NithujanSel/CameraSliderFarmLabAI/README.md

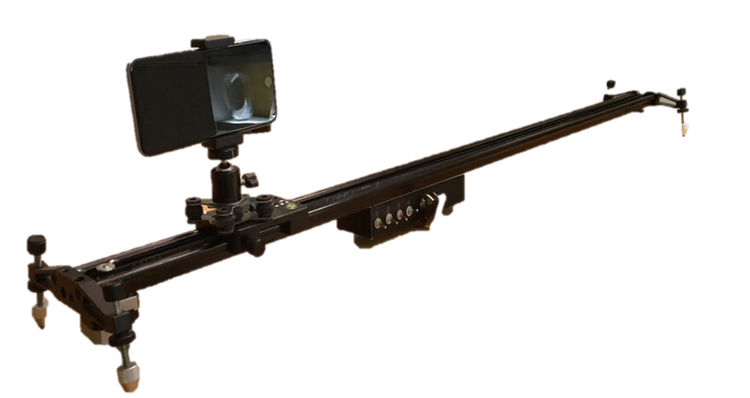
[picture p1: docs/assets/media/image1.png]


# Camera slider IoT Project

### Student 1: Nithujan Selvaratnam

### Student 2: Jesse Denaux

### Student 3: Tarun Singh

<a href="https://nithujansel.github.io/CameraSliderFarmLabAI/#/">Docsify Page</a><br>
