NithujanSel/CameraSliderFarmLabAI/docs/documentatie/index.md

# Documentatie

#  Stand

De stand moet zo ontworpen zijn zodat het profiel op een bepaalde
afstand van de grond zal gehouden worden en stevig genoeg is om het
geheel stabiel te houden. Er is gekozen om dit te 3D printen zodat de
onderzoeker vrij is in het ontwerp en snel aanpassingen kan doen indien
nodig. Het eerste ontwerp was een rechthoek waar het profiel door past
met twee beentjes die naar de grond gaan voor stabiliteit. Na een eerste
revisie werd al snel besloten om de bovenste hoeken van de rechthoek af
te kappen omdat deze geen extra nut hebben en dit enkel maar langer
duurt om te printen.

## Stand 1 v1

In het eerste ontwerp is er gekeken naar de grootte van het profiel. Om
te zien dat de stand hier vlot kan inschuiven is er een marge van 0.2 mm
genomen. Het ging hier vooral over of de stand past en of dit stevig is.
Dit is ook maar met een breedte van 1 cm geprint om ervoor te zorgen dat
dit niet zolang moest printen.

<iframe
src="https://myap83.autodesk360.com/shares/public/SH35dfcQT936092f0e43ae2769a1c0cda5d8?mode=embed"
width="640" height="480" allowfullscreen="true"
webkitallowfullscreen="true" mozallowfullscreen="true"
frameborder="0"\>\</iframe>

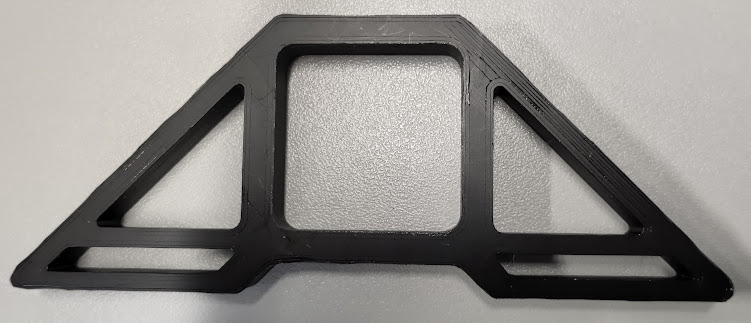
[picture p2: docs/assets/media/image6.png]
Stand 1 v1


Figuur 1: Eerste prototype profielstand 1

## Stand 1 v2

De grootte van het gat waar het profiel in past was net iets te groot.
Om dit op te lossen is het gat in de breedte en de hoogte met 0.1mm
verkleind. Voor de rest is de stevigheid van de stand perfect. Hier moet
er niets meer aan worden aangepast.

Om ervoor te zorgen dat onze slider heen en weer kan bewegen wordt er
gebruik gemaakt van een rubberen ketting. Deze ketting wordt dan met een
pulley wheel met tanden strak gehouden. Deze pulley wordt aan de stand
vastgemaakt. Hiervoor wordt er een kleine rechthoek op de stand gemaakt
waar de pulley in past.

<iframe
src="https://myap83.autodesk360.com/shares/public/SH35dfcQT936092f0e43b2dbe0e7d11261af?mode=embed"
width="640" height="480" allowfullscreen="true"
webkitallowfullscreen="true" mozallowfullscreen="true"
frameborder="0"\>\</iframe>

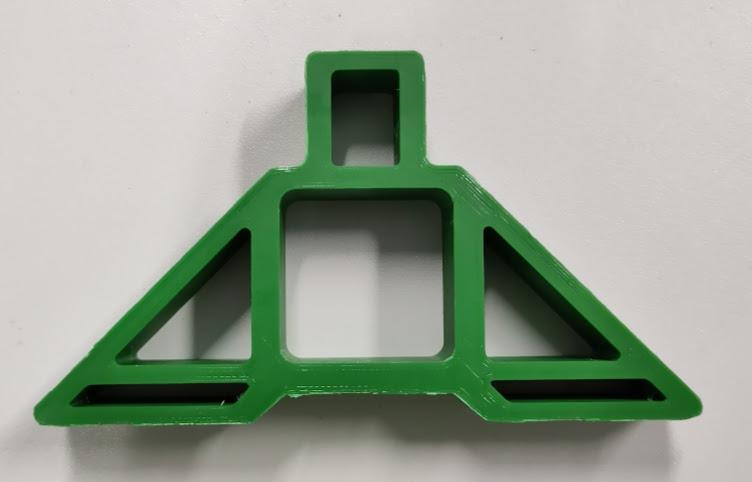
[picture p3: docs/assets/media/image7.png]
Stand 1 v2


Figuur 2: Tweede prototype profielstand 1

## Stand 1 v3

Het rechthoek van de pulley is nog net iets te groot. Hierdoor kan de
pulley een beetje in de breedte bewegen. Er is een speling van 1.87mm.
De rechthoek wordt verkleind met 1mm in de breedte zodat de pulley
minder speling heeft. De hoogte van de stand wordt 2mm groter gemaakt
zodat het profiel iets hoger van de grond is. Als laatste waren de gaten
waar de bout doorgaat om de pulley vast te hangen niet op gelijke
hoogte. Dit was een verschil van 0.2mm wat niet zo groot is maar dit was
wel zichtbaar met het oog.

Om ervoor te zorgen dat de stand aan het profiel kan worden vastgemaakt
is er in het midden aan de onderkant een opening gemaakt waar een bout
door kan. Met een moer kan dit dan aan het profiel worden vatgemaakt.

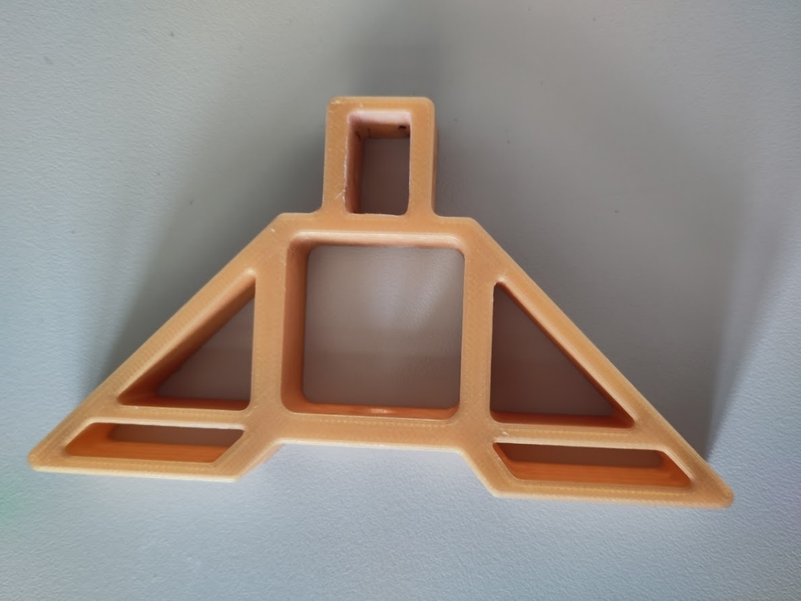
[picture p4: docs/assets/media/image8.jpeg]
Stand 1 v3


Figuur 3: Derde prototype profielstand 1

## Stand 1 v4

De slider krijgt ook een plaat aan de onderkant van het profiel.
Hierdoor moet de stand zijn benen iets langer worden gemaakt zodat de
plaat onder het profiel past zonder dat de onderplaat of de bouten de
grond raken.

<iframe
src="https://myap83.autodesk360.com/shares/public/SH35dfcQT936092f0e43e49b220a03c161df?mode=embed"
width="640" height="480" allowfullscreen="true"
webkitallowfullscreen="true" mozallowfullscreen="true"
frameborder="0"\>\</iframe>

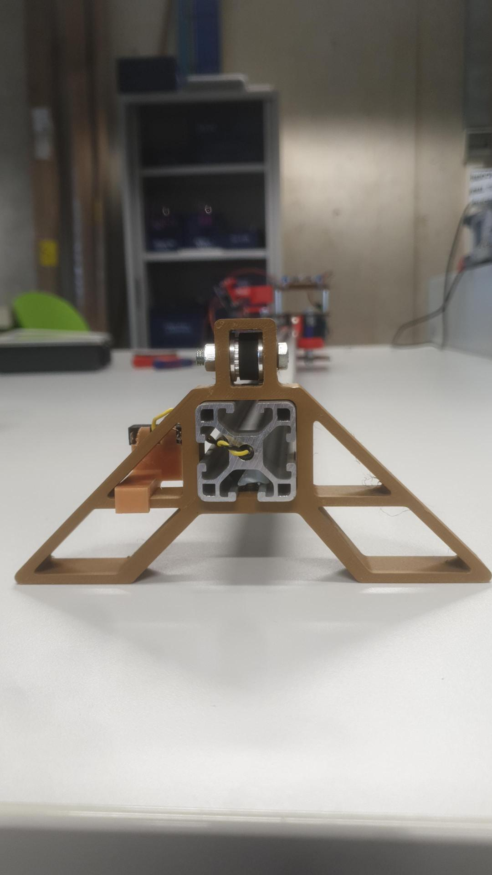
[picture p5: docs/assets/media/image9.jpeg]
A picture containing indoor, wall, floor, room Description automatically generated


Figuur : Vierde prototype profielstand 1

##  Stand 2 v1

Stand 2 is de stand waar de stepper motor bevestigd wordt. Hierdoor
wordt het gewicht op de slider verlaagd. Om dit te ontwerpen wordt er
verder gebouwd op stand 1 v2. Het gat van de pulley wordt wat vergroot
omdat de pulley van aan de motor is groter. Daarnaast wordt er een
plateau gemaakt waar de stepper motor op kan staan. De stepper motor
wordt bevestigd aan twee pilaren die mee op het plateau staan.

<iframe
src="https://myap83.autodesk360.com/shares/public/SH35dfcQT936092f0e43f48ecade61b5d065?mode=embed"
width="640" height="480" allowfullscreen="true"
webkitallowfullscreen="true" mozallowfullscreen="true"
frameborder="0"\>\</iframe>

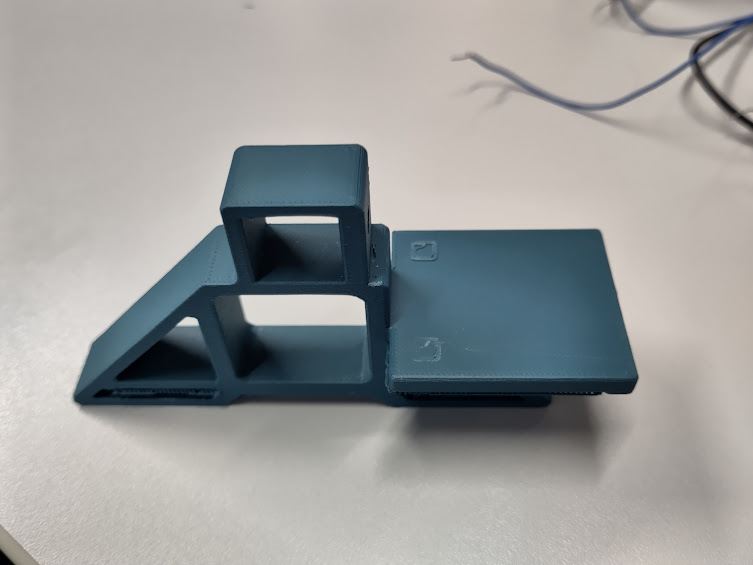
[picture p6: docs/assets/media/image10.png]


Figuur 5: Eerste prototype profielstand 2

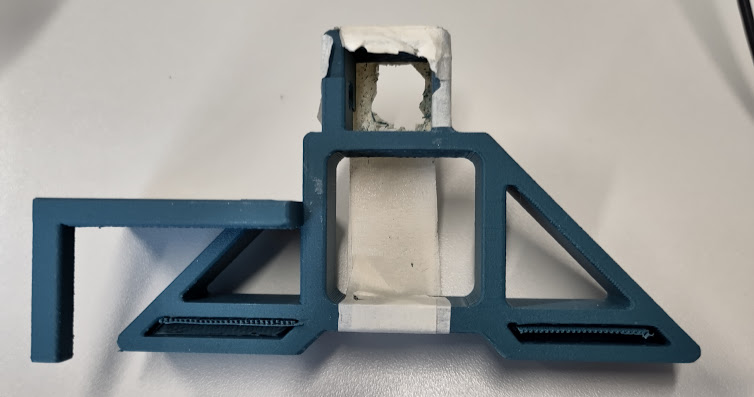
[picture p7: docs/assets/media/image11.png]


Figuur 6: Eerste prototype profielstand 2

##  Stand 2 v2

Doordat het plateau breder is dan de stand, moet de printrichting 90
graden draaien. Hierdoor was er veel support nodig. De infill was ook
maar 15% waardoor de pilaren op het plateau niet stevig genoeg waren. Om
dit te verbeteren is er gekozen om een plaat te maken waarbij er nog kan
gekozen worden op welke plaats de stepper motor kan vast gemaakt worden.
Het plateau was nog iets te laag waardoor de stepper motor wat zweefde.

Daarnaast is het gat waar de cilinder van de stepper motor doorgaat iets
te smal waardoor deze te veel wrijft tegen de kant wanneer de stepper
motor draait. Deze zal iets groter gemaakt moeten worden. De hoogte van
de stand wordt 2mm groter gemaakt zodat het profiel iets hoger van de
grond is.

Omdat versie 1 5u30 duurde om te printen en zeer veel support had is dit
rechtopstaand geprint en is het printen 90 graden gedraaid waardoor dit
nog 4u30 was.

<iframe
src="https://myap83.autodesk360.com/shares/public/SH35dfcQT936092f0e439ae8add0f062906b?mode=embed"
width="640" height="480" allowfullscreen="true"
webkitallowfullscreen="true" mozallowfullscreen="true"
frameborder="0"\>\</iframe>

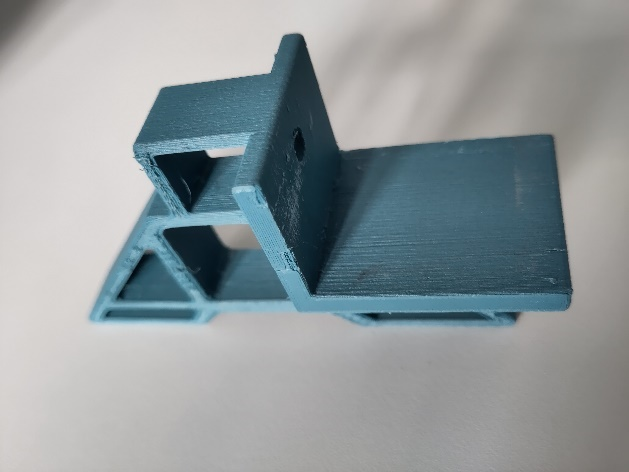
[picture p8: docs/assets/media/image12.jpeg]


Figuur 7: Tweede prototype profielstand 2

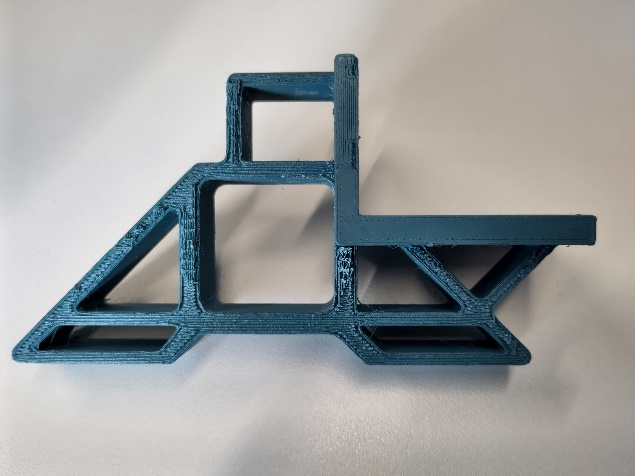
[picture p9: docs/assets/media/image13.jpeg]


Figuur 8: Tweede prototype profielstand 2

## Stand 2 v3

De plaat waar de steppermotor aan zal worden vastgemaakt was iets te
klein waardoor de bovenste schroef gaten niet in de plaat konden worden
vastgemaakt. Deze is 1cm hoger gemaakt zodat de bovenste gaten van de
stepperdriver ook konden worden vastgemaakt aan de plaat. Door een model
in te laden van de steppermotor zijn de gaten waarmee de steppermotor
wordt vastgemaakt aan de plaat exact kunnen worden gemaakt. Hierdoor
moeten deze niet achteraf worden gemaakt met onnauwkeurigheden tot
gevolg.

Ondanks dat er al 1u van de print tijd is afgegaan was dit nog zeer lang
om te printen. Na even na te denken hoe dit nog korter kan is er beslist
om de gehele structuur, exclusief het plateau waar de stepper motor
opstaat en de plaat waar deze wordt aanvast gemaakt, te verschuiven naar
de buitenkant zodat deze support al weg valt. Dit heeft ons nog eens
1u10 gespaard.

<iframe
src="https://myap83.autodesk360.com/shares/public/SH35dfcQT936092f0e4392542b71d75bd2cf?mode=embed"
width="640" height="480" allowfullscreen="true"
webkitallowfullscreen="true" mozallowfullscreen="true"
frameborder="0"\>\</iframe>

<iframe
src="https://myap83.autodesk360.com/shares/public/SH35dfcQT936092f0e43b83f0e30fe6a2534?mode=embed"
width="640" height="480" allowfullscreen="true"
webkitallowfullscreen="true" mozallowfullscreen="true"
frameborder="0"\>\</iframe>

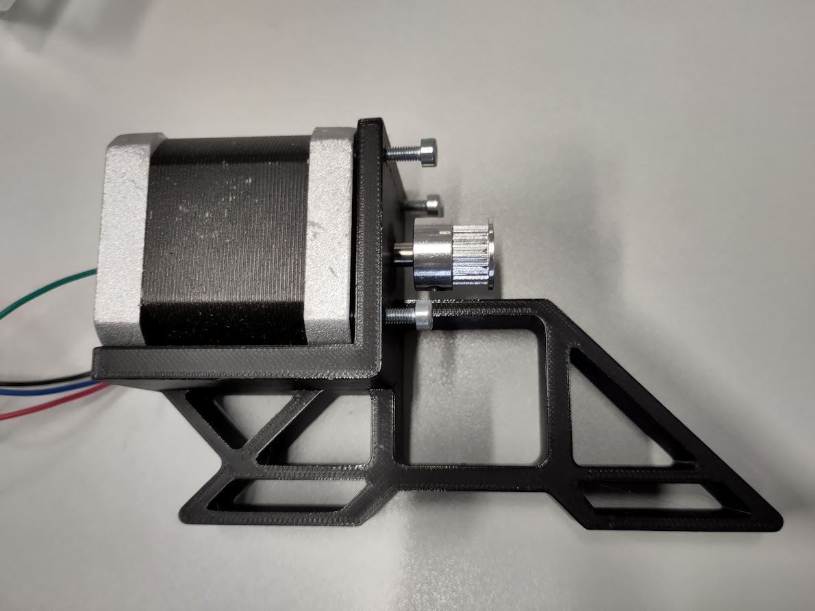
[picture p10: docs/assets/media/image14.jpeg]


Figuur 9: Derde prototype profielstand 2

## Stand 2 v4

Omdat er momenteel geen plaats is voorzien voor de pcb van de stepper
motor wordt er aan de kant waar het profiel staat een vlak voorzien waar
de pcb gemonteerd kan worden. Dit vlak is evenhoog als de stepper motor
en komt tot ongeveer de helft van de stand.

Daarnaast past de stepper motor niet volledig in de houder. Door het gat
in het midden iets dieper te maken past de stepper motor exact in de
stand zonder deze er geforceerd in te moeten duwen.

<iframe
src="https://myap83.autodesk360.com/shares/public/SH35dfcQT936092f0e43f99cfb0328ce6f20?mode=embed"
width="640" height="480" allowfullscreen="true"
webkitallowfullscreen="true" mozallowfullscreen="true"
frameborder="0"\>\</iframe>

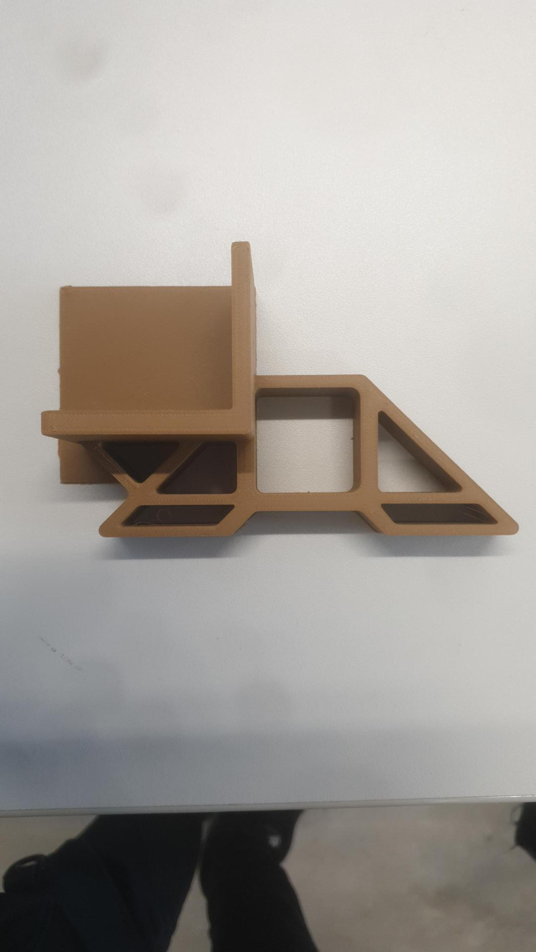
[picture p11: docs/assets/media/image15.jpeg]
A wooden chair on a shelf Description automatically generated with low confidence


Figuur : Vierde prototype profielstand 2

## Stand 2 v5

Om ervoor te zorgen dat het draadloos opladen mee in de buurt zit van de
pcb en de stepper motor wordt er op de plaat waar de PCB komt de
afmetingen van de koperdraden uit de plaat weggehaald. Zo kunnen de
koperdraden mee op de stand zitten en steken deze niet uit.

Omdat de PCB nu niet meer op zijn oorspronkelijke plaats kan zitten moet
er hiervoor een oplossing gezorgd worden. Deze zal in v6 worden
toegevoegd.

<iframe
src="https://myap83.autodesk360.com/shares/public/SH35dfcQT936092f0e43657f28746800ab4d?mode=embed"
width="640" height="480" allowfullscreen="true"
webkitallowfullscreen="true" mozallowfullscreen="true"
frameborder="0"\>\</iframe>

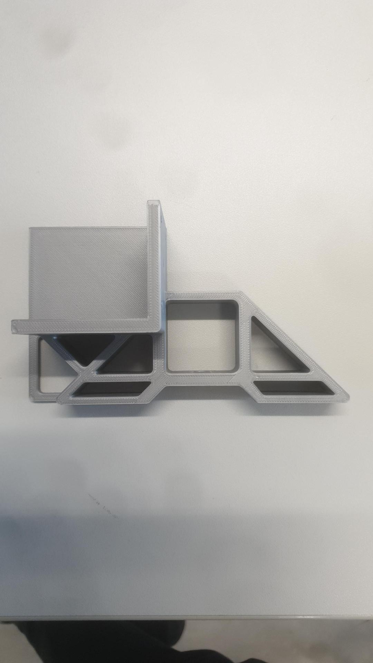
[picture p12: docs/assets/media/image16.jpeg]


Figuur : Vijfde prototype profielstand 2

## Stand 2 v6

Er zijn verschillende plekken waar de PCB zou kunnen worden gemonteerd.
Deze kan aan de tegenovergestelde zijde bevinden maar daar bevindt zich
ook al de houder van de eindeloopschakelaar. Een andere optie is om deze
onder de stepper motor te hangen. Hierdoor zit deze dicht bij de
steppermotor en hangen er geen lange kabels over de stand heen .
Daarnaast bevindt dit vlak er zich al dus moet er hierdoor niet super
veel worden aangepast.

Om plaats te maken voor de PCB, de condensatoren steken wat uit, wordt
er een deel van de stand hertekend. Hierdoor zijn er minder verbindingen
wat de printtijd iets inkort. Doordat het vlak waar de stepper motor
zich bevindt moet worden vergroot wordt de tijd terug wat langer. De
totaal tijd van het printen is 4u45.

<iframe
src="https://myap83.autodesk360.com/shares/public/SH35dfcQT936092f0e430fb497fd7533e4b1?mode=embed"
width="640" height="480" allowfullscreen="true"
webkitallowfullscreen="true" mozallowfullscreen="true"
frameborder="0"\>\</iframe>

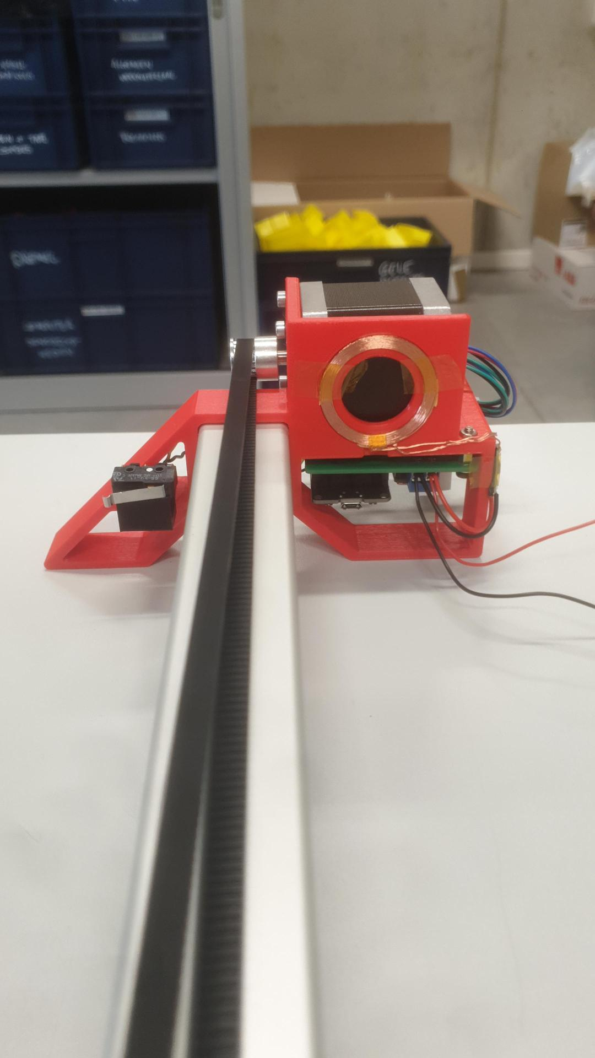
[picture p13: docs/assets/media/image17.jpeg]


Figuur : Zesde prototype profielstand 2

# Bovenplaat

De bovenplaat dient ervoor om de ESP32-CAM te dragen en via de stepper
motor op de juiste plaats te komen. De ideale slider heeft niet te veel
weerstand, waardoor de motor niet harder moet draaien, en is gemakkelijk
verstelbaar om de ideale hoogte en breedte te bekomen.

## Bovenplaat v1

Het eerste idee is om slider aan de bovenkant van het profiel te laten
schuiven. Om dit te bekomen zal de vorm van de slider gemaakt worden met
daarboven een plaat waar de ESP32-CAM op kan gemonteerd worden.

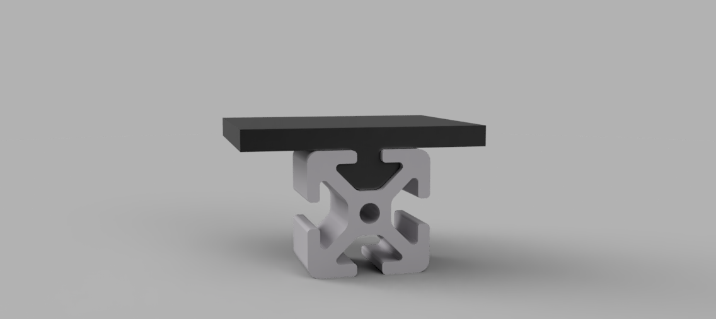
[picture p14: docs/assets/media/image18.png]
Slider v1


Figuur 13: Eerste prototype bovenplaat v1

## Bovenplaat v2

Al snel werd het duidelijk dat de bovenplaat v1 heel moeilijk gaat
worden om dit met een stepper motor heen en weer te laten gaan. Er zijn
namelijk veel plaatsen waar de bovenplaat het profiel kan raken en
hierdoor de snelheid kan verliezen. Om dit te voorkomen is het idee er
gekomen om met wieltjes te werken die aan de zijkant van het profiel
zitten en dan verbonden zijn met een plaat aan de bovenkant van het
profiel.Op de bovenplaat wordt er ook een lang horizontaal opening
voorzien om de wielen met de bouten en moeren vast te maken.

<https://a360.co/3Dki0Oa>

<iframe
src="https://student111942.autodesk360.com/shares/public/SH35dfcQT936092f0e4380715a3f6275f5af?mode=embed"
width="640" height="480" allowfullscreen="true"
webkitallowfullscreen="true" mozallowfullscreen="true"
frameborder="0"\>\</iframe>

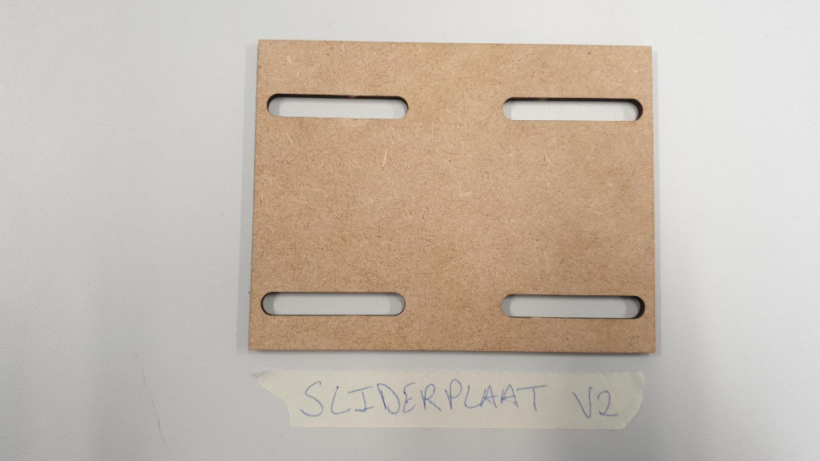
[picture p15: docs/assets/media/image19.jpeg]
Afbeelding met tekst, whiteboard Automatisch gegenereerde beschrijving


Figuur 14: Tweede prototype bovenplaat v2

## Bovenplaat v3

De openingen bij de bovenplaat versie 2 zijn langer dan het nodig is.
Daarnaast zijn de openingen ook niet symmetrisch. Bij deze versie van de
bovenplaat wordt er nog een opening voorzien om de belt vast te houden.

<https://a360.co/3TOGJ4r>

<iframe
src="https://student111942.autodesk360.com/shares/public/SH35dfcQT936092f0e4342e0d105ea0a0625?mode=embed"
width="640" height="480" allowfullscreen="true"
webkitallowfullscreen="true" mozallowfullscreen="true"
frameborder="0"\>\</iframe>

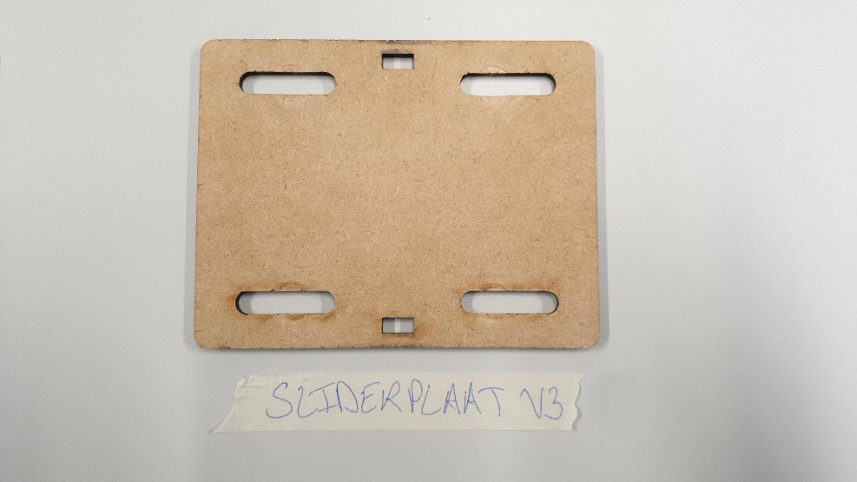
[picture p16: docs/assets/media/image20.jpeg]


Figuur 15: Derde prototype bovenplaat v3

## Bovenplaat v4

De openingen voor de belt bij versie 3 zijn niet correct. Bovendien
blijft de belt ook niet strak genoeg waardoor de plaat niet efficiënt
genoeg beweegt met de stepper motor. Hiervoor wordt er een beltholder
ontworpen. Deze beltholder wordt ook nog verder in de documentatie
beschreven.

<https://a360.co/3SLT8Vo>

<iframe
src="https://student111942.autodesk360.com/shares/public/SH35dfcQT936092f0e435d68fc45ffeb3f43?mode=embed"
width="640" height="480" allowfullscreen="true"
webkitallowfullscreen="true" mozallowfullscreen="true"
frameborder="0"\>\</iframe>

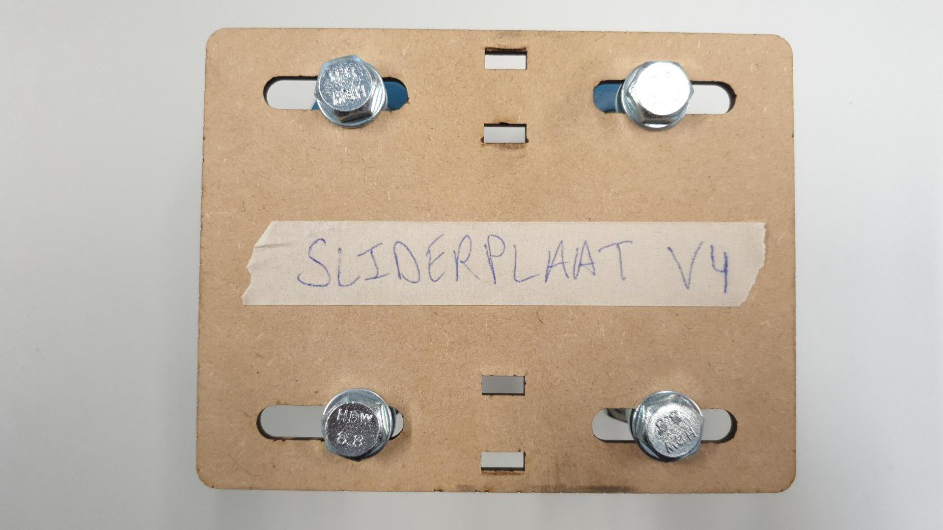
[picture p17: docs/assets/media/image21.jpeg]


Figuur 16: Vierde prototype bovenplaat v4

## Bovenplaat v5

De afmetingen van de vorige versie waren goed maar wegens de bouten en
de beltholder is er weinig plaats over op de bovenplaat. Daarom wordt er
beslist om op deze bovenplaat meerdere verdiepingen te bouwen. Hierdoor
moest deze plaat nog eens aangepast worden. De plaat kan ook verdiep 0
genoemd worden. Er worden ook gaatjes voorzien om servo motor te kunnen
monteren.

<https://a360.co/3WgE5F4>

<iframe
src="https://student111942.autodesk360.com/shares/public/SH35dfcQT936092f0e43496cd8781e36ff08?mode=embed"
width="640" height="480" allowfullscreen="true"
webkitallowfullscreen="true" mozallowfullscreen="true"
frameborder="0"\>\</iframe>

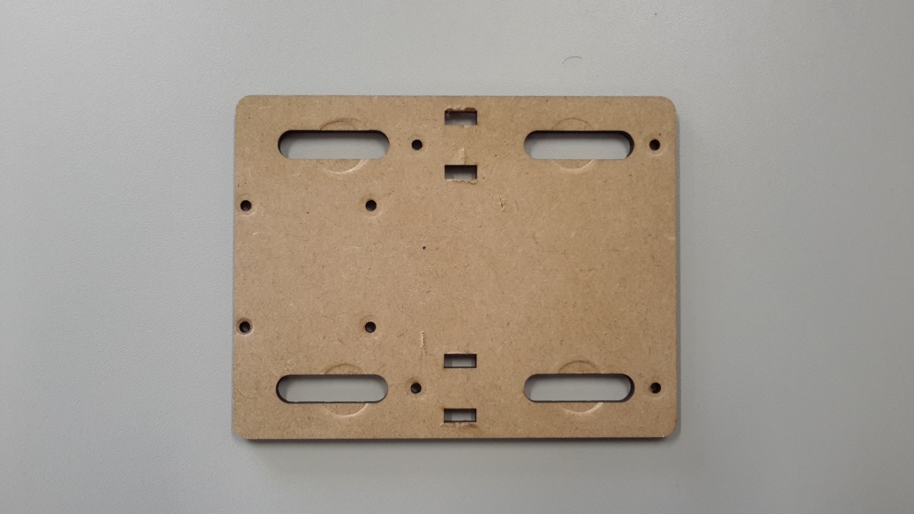
[picture p18: docs/assets/media/image22.jpeg]


Figuur : Vijfde prototype bovenplaat v5

# Verdiep 1

Verdiep 1 wordt gebuikt om de batterij, batterij oplader en step up
regulator te plaatsen. Omdat deze zaken niet zoveel plaats in beslag
nemen wordt deze plaat iets kleiner gemaakt dan de andere platen.

<https://a360.co/3QLKIxO>

<iframe
src="https://student111942.autodesk360.com/shares/public/SH35dfcQT936092f0e43437dfbfecf383527?mode=embed"
width="640" height="480" allowfullscreen="true"
webkitallowfullscreen="true" mozallowfullscreen="true"
frameborder="0"\>\</iframe>

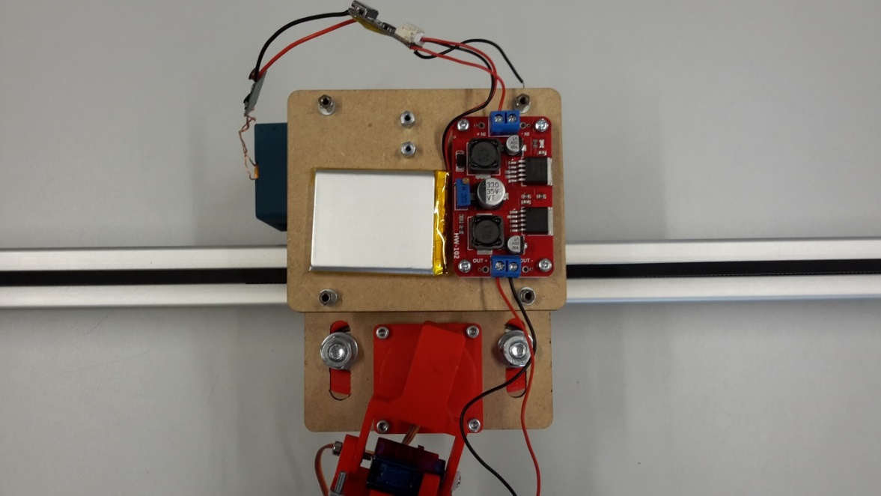
[picture p19: docs/assets/media/image23.jpeg]


Figuur : Verdiep 1 samen met andere platen

# Onderplaat

Na het aantal keren testen werd er opgemerkt dat de plaat een beetje
vibreerde. Om deze vibratie weg te werken werd er ook een onderplaat
ontworpen. Deze plaat had hetzelfde afmetingen als de bovenplaat en had
enkel de openingen nodig voor de bouten. Na het plaatsen van deze plaat
was er een grote verbetering te zien.

<https://a360.co/3iGhZ10>

<iframe
src="https://student111942.autodesk360.com/shares/public/SH35dfcQT936092f0e43c590b20d2bdb4537?mode=embed"
width="640" height="480" allowfullscreen="true"
webkitallowfullscreen="true" mozallowfullscreen="true"
frameborder="0"\>\</iframe>

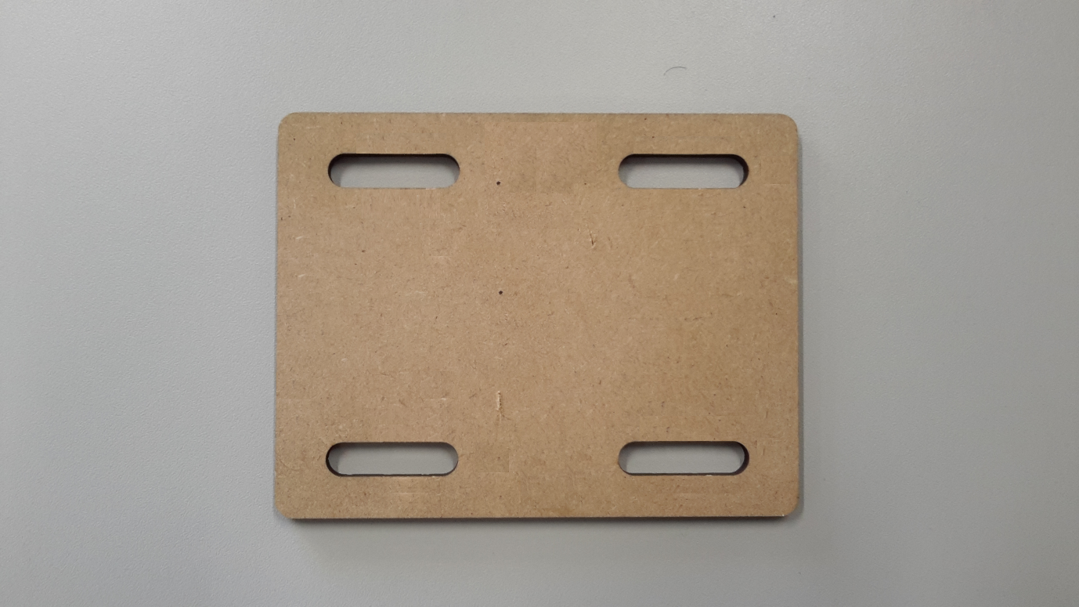
[picture p20: docs/assets/media/image24.png]
Afbeelding met accessoire, map Automatisch gegenereerde beschrijving


Figuur : Onderplaat

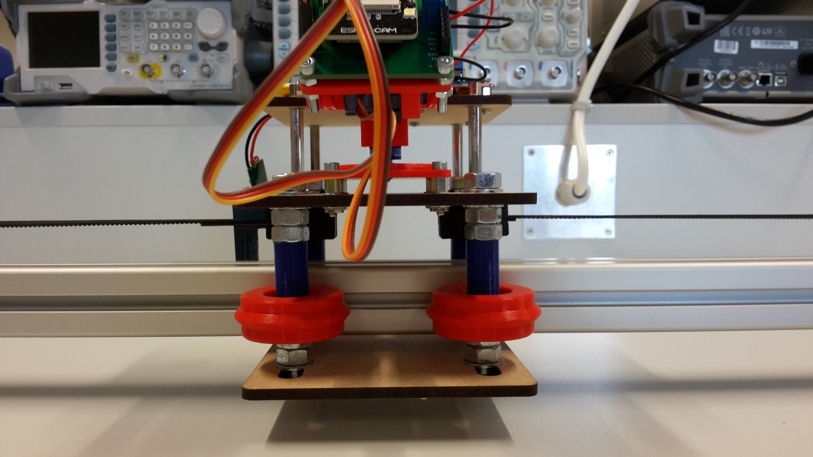
[picture p21: docs/assets/media/image25.jpeg]
Afbeelding met apparaat, freesbank Automatisch gegenereerde beschrijving


Figuur : Alle platen samen

# Wielen

De wielen zorgen ervoor dat de bovenplaat zo goed mogelijk kan
verschuiven op het profiel met behulp van de stepper motor. Deze wielen
zijn dan ook verbonden met de bovenplaat en met de onderplaat.

## Wielen v1

De eerste iteratie van de wielen was niet zo goed gelukt. Deze wielen
werden met een 3D-printer ontworpen. De hoeken bij deze wielen zijn ook
groter dan 45 graden waardoor er support nodig was bij het printen van
de wielen. Hierdoor was de ene zijde van de wiel niet glad genoeg
waardoor het wiel niet goed geleidde in het profiel. Er was ook een
groot gat voorzien om een ball bearing erin te stoppen.

<https://a360.co/3TMWd93>

<iframe
src="https://student111942.autodesk360.com/shares/public/SH35dfcQT936092f0e439ec17b2efa92f148?mode=embed"
width="640" height="480" allowfullscreen="true"
webkitallowfullscreen="true" mozallowfullscreen="true"
frameborder="0"\>\</iframe>

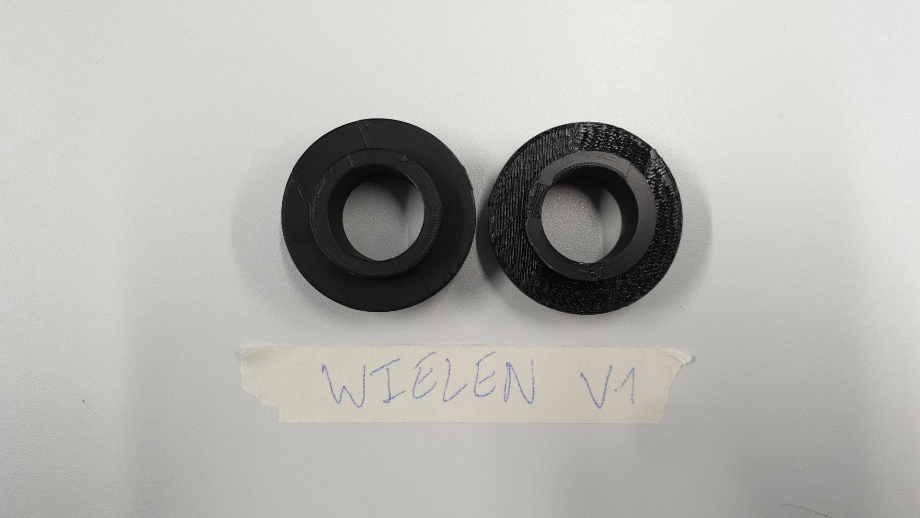
[picture p22: docs/assets/media/image26.jpeg]


Figuur 21: Eerste prototype van wielen

## Wielen v2

Bij deze versie wordt de hoek van de wielen 40 graden gehouden waardoor
er geen supports nodig waren bij de print. De wielen geleidden bij deze
versie veel beter.

<https://a360.co/3Wai0Jj>

<iframe
src="https://student111942.autodesk360.com/shares/public/SH35dfcQT936092f0e431b1d6eca1aa3e9a6?mode=embed"
width="640" height="480" allowfullscreen="true"
webkitallowfullscreen="true" mozallowfullscreen="true"
frameborder="0"\>\</iframe>

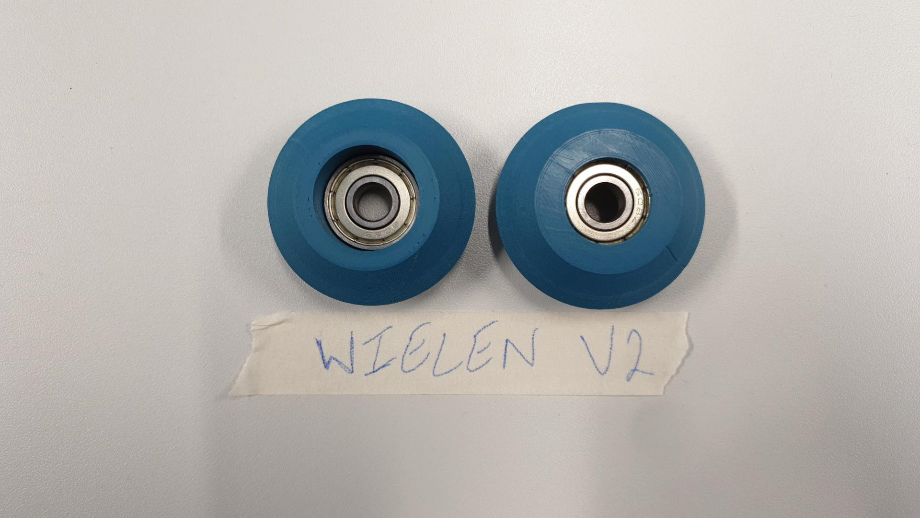
[picture p23: docs/assets/media/image27.jpeg]


Figuur 22: Tweede prototype van wielen

## Wielen v3

Bij de versie 3 van de wielen wordt er geprobeerd om de beide voorgaande
versie te combineren. Hierbij wordt het gebruik gemaakt van 90 en 40
graden hoek. Bij deze versie blijft de wiel beter vast tussen de profiel
en draait ook veel gladder.

<https://a360.co/3wbuFzQ>

<iframe
src="https://student111942.autodesk360.com/shares/public/SH35dfcQT936092f0e4378b8c6c8e64ecedf?mode=embed"
width="640" height="480" allowfullscreen="true"
webkitallowfullscreen="true" mozallowfullscreen="true"
frameborder="0"\>\</iframe>

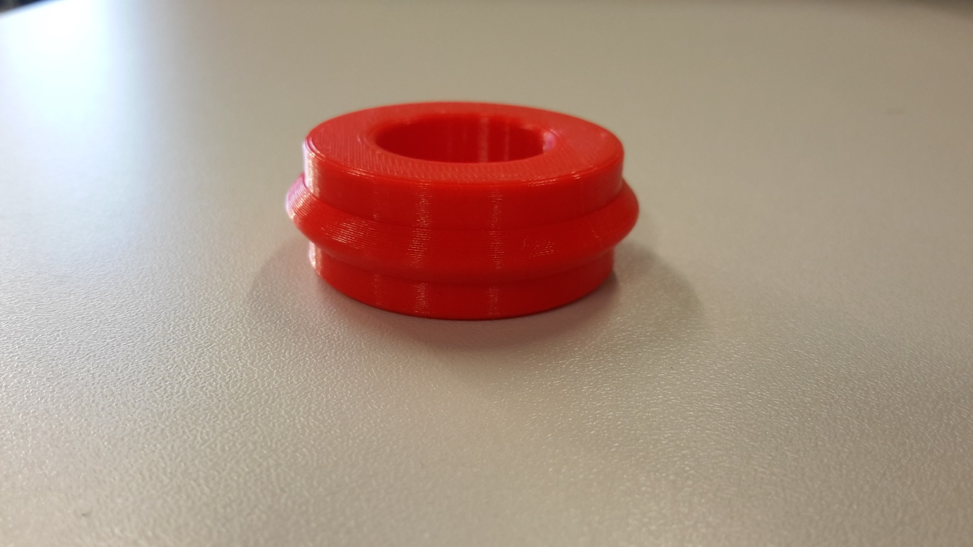
[picture p24: docs/assets/media/image28.jpeg]
Afbeelding met kamer, rood, gokhuis, toonbank Automatisch gegenereerde beschrijving


Figuur : Derde prototype van wielen

# Beltholder

Om de bovenplaat te laten bewegen met de stepper motor, heeft de
bovenplaat een beltholder nodig. Deze beltholder zorgt ervoor dat de
belt goed vast en strak zit.

## Beltholder v1

Het eerste idee was om de beltholder onder de sliderplaat te monteren.
Maar dit was niet goed gelukt aangezien de belt recht moet blijven en
niet zijdelings geplaatst moet worden. Hierdoor moest er een nieuw
design aangemaakt worden.

<https://a360.co/3WcsO9W>

<iframe
src="https://student111942.autodesk360.com/shares/public/SH35dfcQT936092f0e43c360ca5dfbcf77be?mode=embed"
width="640" height="480" allowfullscreen="true"
webkitallowfullscreen="true" mozallowfullscreen="true"
frameborder="0"\>\</iframe>

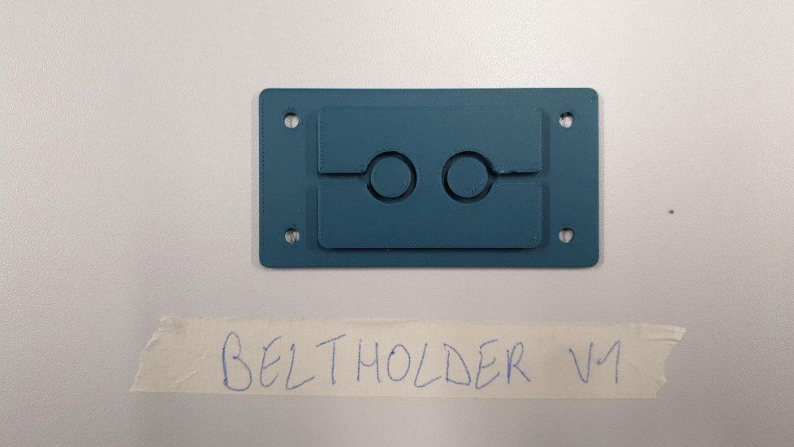
[picture p25: docs/assets/media/image29.jpeg]


Figuur 24: Eerste prototype beltholder v1

## Beltholder v2

Bij de versie 2 wordt de beltholder in een vorm van een rechthoek
gemaakt voor linkse kant en voor de rechtse kant. De linkse beltholder
wordt eerst ontwerpt. Er worden ook twee klemmen gemaakt zodat deze
makkelijk op de bovenplaat geklemd kan worden. Deze beltholder was
gewoon te breed en de klemmen waren ook te klein. Omdat de klemmen niet
breed genoeg waren gingen ze kapot tijdens het inklemmen.

<https://a360.co/3Wdkbf3>

<iframe
src="https://student111942.autodesk360.com/shares/public/SH35dfcQT936092f0e4329a9872ad8d497eb?mode=embed"
width="640" height="480" allowfullscreen="true"
webkitallowfullscreen="true" mozallowfullscreen="true"
frameborder="0"\>\</iframe>

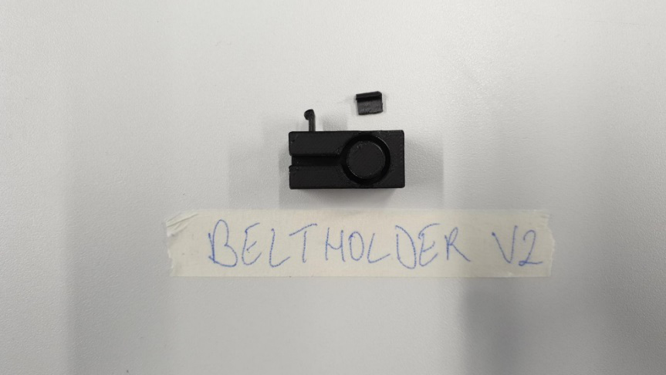
[picture p26: docs/assets/media/image30.jpeg]


Figuur 25: Tweede prototype beltholder v2

## Beltholder v3

Hier wordt de vorige versie nog verbeterd door de afmetingen te
veranderen. Aangezien deze een juiste versie is, werd er ook de meteen
de rechtse versie van de beltholder gemaakt en geprint.

<https://a360.co/3Wp6vMS>

<iframe
src="https://student111942.autodesk360.com/shares/public/SH35dfcQT936092f0e43d4ae3c73b7d5fd8d?mode=embed"
width="640" height="480" allowfullscreen="true"
webkitallowfullscreen="true" mozallowfullscreen="true"
frameborder="0"\>\</iframe>

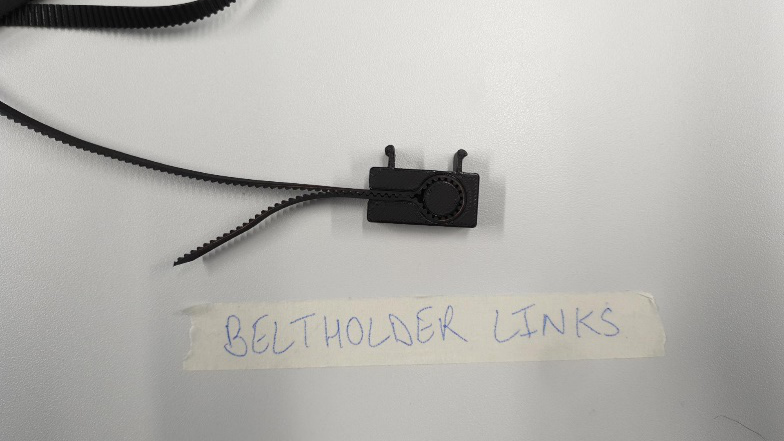
[picture p27: docs/assets/media/image31.jpeg]


Figuur 26: Derde prototype beltholder links v3

<https://a360.co/3TFi4z7>

<iframe
src="https://student111942.autodesk360.com/shares/public/SH35dfcQT936092f0e43878fc8073f3354cd?mode=embed"
width="640" height="480" allowfullscreen="true"
webkitallowfullscreen="true" mozallowfullscreen="true"
frameborder="0"\>\</iframe>

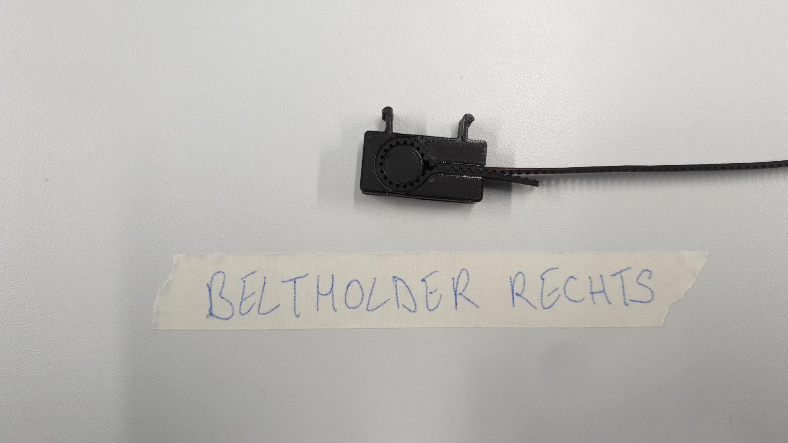
[picture p28: docs/assets/media/image32.jpeg]


Figuur 27: Derde prototype beltholder rechts

# Beltholder tester

Om de juiste opening voor de klemmen te zoeken werd er een beltholder
tester ontworpen. Deze heeft meerdere openingen zodat de juiste opening
gekozen kan worden en bij de bovenplaat toegevoegd kan worden.

## Beltholder tester v1

De tester had openingen die veel te groot waren en soms veel te smal
waren waardoor de klemmen van de belthoder niet goed vast zaten in de
tester.

<https://a360.co/3CUi8on>

<iframe
src="https://student111942.autodesk360.com/shares/public/SH35dfcQT936092f0e433ca724763cdf6763?mode=embed"
width="640" height="480" allowfullscreen="true"
webkitallowfullscreen="true" mozallowfullscreen="true"
frameborder="0"\>\</iframe>

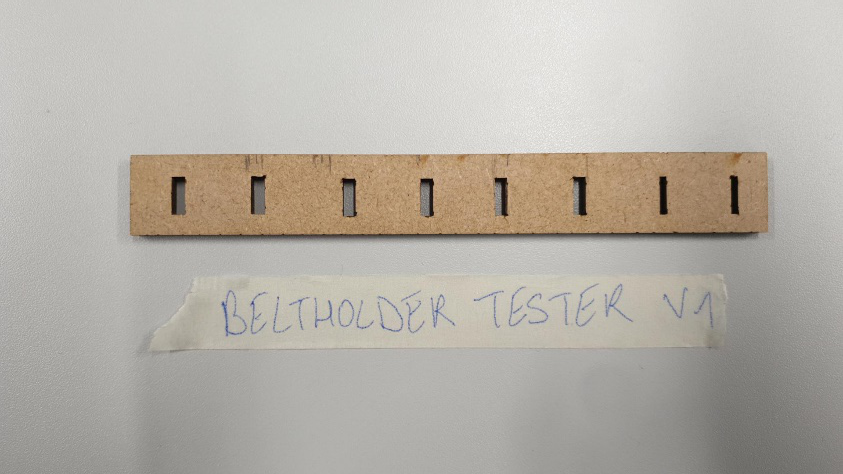
[picture p29: docs/assets/media/image33.jpeg]


Figuur 28: Eerste prototype beltholder tester v1

## Beltholder tester v2

Bij deze versie werden de exacte afmetingen genomen van beltholder en
bij elke nieuwe opening werd de opening 0.2 mm vergroot. De tweede
opening was perfect voor de beltholder.

<https://a360.co/3IUawWK>

<iframe
src="https://student111942.autodesk360.com/shares/public/SH35dfcQT936092f0e43c4b96c1b749c06bb?mode=embed"
width="640" height="480" allowfullscreen="true"
webkitallowfullscreen="true" mozallowfullscreen="true"
frameborder="0"\>\</iframe>

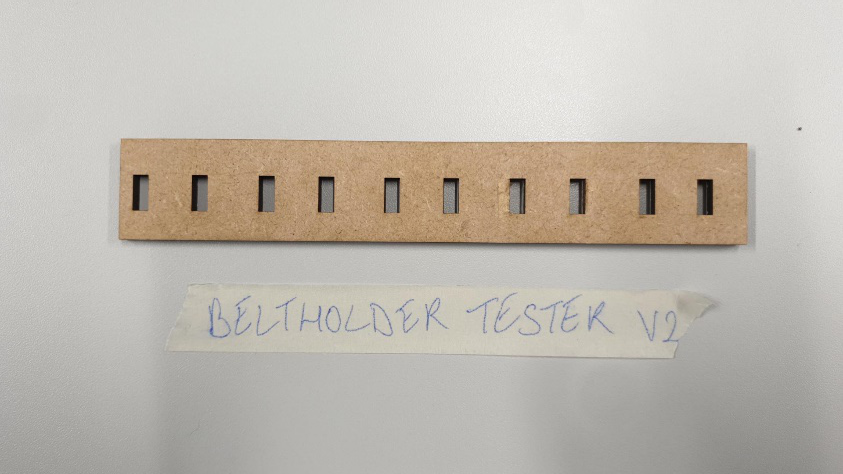
[picture p30: docs/assets/media/image34.jpeg]


Figuur 29: Tweede prototype beltholder testser v2

# Buisje

Bij het testen van de wielen, veranderen van de platen, uithalen van
beltholder moet er elke keer bouten en moeren los gemaakt worden en
terug vast gemaakt worden met juiste afstanden. Om dit proces te
versnellen en te vergemakkelijken wordt er een buisje ontworpen die
tussen de bouten en de platen komt. Deze buisje zorgt ervoor dat de
afstand altijd hetzelfde blijft.

## Buisje v1

Bij de eerste iteratie is de lengte van het buisje te klein en de
diameter is smal.

<https://a360.co/3Hd4n6w>

<iframe
src="https://student111942.autodesk360.com/shares/public/SH35dfcQT936092f0e43a4cd6125c2b1d4a7?mode=embed"
width="640" height="480" allowfullscreen="true"
webkitallowfullscreen="true" mozallowfullscreen="true"
frameborder="0"\>\</iframe>

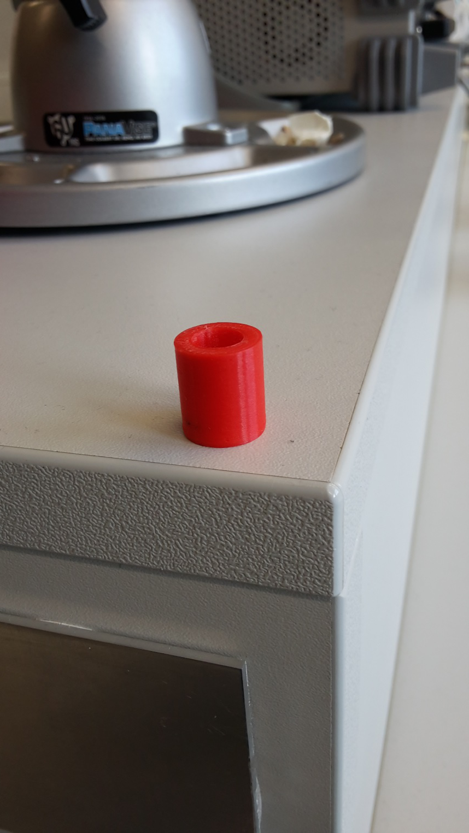
[picture p31: docs/assets/media/image35.jpeg]
Afbeelding met binnen, toonbank, keukenapparaat Automatisch gegenereerde beschrijving


Figuur : Eerste prototype buisje

## Buisje v2

In deze versie van het buisje worden de fouten van de eerste iteratie
verbeterd door de diameter met 0.9mm te verhogen en de lengte met 13mm
te verhogen.

<https://a360.co/3H8XgMu>

<iframe
src="https://student111942.autodesk360.com/shares/public/SH35dfcQT936092f0e4345e1db4642d690cd?mode=embed"
width="640" height="480" allowfullscreen="true"
webkitallowfullscreen="true" mozallowfullscreen="true"
frameborder="0"\>\</iframe>

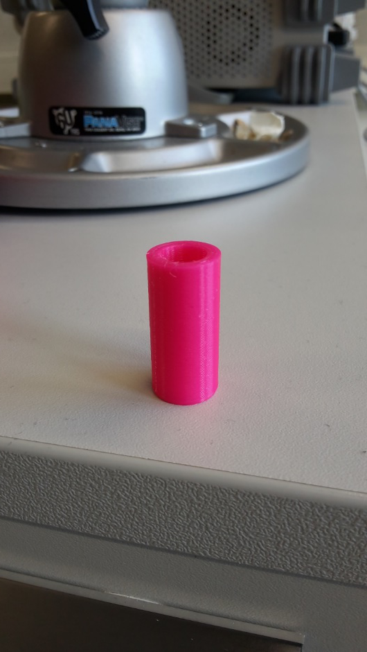
[picture p32: docs/assets/media/image36.jpeg]
Afbeelding met binnen, keukenapparaat Automatisch gegenereerde beschrijving


Figuur : Tweede prototype buisje

# Slider

Als we alle voorgaande componenten combineren krijgen we het volgende:

<https://a360.co/3ksLZh3>

<iframe
src="https://student111942.autodesk360.com/shares/public/SH35dfcQT936092f0e43b027f23da9eaa9cc?mode=embed"
width="640" height="480" allowfullscreen="true"
webkitallowfullscreen="true" mozallowfullscreen="true"
frameborder="0"\>\</iframe>

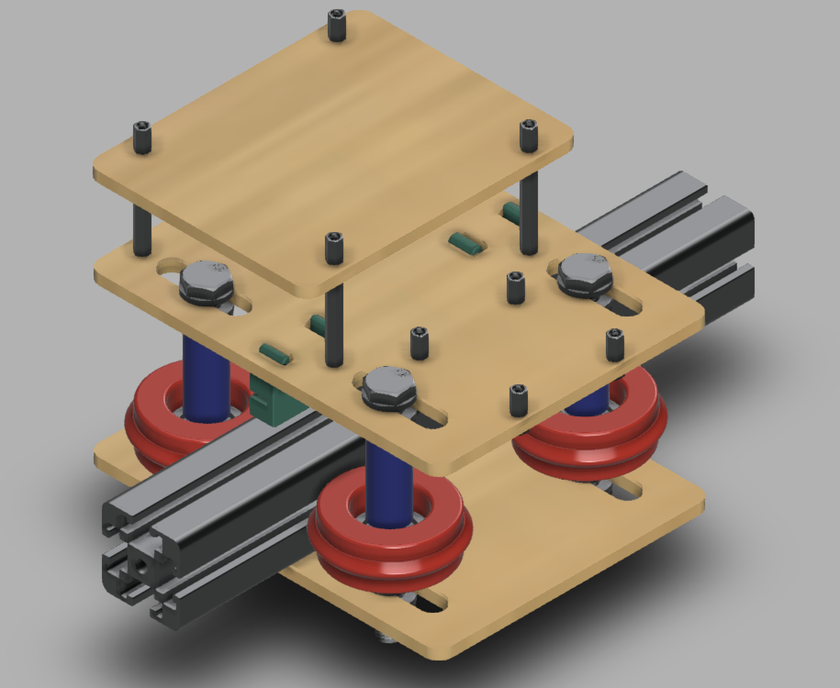
[picture p33: docs/assets/media/image37.png]
Afbeelding met muur, binnen, speelgoed Automatisch gegenereerde beschrijving


Figuur : Camera slider in 3D

# Eindeloopschakelaar houder

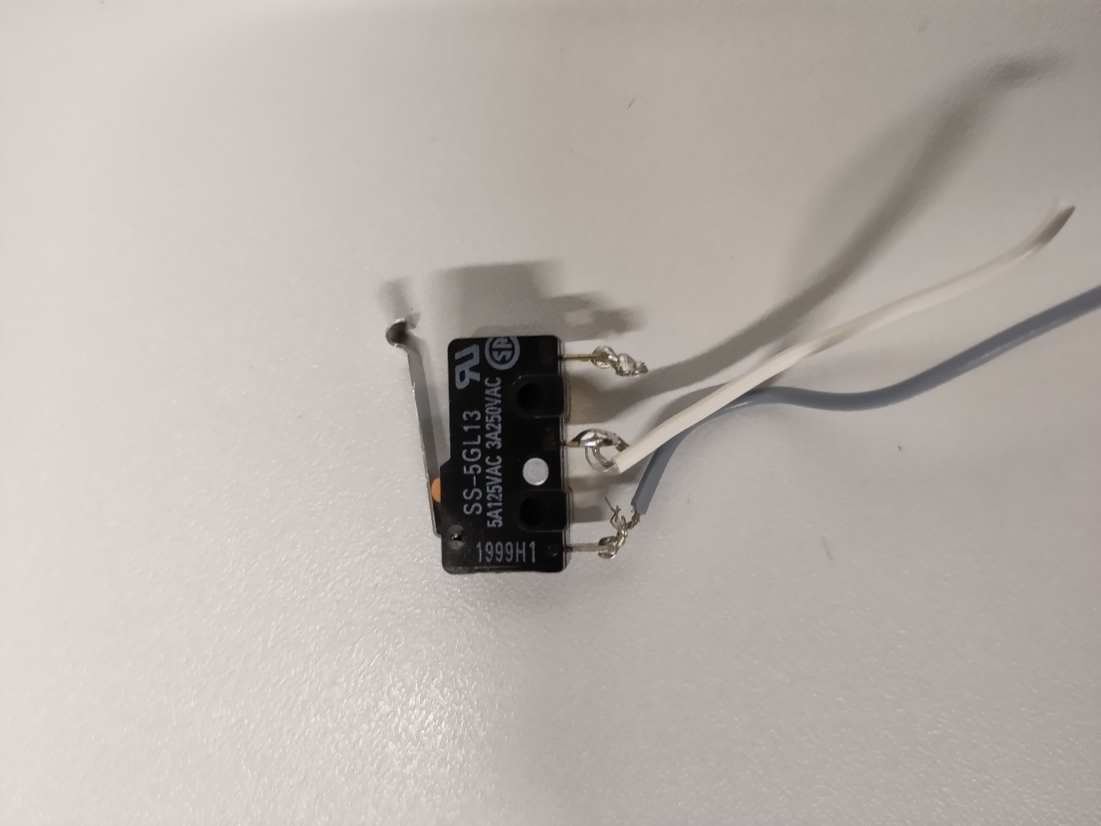
[picture p34: docs/assets/media/image38.jpeg]
A picture containing adapter Description automatically generated


Figuur 33: Eindeloopschakelaar

De eindeloopschakelaar dient ervoor om indien dat de camera slider aan
de zijkant toekomt dat deze direct stopt wanneer dat de
eindeloopschakelaar wordt ingedrukt. Om ervoor te zorgen dat de
eindeloopschakelaar op de juiste plaats hangt wordt er een houder ge-3D
print.

## Eindeloopschakelaar houder v1

Er zijn enkele zaken waaraan gedacht moeten worden bij het maken van de
eindeloopschakelaar. Eerst en vooral moet er worden gezien dat de houder
op de juiste plaats zit zodat het profiel van de stand zich op een
perfecte hoogte ten opzichte van de eindeloopschakelaar bevindt. Daarom
wordt er besloten om een houder te maken die op de stand kan worden
bevestigd. De houder moet vast genoeg zijn om de eindeloopschakelaar
vast te houden terwijl de houder op de stand is bevestigd. Om dit te
bekomen heeft de houder een soort van klip om over het profiel van de
stand te kunnen klikken.

Om de eindeloopschakelaar vast te houden op de houder worden er twee
kleine balkjes voorzien aan de voorkant en achterkant zodat de
eindeloopschakelaar daartussen kan worden geklikt.

Omdat de twee standen een verschillende breedte hebben worden er twee
versies gemaakt met een verschillende breedte. Ze zijn ook gespiegeld
van elkaar. Voor de rest is alles hetzelfde.

Om de print tijd in te korten zit er een gat in de houder.

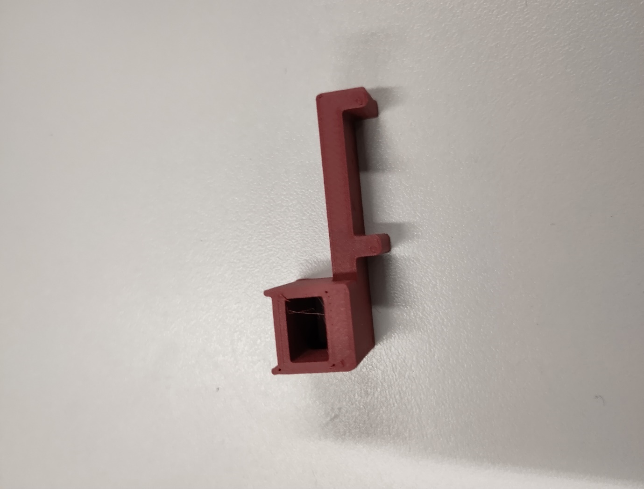
[picture p35: docs/assets/media/image39.jpeg]
A red letter on a white surface Description automatically generated with low confidence


Figuur 34: Eindeloopschakelaar houder v1

<iframe
src="https://myap83.autodesk360.com/shares/public/SH35dfcQT936092f0e43582b4e80aab45c0f?mode=embed"
width="640" height="480" allowfullscreen="true"
webkitallowfullscreen="true" mozallowfullscreen="true"
frameborder="0"\>\</iframe>

## Eindeloopschakelaar houder v2

Het principe van v1 was zeer goed. Enkel bleef de eindeloopschakelaar
niet perfect op de houder zitten. Dit komt doordat de houder niet overal
even breed is. Om dit op te lossen wordt de balk vanvoor aangepast zodat
deze twee verschillende diktes heeft. Daarnaast krijgt de achterkant een
hogere balk zodat de houder beter blijft zitten.

Iets anders dat is aangepast is het klip systeem. Dit was in v1 niet
strak genoeg om de houder goed vast te zetten. In v2 is dit nog iets
beter gemaakt zodat de houder strak genoeg op de stand kan worden
bevestigd en er niet af valt wanneer het wagentje er tegen komt.

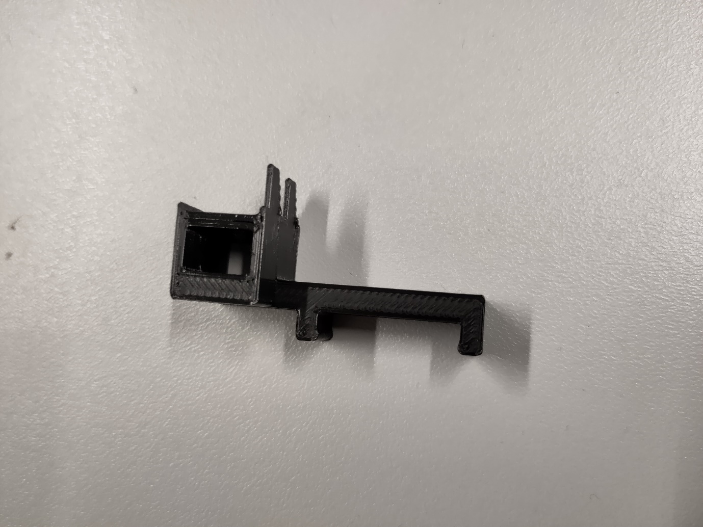
[picture p36: docs/assets/media/image40.jpeg]


Figuur 35: Eindeloopschakelaar houder v2

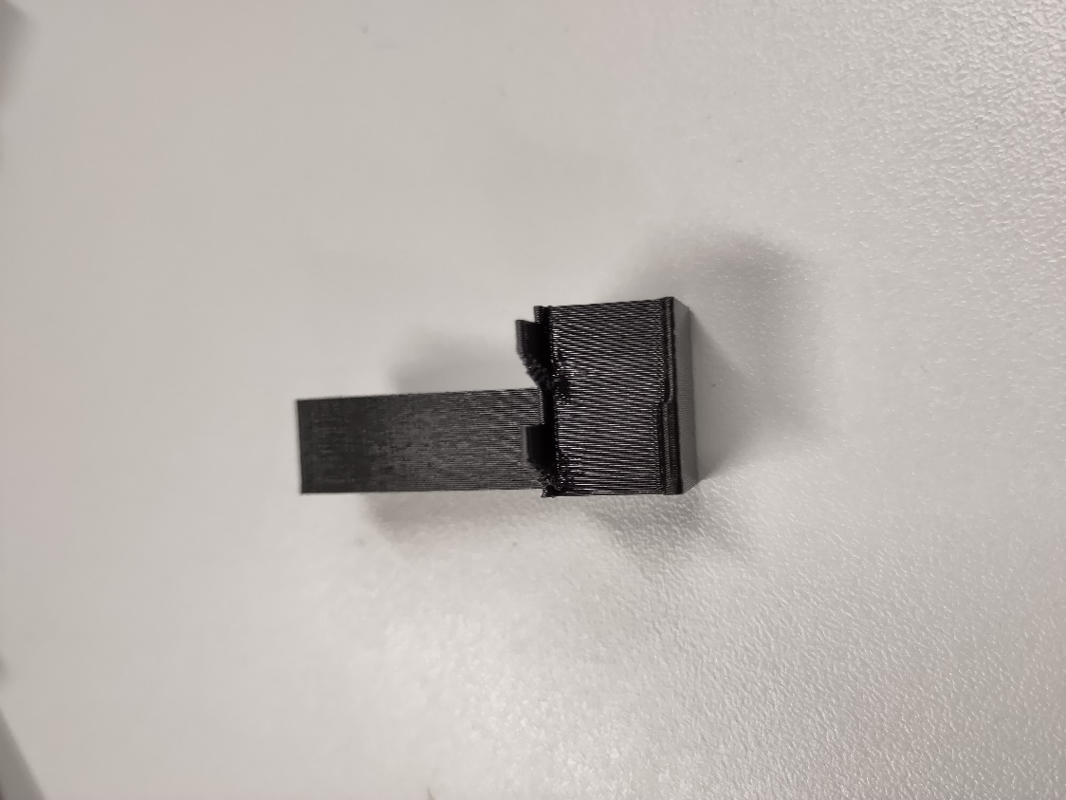
[picture p37: docs/assets/media/image41.jpeg]
A picture containing wall Description automatically generated


Figuur 36: Eindeloopschakelaar houder v2

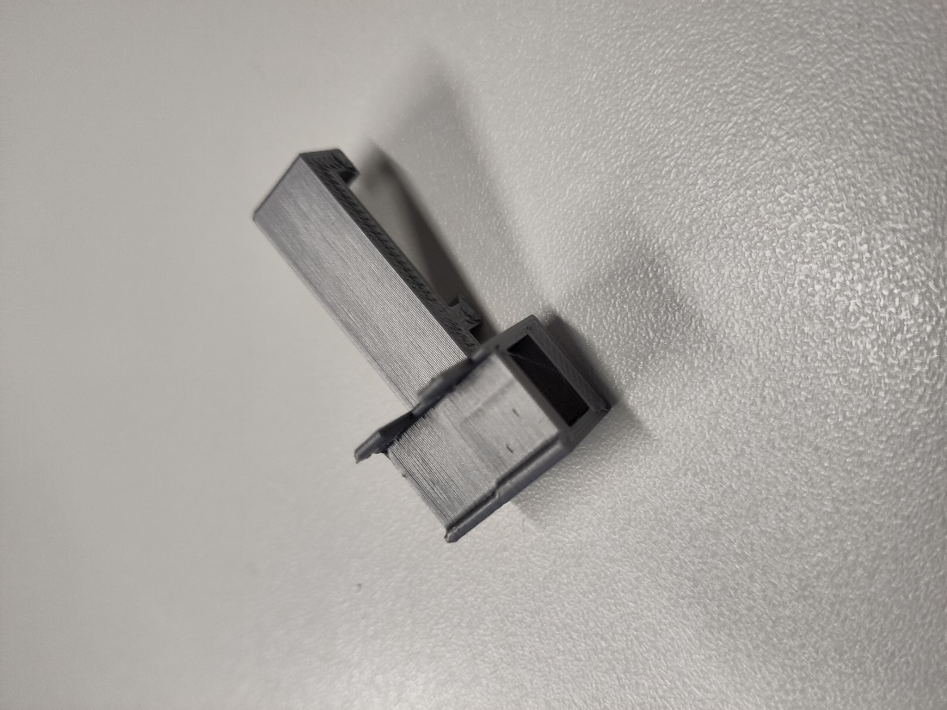
[picture p38: docs/assets/media/image42.jpeg]


Figuur 37: Eindeloopschakelaar houder v2

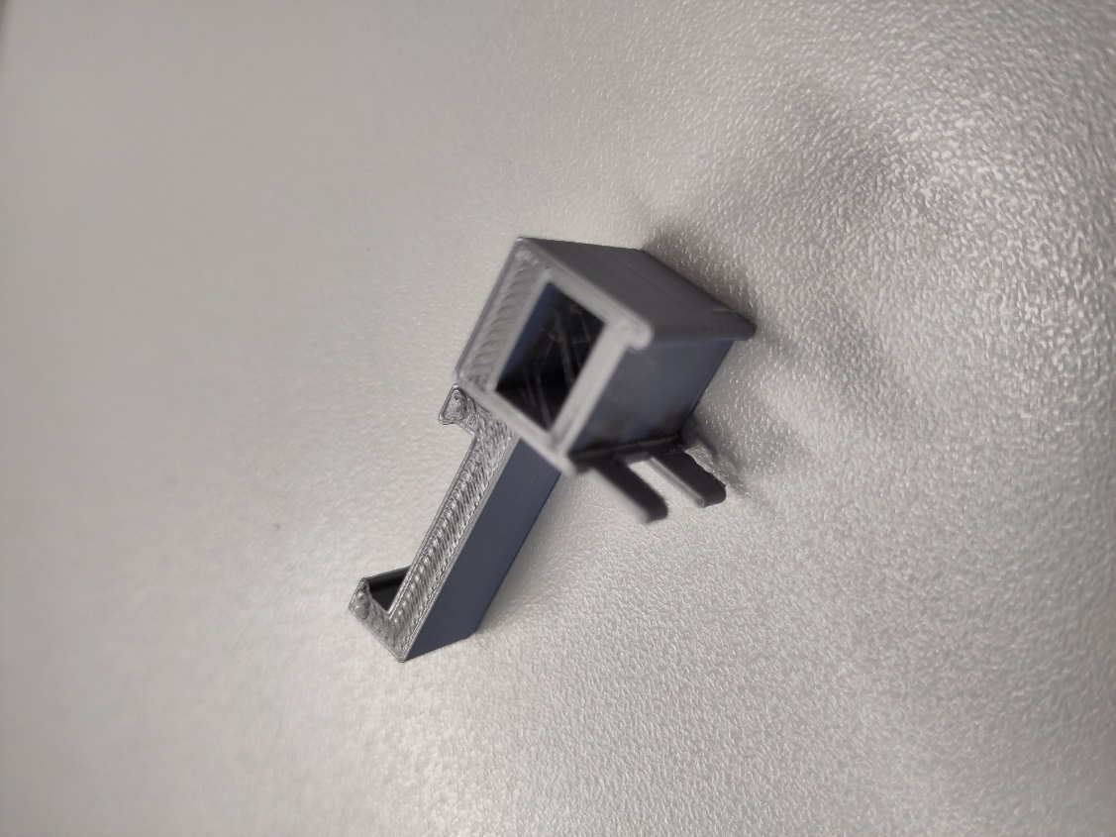
[picture p39: docs/assets/media/image43.jpeg]


Figuur 38: Eindeloopschakelaar houder v2

<iframe
src="https://myap83.autodesk360.com/shares/public/SH35dfcQT936092f0e43f69fbfcf3b698b16?mode=embed"
width="640" height="480" allowfullscreen="true"
webkitallowfullscreen="true" mozallowfullscreen="true"
frameborder="0"\>\</iframe>

# Alle iteraties

Onderstaande foto toont al de verschillende iteraties van de
verschillende ontwerpen.

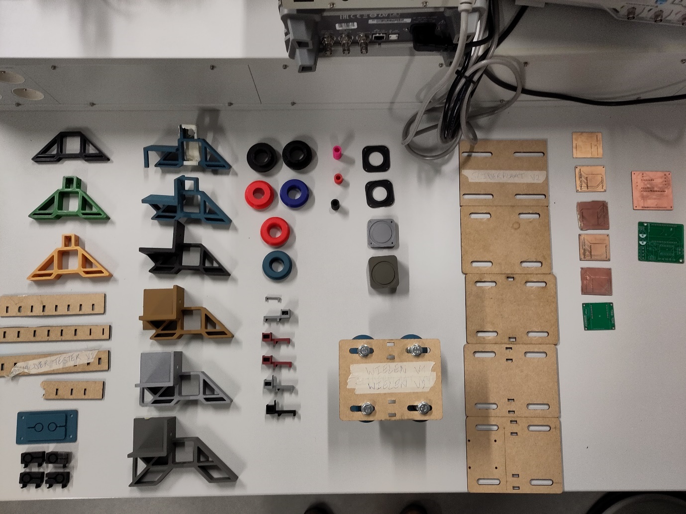
[picture p40: docs/assets/media/image44.jpeg]


Figuur 39: Alle iteraties van 3D prints en lasercuts

# Pan en Tilt Systeem

## Camera

In de ontwikkeling van een camera slider is de keuze van de camera een
cruciale stap. Na overweging van verschillende opties, is de ESP32-CAM
uiteindelijk geselecteerd als de camera van de slider. Dit is
voornamelijk te danken aan zijn compacte formaat en efficiënte
energieverbruik. De ESP32-CAM is een kleine module die voldoet aan de
eisen van de huidige toepassing zonder overmatig energieverbruik.
Bovendien zal de camera worden aangedreven door batterijen die opgeladen
kunnen worden via een draadloos oplaadstation waardoor de ESP32-CAM een
ideale keuze is voor deze specifieke toepassing.

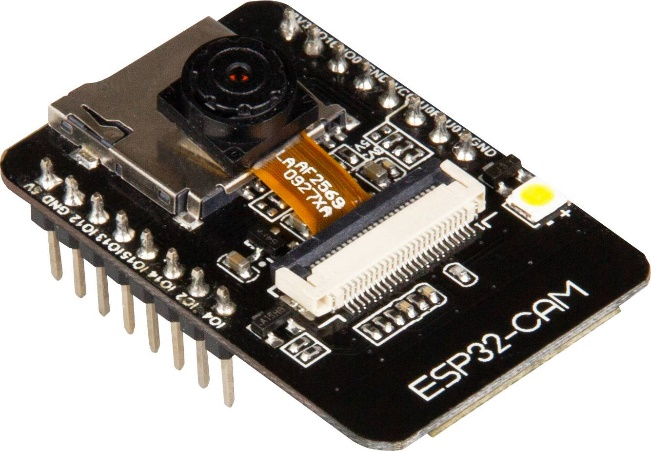
[picture p41: docs/assets/media/image45.jpeg]
Joy-it SBC-ESP32-Cam Cameramodule 1 stuk(s) kopen


Figuur : ESP32-CAM

De ontwikkeling van een pan en tilt systeem vereist precisie en
efficiëntie in de aandrijving van de camera. Om deze eisen te vervullen
is er gekozen om twee servo motoren te gebruiken, één voor de pan en één
voor de tilt. Deze motoren bieden een aantal voordelen voor de
specifieke toepassing.

Ten eerste, servo motoren zijn relatief klein en compact wat bijdraagt
aan een efficiënte ruimtebenutting in het systeem. Daarnaast bieden deze
motoren voldoende kracht om de ESP32-CAM te bewegen zonder overmatig
energieverbruik.

Verder zijn servo motoren eenvoudig te programmeren wat bijdraagt aan de
efficiëntie van het systeem. Bovendien hebben deze motoren niet veel
vermogen nodig, wat de efficiëntie van de aandrijving verhoogt. Ten
slotte, servo motoren hebben geen driver nodig waardoor de complexiteit
van het systeem vermindert en de betrouwbaarheid verhoogt.

Op basis van deze factoren is er gekozen voor servo motoren als
aandrijving voor de pan en tilt systeem. Deze motoren bieden een
optimale balans tussen prestatie, efficiëntie en eenvoud van
implementatie.

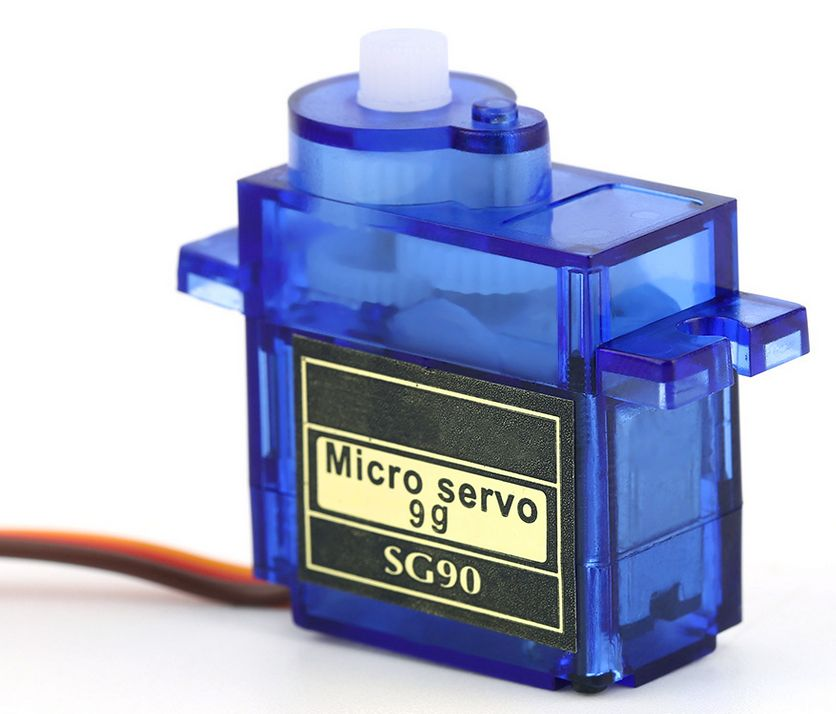
[picture p42: docs/assets/media/image46.jpeg]
SG90 9g Micro Servo – 4tronix


Figuur : Servo motor

## 3D-ontwerp voor pan en tilt systeem

De realisatie van pan en tilt systeem vereist een fysieke constructie om
de servo motoren te bevestigen en de ESP32-CAM te ondersteunen. Om deze
constructie te realiseren is er gebruik gemaakt van een 3D model. Dit
model is gevonden op het internet, specifiek op Thingiverse.com (zonder
verdere datum).

Het 3D model is ontworpen om de servo motoren te ondersteunen en de
ESP32-CAM op een stabiele manier te bevestigen. Hierdoor kan de camera
vrij bewegen binnen het pan en tilt systeem.

Door gebruik te maken van een 3D model wordt er een efficiënte en
betrouwbare constructie gerealiseerd voor het pan en tilt systeem. Deze
aanpak maakt het mogelijk om snel en gemakkelijk de fysieke constructie
te realiseren zonder dat er een groot ontwerp- en bouwproces nodig is.

Hieronder staan foto's van het gebruikte 3D model waarmee de constructie
van het systeem inzichtelijk gemaakt wordt.

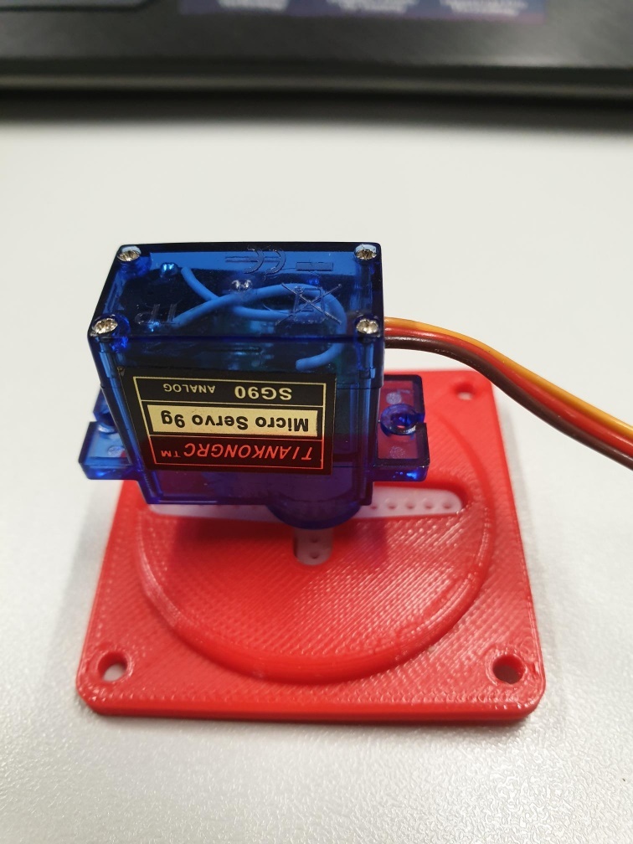
[picture p43: docs/assets/media/image47.jpeg]
Afbeelding met kist, accessoire Automatisch gegenereerde beschrijving


Figuur 42: Pan geprint 3D model met servo

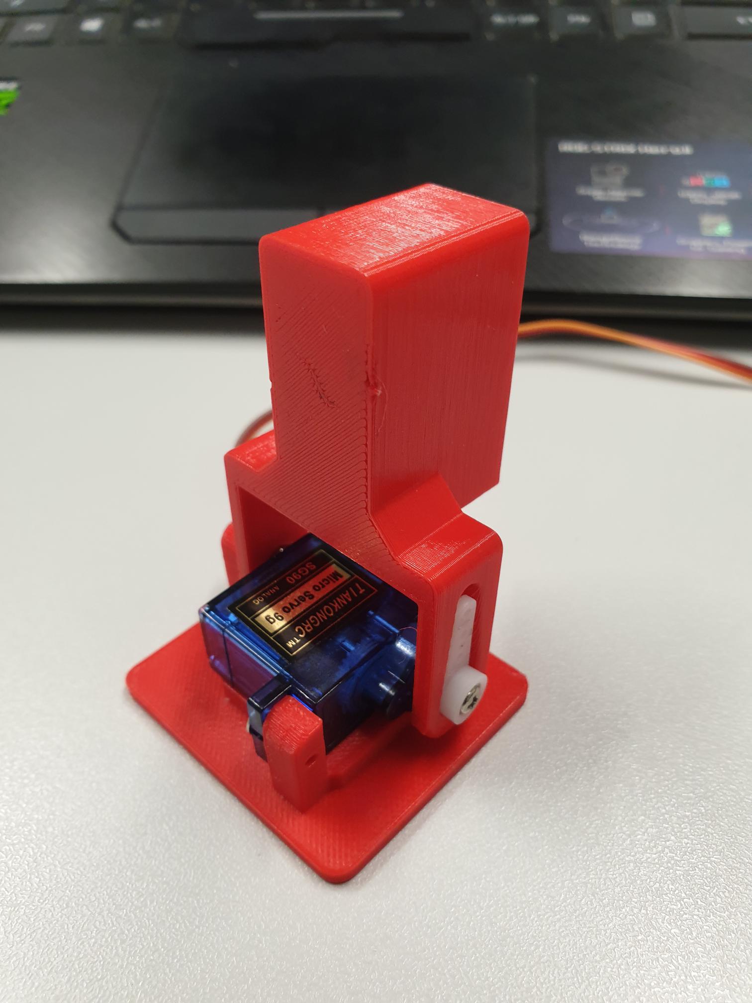
[picture p44: docs/assets/media/image48.png]
Afbeelding met rood Automatisch gegenereerde beschrijving


Figuur 43: Tilt geprint 3D model met servo

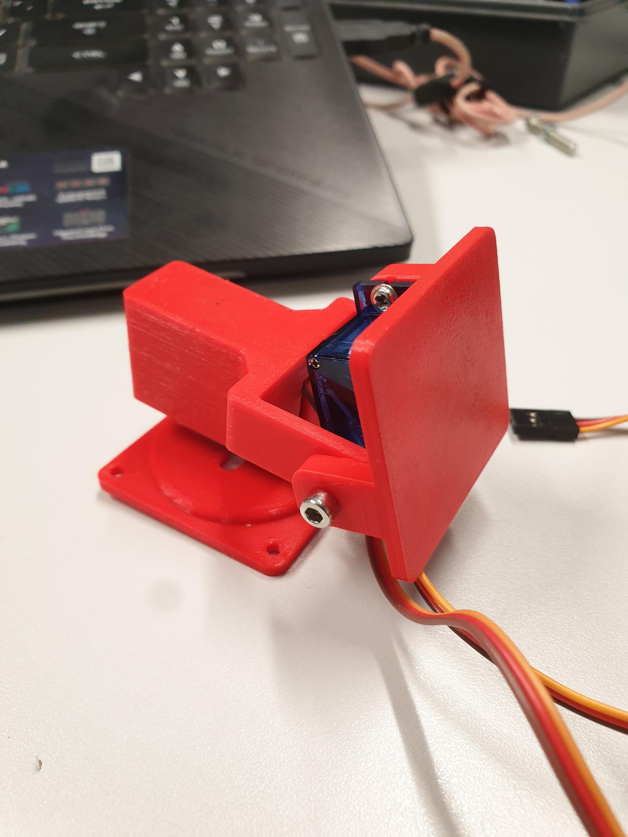
[picture p45: docs/assets/media/image49.png]
Afbeelding met kantoorartikelen Automatisch gegenereerde beschrijving


Figuur 44: Gemonteerd geprint 3D model

De foto’s geven aan dat de print een mooie fit is voor de servo motoren.
Dit is van groot belang aangezien een precieze pasvorm noodzakelijk is
voor een efficiënte werking van het pan en tilt systeem.

Dankzij de goede pasvorm van het 3D model met de servo motoren was het
niet nodig om verder aanpassingen of verbeteringen aan te brengen. Dit
bespaart tijd in het ontwikkelingsproces van het systeem.

<span id="_Toc125023813" class="anchor"></span>Draadloos oplaadstation

Aangezien de ESP32-CAM werkt met een batterij is er besloten om een
draadloze oplader te gebruiken voor het opladen van de batterij. Dit is
een efficiëntere oplossing in vergelijking met het gebruik van een kabel
aangezien een bewegend mechanisme zoals een camera slider onhandig is
met een kabel.

Een draadloze oplader maakt gebruik elektromagnetisme die energie
overbrengt via inductie. Hierdoor is er geen fysieke verbinding nodig
tussen de oplader en het apparaat, wat het gebruik van een kabel
overbodig maakt. Dit maakt het opladen van de ESP32-CAM veel
gemakkelijker.

Dit zijn de specificatie van de draadloos oplader:

- Ingangsspanning: 5-12 V

- Uitgangsspanning: 5 V

- Maximale uitgangsstroom: 1 A

- Diameter zenderspoel 40 mm, dikte 1,8 mm

- Diameter ontvangerspoel 40 mm, dikte 1,8 mm

- Ideale afstand tussen spoelen: 1-20 mm

Dit zijn de specificatie van de batterij:

- Chemie Li-Po

- Oplaadbaar: Ja

- Capaciteit: 1250mAh

- Minimale celspanning : 3,0 V

- Nominale celspanning : 3.7 V

- Maximale celspanning : 4.2 V

- Maximale continue ontlaadstroom : 1,25 A

- Maximale laadstroom: 1250mAh

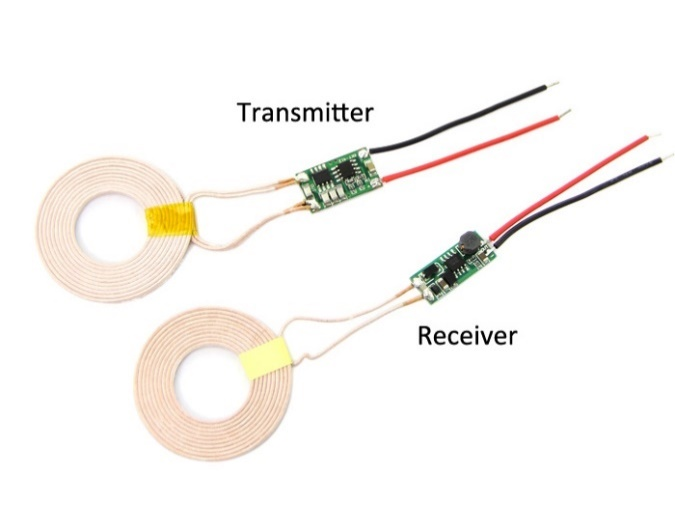
[picture p46: docs/assets/media/image50.jpeg]


Het rendement van de draadloze oplader is 20.4%, wat niet echt hoog is.
Dit betekent dat slechts 20.4% van de ingevoerde energie daadwerkelijk
wordt gebruikt voor het opladen van de ESP32-CAM. De overige 79.6% wordt
verloren als warmte of andere vormen van energie.

Het is moeilijk om het theoretische rendement van de specifieke
draadloze oplader te vinden omdat er geen datasheet beschikbaar is van
de fabrikant en de technologie die er gebruikt wordt. Er zijn echter
bepaalde standaard efficiëntie waardes die gebruikt worden voor
draadloze opladers. Helaas de 20.4% rendement is lager dan de standaard
waardes.

| Eenheid | A | V | vermogen(W) | Rendement (%) |
|---|---|-----|---|---|
| Draadloos zender | 0,06 | 12  | 0,72 | X |
| Draadloos Ontvanger | 0,03 | 4,9 | 0,147 | X |
| Rendement | | | | 20,47 |
| Theoretische rendement | | | | Kon niet gevonden worden wegens gebrek aan de datasheet. |
| Stand | 0.32 | 12  | 3.84 | X |
| Slider | 0.47 | 5 | 2.35 | X |
| Totaal | | | 6.19 | X |

De batterijduur van de ESP32-CAM is 2u06 wat voldoende is voor onze
toepassing. De oplaadtijd is echter 48 uur, wat relatief lang is. Er is
een mogelijkheid om de oplaadtijd te verkorten door meer stroom (ampère)
te geven aan de oplader. Echter, in onze toepassing is dit niet
noodzakelijk aangezien de camera slider de meeste tijd zal worden
opgeladen.

Het is belangrijk om op te merken dat het verhogen van de stroomtoevoer
tijdens het opladen kan leiden tot een snellere oplaadtijd maar ook kan
de batterij sneller slijten en de levensduur verkorten. Bovendien, als
de ESP32-CAM is aangesloten op een draadloze oplader terwijl deze in
gebruik is, is het niet een probleem dat de oplaadtijd lang is.

Het stand vermogen is 3.84 Watt, terwijl het vermogen van de slider 2.35
Watt is. Samen vormen deze twee componenten een totaal systeemvermogen
van 6.19 Watt. Dit betekent dat het systeem 6.19 Watt aan energie
verbruikt wanneer het in gebruik is.

Het is belangrijk om op te merken dat dit vermogen afhankelijk is van de
specifieke componenten die worden gebruikt en de specifieke configuratie
van het systeem. Bijvoorbeeld, als een andere camera of servomotor wordt
gebruikt, kan het systeemvermogen variëren.

Een lager systeemvermogen kan worden bereikt door het gebruik van
efficiëntere componenten, zoals een lagere vermogensservomotor of een
camera met een lager vermogen. Ook, het gebruik van een efficiëntere
oplader kan ook helpen bij het verlagen van het systeemvermogen.

## Draadloos oplader houder

Om de draadloos oplader te monteren op de bovenplaat wordt er een houder
3d-geprint. Hierdoor is het eenvoudig om de receiver te installeren en
te verwijderen zonder dat er gereedschap nodig is. Bovendien zorgt het
3D-model ervoor dat de oplader stevig aan de plaat vastzit zodat deze
niet los kan komen tijdens het gebruik. Wanneer de slider in zijn rest
positie aankomt zal de batterij veilig opgeladen worden.

## Oplader houder v1

In de eerste versie wordt er enkel de houder voor coil ontwerpt en dan
geprint om te zien dat de gekozen afmetingen goed zijn.

<https://a360.co/3IZmKxc>

<iframe
src="https://student111942.autodesk360.com/shares/public/SH35dfcQT936092f0e43de79ef6e22f704e1?mode=embed"
width="640" height="480" allowfullscreen="true"
webkitallowfullscreen="true" mozallowfullscreen="true"
frameborder="0"\>\</iframe>

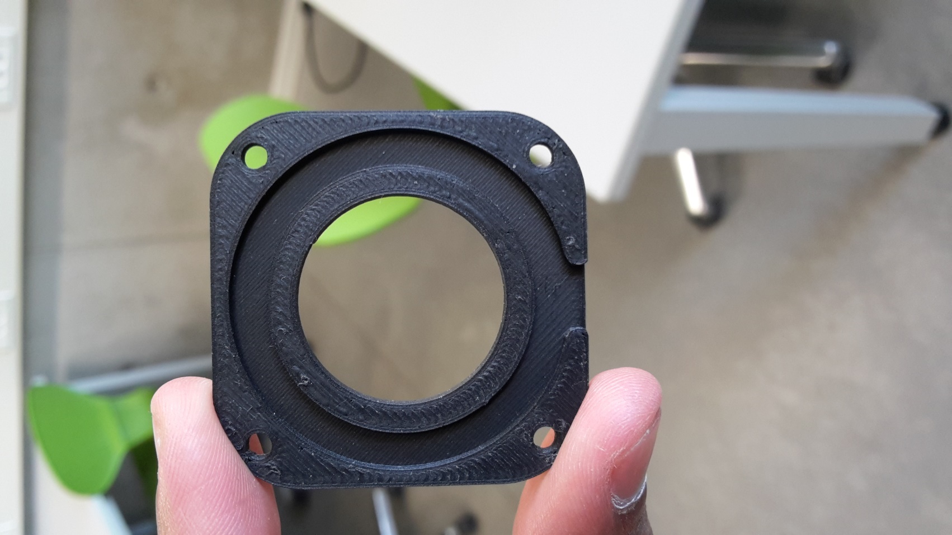
[picture p47: docs/assets/media/image52.jpeg]
Afbeelding met persoon, hand Automatisch gegenereerde beschrijving


Figuur : oplader houder v1

## Oplader houder v2

Omdat de afmetingen van de vorige versie goed was, wordt er nu verder
gewerkt aan de print zodat deze verschoven kan worden op de plaat.

<https://a360.co/3IVJGxu>

<iframe
src="https://student111942.autodesk360.com/shares/public/SH35dfcQT936092f0e43bb33c77e36effa6e?mode=embed"
width="640" height="480" allowfullscreen="true"
webkitallowfullscreen="true" mozallowfullscreen="true"
frameborder="0"\>\</iframe>

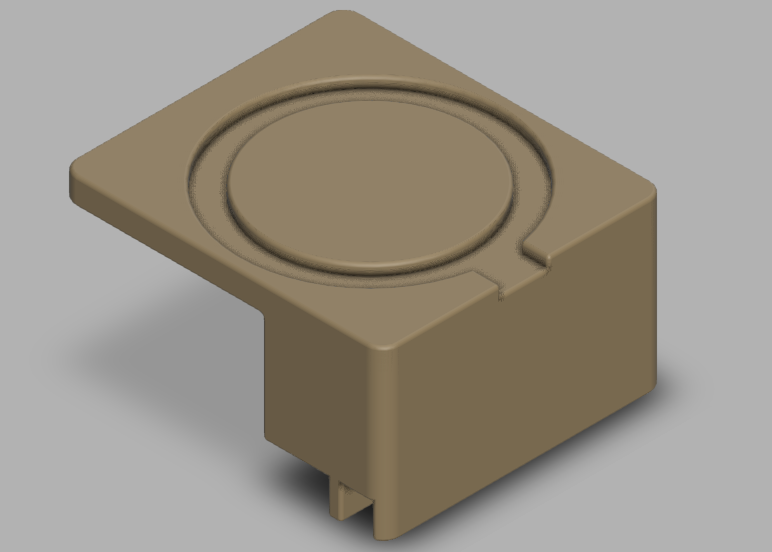
[picture p48: docs/assets/media/image53.png]
>  style="width:75%;height:75%" />

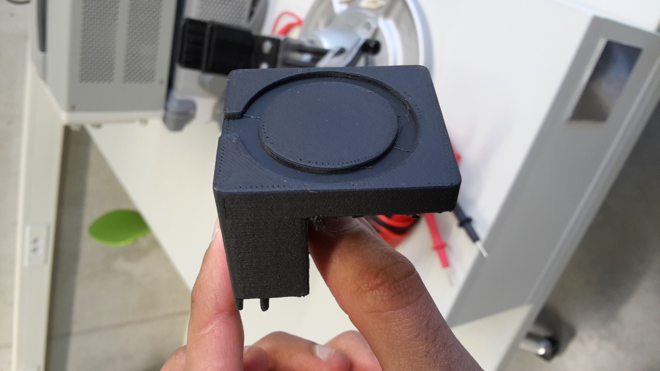
[picture p49: docs/assets/media/image54.jpeg]


Figuur : Oplader houder v2

# Web interface

Het controleren van de ESP32-CAM, stepper motor en de servo's is een
belangrijk aspect van het pan en tilt systeem. Om deze componenten te
kunnen bedienen is er een interface ontwikkeld, namelijk een Node-Red
interface. Dit is een visuele tool die het mogelijk maakt om componenten
te programmeren en te controleren via MQTT requests.

De Node-Red interface maakt het mogelijk om MQTT requests te sturen naar
de ESP32-CAM voor het nemen van foto's en het aansturen van de servo's
om te bewegen. Hierdoor kan de gebruiker de camera en servo's bedienen
vanaf een afstand. Ook de stepper motor kan worden aangestuurd met
behulp van een ESP32 Dev Board. Hiermee kan de gebruiker de precieze
positie van de stepper motor aansturen en zo de camera in een gewenste
positie instellen.

## Controlemechanisme voor Pan en Tilt systeem

De interface die is ontwikkeld voor het pan en tilt systeem maakt
gebruik van twee sliders. Eén slider is voor de pan-functie en de andere
is voor de tilt-functie. Deze sliders maken het mogelijk om de positie
van de ESP32-CAM te bepalen en de juiste instellingen te kiezen voor het
nemen van foto's.

Wanneer de gebruiker een van de sliders verschuift, zal de Node-Red
interface via MQTT-communicatie met de ESP32-CAM communiceren en de
servo's laten bewegen. Hierdoor wordt de juiste pan en tilt positie
gekozen voor het nemen van foto's. Dit maakt het gemakkelijk voor de
gebruiker om de juiste instellingen te kiezen en zo de beste foto's te
maken. Hier onder is een foto van de pan en tilt systeem interface.

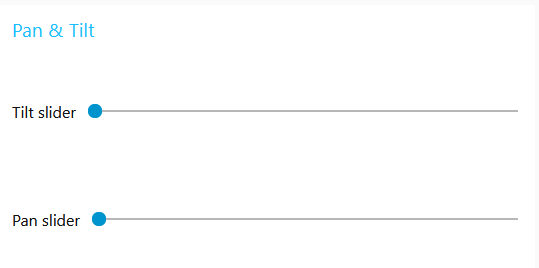
[picture p50: docs/assets/media/image55.png]


Figuur 50: Interface Pan en Tilt

## Controlemechanisme voor ESP32-CAM systeem

De interface die is ontwikkeld voor het pan en tilt systeem biedt ook de
mogelijkheid om de foto's te nemen en te bekijken. Dit maakt het
gemakkelijk voor de gebruiker om te controleren of het pan en tilt
systeem zich in de juiste positie bevindt. Indien dit niet het geval is,
kan de gebruiker de instellingen aanpassen via de sliders.

Daarnaast biedt de interface ook de mogelijkheid om de getrokken foto te
bekijken voordat deze worden opgeslagen op een server. Hierdoor kan de
gebruiker de foto controleren op de kwaliteit en eventuele aanpassingen
doen.

Hieronder wordt een afbeelding getoond van de interface waarmee foto's
genomen en bekeken kunnen worden. De interface bevat een groot wit vlak
waar de genomen foto getoond wordt. Hieronder bevindt zich een knop
genaamd "Maak Foto" waarmee de gebruiker een foto handmatig kan nemen.
Daaronder is een knop met de naam "Camera Flash Test" die gebruikt kan
gebruiken om te controleren of de ESP32-CAM aan staat en of deze
verbonden is met de Node-Red.

Deze knop zal de flits van de camera activeren, wat een visueel signaal
geeft dat de camera functioneert en verbonden is met Node-Red.

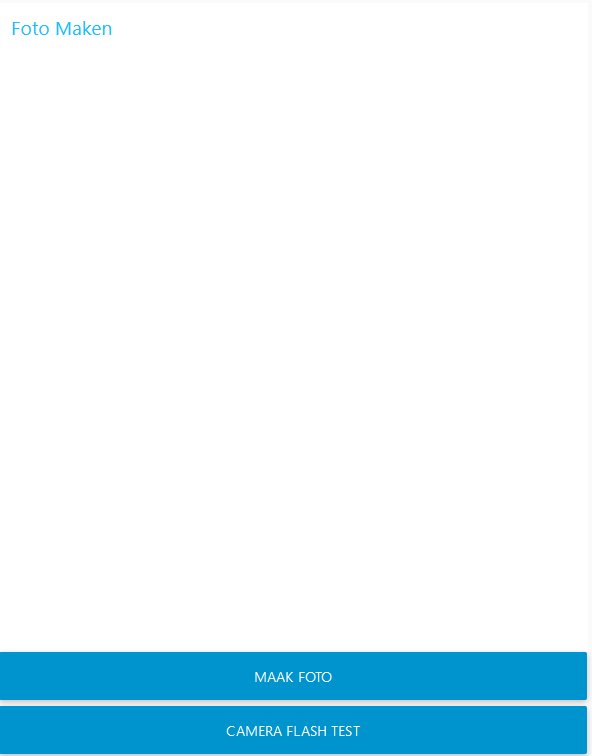
[picture p51: docs/assets/media/image56.png]
A picture containing text Description automatically generated


Figuur 51: Interface van ESP32-CAM.

De foto’s die worden getrokken worden voorlopig opgeslagen op een lokale
server. Wanneer er een foto wordt getrokken gaat de Node-Red deze foto
in een folder opslagen. De naam van de folder is de datum en de naam van
de foto is de datum plus de tijd in seconden wanneer de foto gemaakt
werd.

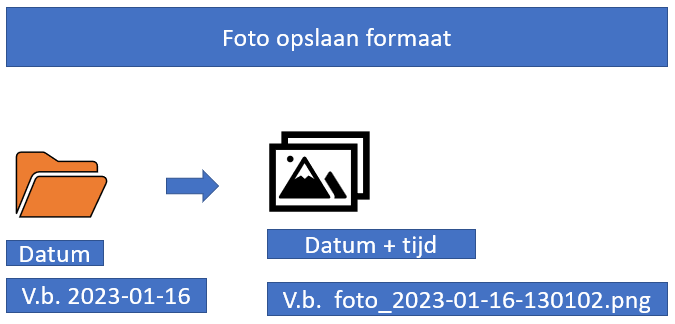
[picture p52: docs/assets/media/image57.png]


Figuur 52: Foto opslag folder van de interface

Dit maakt het eenvoudig om foto's te organiseren en terug te vinden.
Bovendien, door de foto's te organiseren op basis van datum, kunnen de
foto's eenvoudig worden gekoppeld aan een specifieke sessie of
gebeurtenis waarvoor ze gemaakt zijn.

## Controlemechanisme voor Stepper motor systeem

Er is ook een interface ontwikkeld om de stepper motor te controleren.
De interface bevat een start- en stopknop waarmee de gebruiker de motor
kan starten of stoppen. Daarnaast bevat de interface een slider om de
snelheid van de stepper motor te kiezen. Er is ook een knop aanwezig
genaamd "Set 0 Punt" om het nulpunt in te stellen en een knop genaamd
"Ga naar 0 punt" om naar het nulpunt te gaan. Hiermee kan de gebruiker
de motor testen en de juiste instellingen kiezen.

Daarnaast is er een slider met de naam “welke locatie” aanwezig om de
locatie van de plant te vinden. De gebruiker kan de verschillende
locaties invoeren in de vorm van coördinaten, bijvoorbeeld "15, 25,
45,...". De gebruiker kan de locatie vervolgens versturen naar het ESP32
Dev Board via de knop "STUUR DE LOCATIE".

Ten slotte is er een knop aanwezig genaamd "TEST AUTOMATISCHE MODUS"
waarmee de gebruiker de automatische modus voor het nemen van foto's kan
testen met de hulp van de coördinaten. Hiermee kan de gebruiker
controleren of de automatische modus werkt en of de ESP32-CAM, servo's
en stepper motor op de juiste manier werken.

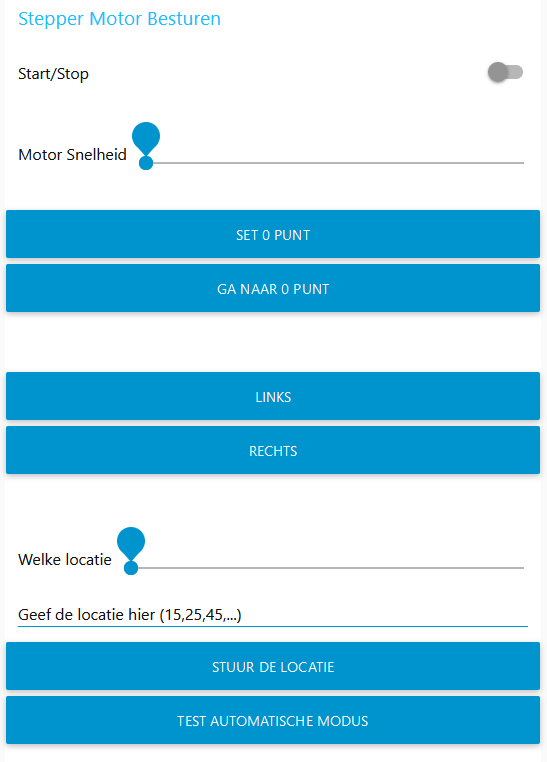
[picture p53: docs/assets/media/image58.png]
Graphical user interface, application, website Description automatically generated


Figuur 53: Interface stepper motor

## Automatische Modus

De Node-RED interface zorgt ook voor het automatisch nemen van foto's
door de camera slider. Bijvoorbeeld, het systeem kan ingesteld worden om
elke 8, 12 of 18 uur van de dag een foto te nemen. Dit wordt bereikt
door middel van een automatische modus die hetzelfde werkt als de "TEST
AUTOMATISCHE MODUS" knop. Hierdoor wordt een volledig automatisch
systeem gecreëerd waarbij de camera slider automatisch foto's neemt en
opslaat.

Deze automatische modus kan worden ingesteld door middel van
tijdschema's in Node-RED. Hiermee is het mogelijk om specifieke
tijdstippen in te stellen waarop de camera slider foto's moet nemen. De
foto's worden vervolgens automatisch opgeslagen in de specifieke folder
zoals eerder beschreven. Dit maakt het systeem zeer efficiënt en
gemakkelijk te gebruiken zonder dat er constant toezicht nodig is.

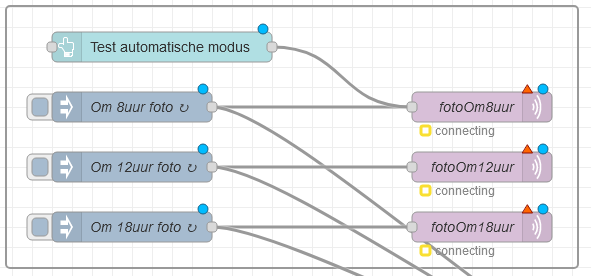
[picture p54: docs/assets/media/image59.png]
A picture containing diagram Description automatically generated


Figuur : Flowchart Node-RED

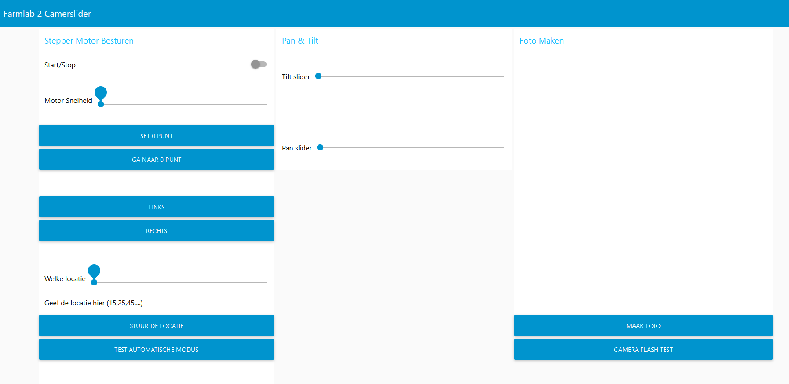
[picture p55: docs/assets/media/image60.png]
In onderstaande afbeelding
is de volledige interface van de webpagina te zien.

Figuur 55: Volledige interface van de webpagina

<span id="_Toc125023822" class="anchor"></span>De node-red stuurt een
bericht naar de MQTT server door middel van het publiceren van het topic
Farmlab/slider/command'. Hierop reageert het ESP32-Cam en Dev board door
het abonneren op dit topic en ontvangt het bericht van de MQTT server,
bijvoorbeeld 'licht aan' of 'licht uit’.

Bijvoorbeeld, als node-red een bericht publiceert met topic '
Farmlab/slider/command'' en payload 'licht aan', zal het ESP32-Cam en
Dev board ontvangen dit bericht via het abonneren op dit topic en zal
daarop reageren door een foto te nemen.

Als node-red een bericht publiceert met topic 'camera/command' en
payload 'licht uit’, zal het ESP32-Cam en Dev board ontvangen dit
bericht via het abonneren op dit topic en zal daarop reageren door de
opname te stoppen.

Om het licht aan en uit te zetten, zal de ESP32 zijn status veranderen
naar een specifieke enum-toestand wanneer een specifiek topic wordt
ontvangen. Bijvoorbeeld, wanneer het topic 'licht/aan' wordt ontvangen,
zal de ESP32 zijn status veranderen naar de enum-toestand 'lichtAan'.

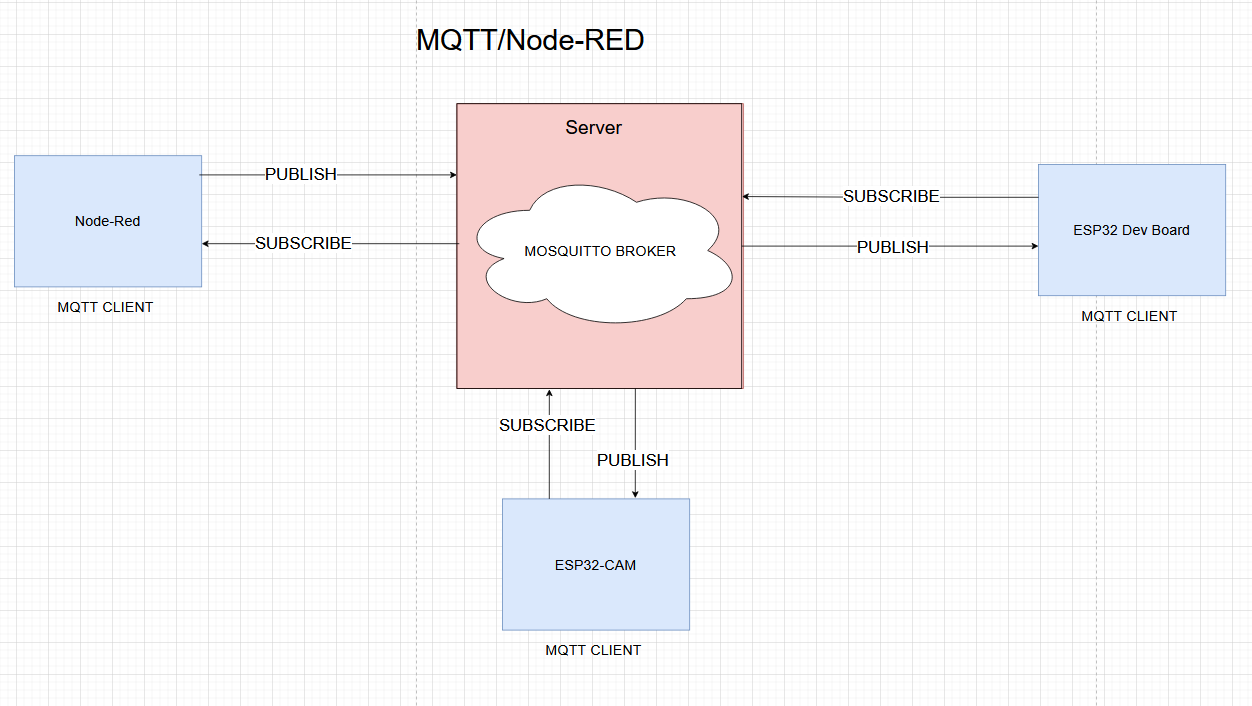
[picture p56: docs/assets/media/image61.png]


# Elektrisch schema’s en PCB designs

## Schema ESP32-CAM

Om de ESP32-CAM gemakkelijk te monteren is er een shield ontwikkeld. Dit
shield maakt het eenvoudiger om de ESP32-CAM aan te sluiten en te
communiceren met andere componenten. In het bijbehorende schema is een
pinout voor de servo's aanwezig evenals programmapinnen voor
communicatie met de ESP32.

De shield is ontworpen om de ESP32-CAM te ondersteunen bij de verbinding
met de servo's en andere componenten zodat de gebruiker eenvoudig de
ESP32-CAM kan installeren en configureren. Bovendien biedt het shield
ook programmapinnen voor communicatie met de ESP32 aan waardoor de
gebruiker de ESP32-CAM eenvoudig kan programmeren en controleren.

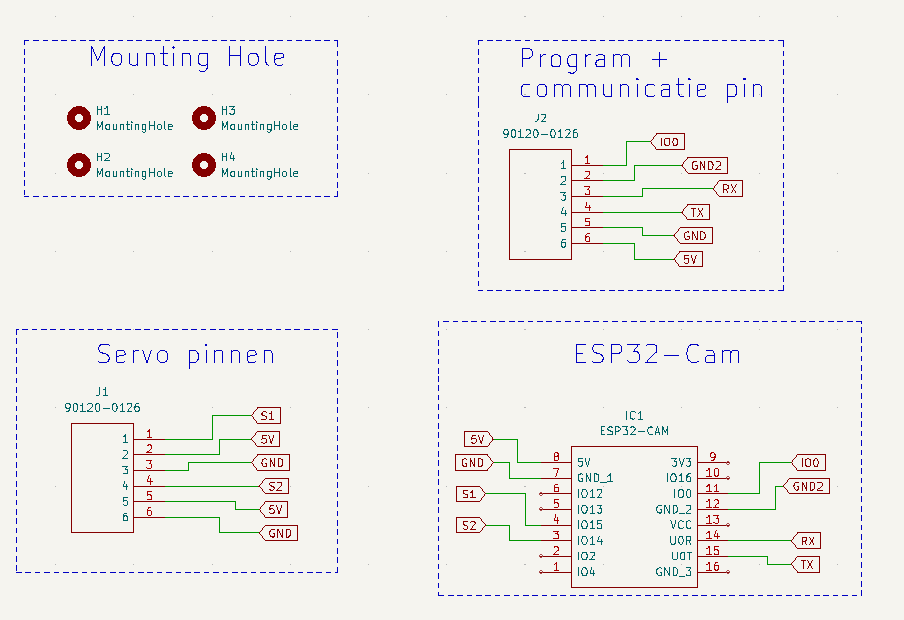
[picture p57: docs/assets/media/image62.png]


Figuur 56: Elektrische schema van ESP32-CAM shield

## PCB design ESP32-CAM

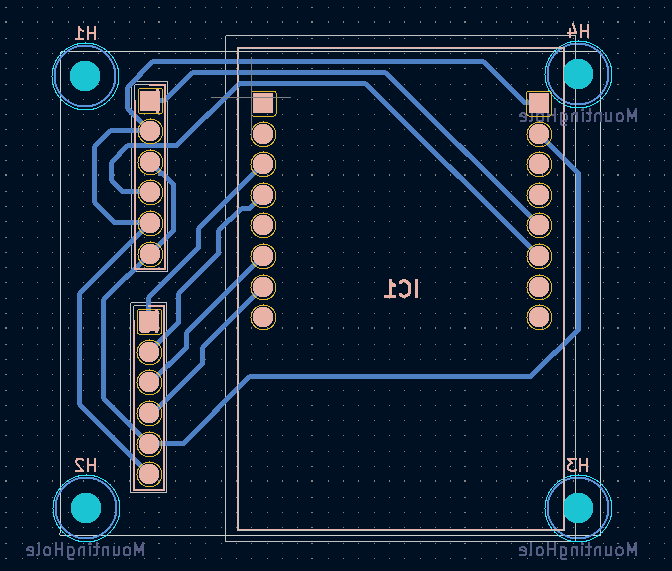
[picture p58: docs/assets/media/image63.png]
Afbeelding met tekst, elektronica Automatisch gegenereerde beschrijving


Figuur 57: PCB ESP32-CAM shield Schema

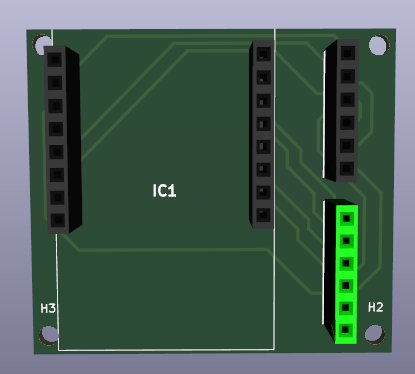
[picture p59: docs/assets/media/image64.png]


Figuur 58: PCB 3D model van ESP32-CAM shield

## Schema stepper motor

De schakelingen voor de stepper motor werden vooral gebouwd met een
breadboard. Om dit compacter te maken wordt er een PCB ontworpen voor de
stepper motor. Het originele plan was om smd componenten te gebruiken
maar aangezien we weinig tijd hadden en maar één iteratie van de PCB
konden doen werd er beslist om gewoon de through hole componenten te
gebruiken en female headers te gebruiken voor ESP32, DRV8825 stepper
motor driver en eindeloopschakelaars.

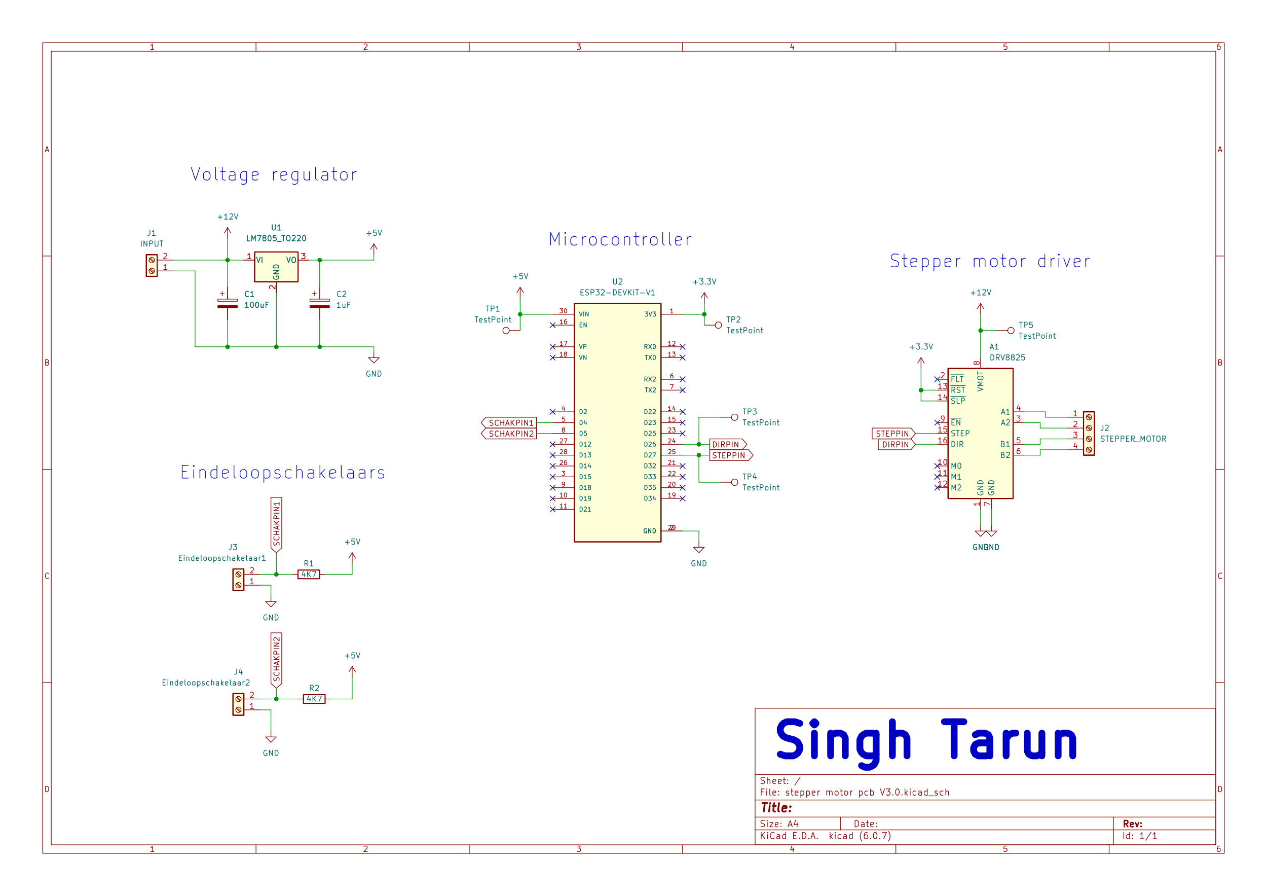
[picture p60: docs/assets/media/image65.png]


## PCB design stepper motor

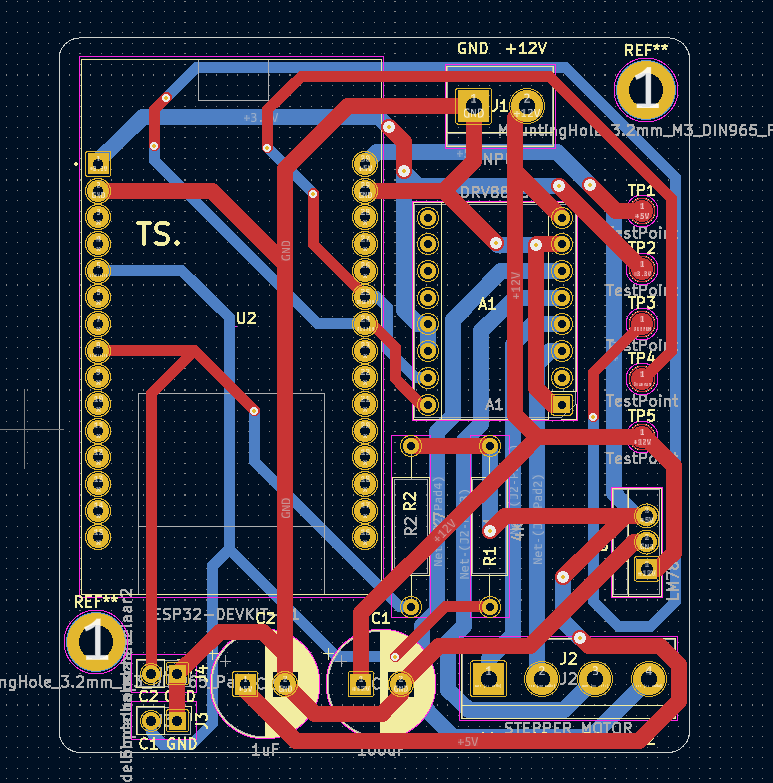
[picture p61: docs/assets/media/image67.png]


Figuur : PCB design

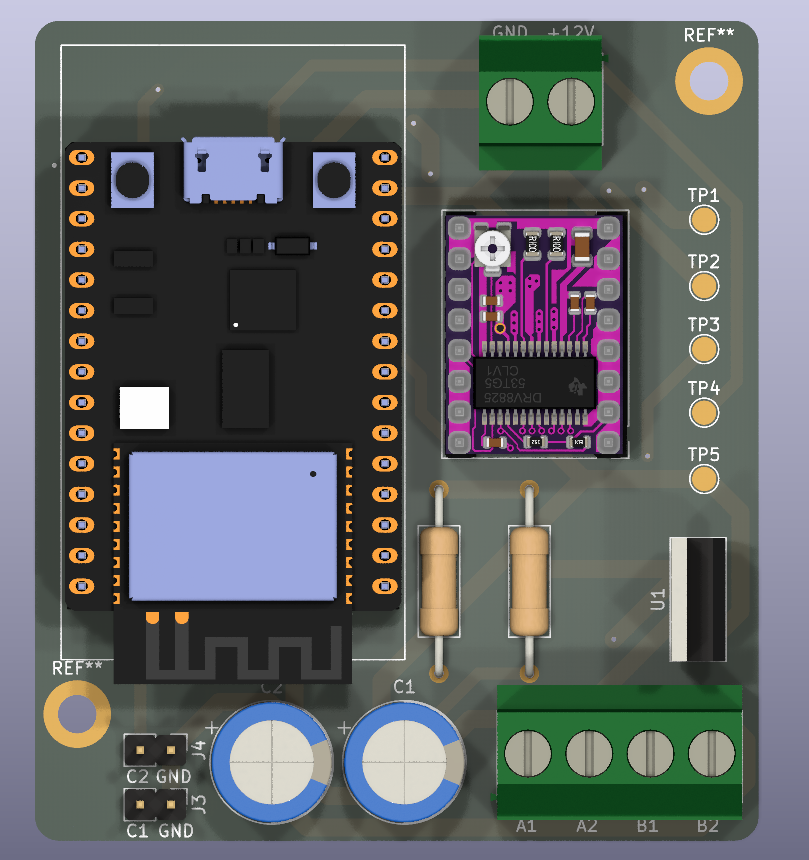
[picture p62: docs/assets/media/image68.png]


Figuur 61: 3D-view PCB design 1

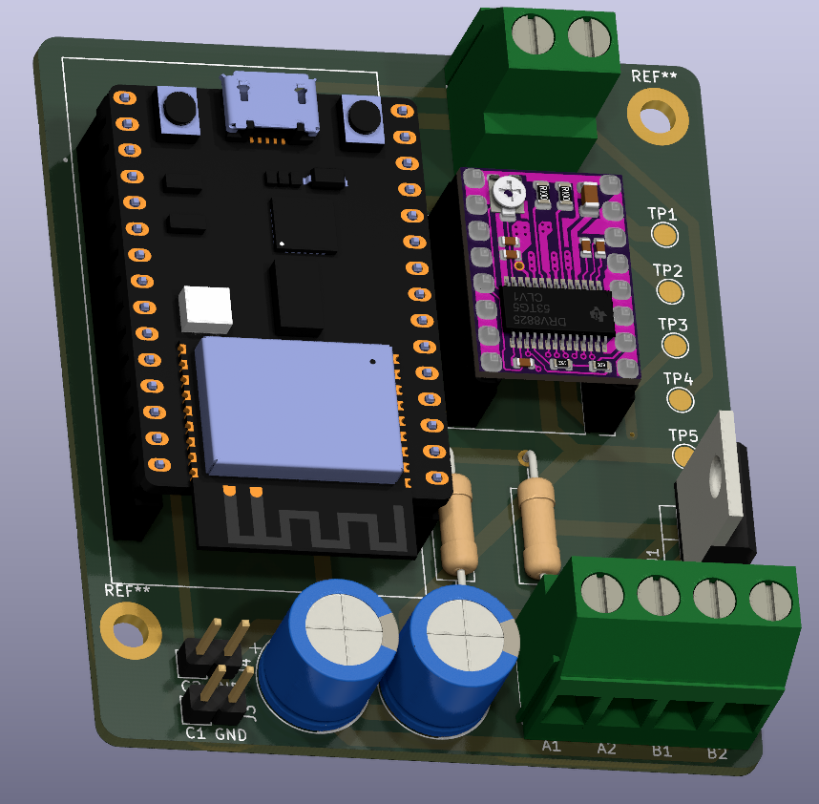
[picture p63: docs/assets/media/image69.png]


Figuur 62: 3D-view PCB design 2

# Gefreesde PCB’s

Voordat de PCB’s besteld werden,werd er een poging gedaan om de PCB’s te
frezen met de freesmachine.

## ESP32-CAM gefreesde PCB v1

Bij versie 1 was de freesmachine niet zo goed gekalibreerd waardoor de
paden verkeerd gefreesd werden omdat de boor soms niet hoog genoeg
opgetild werd.

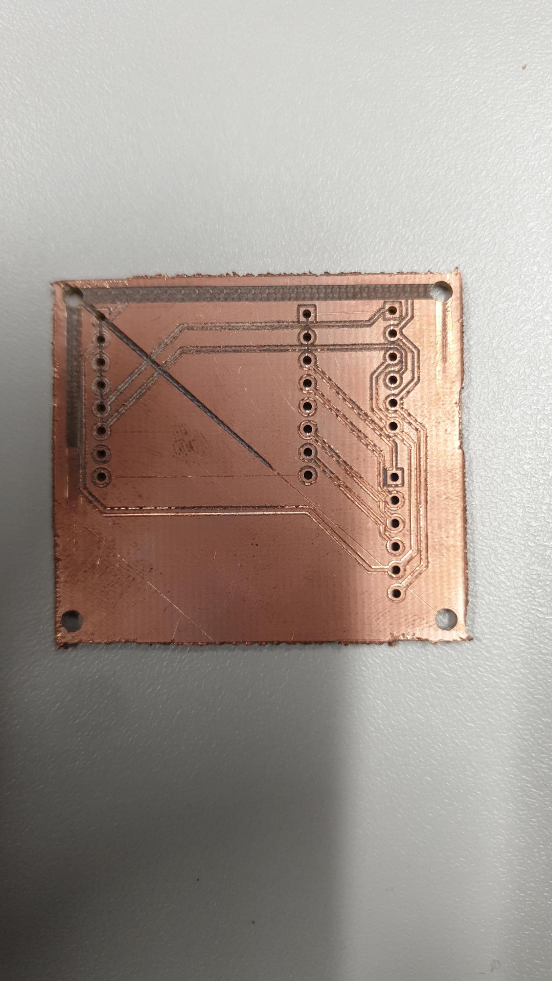
[picture p64: docs/assets/media/image70.png]


Figuur 63: ESP32-CAM Shield V1

## ESP32-CAM gefreesde PCB v2

Bij versie 2 waren de paden niet zo goed gefreesd waardoor er
kortsluiting was.

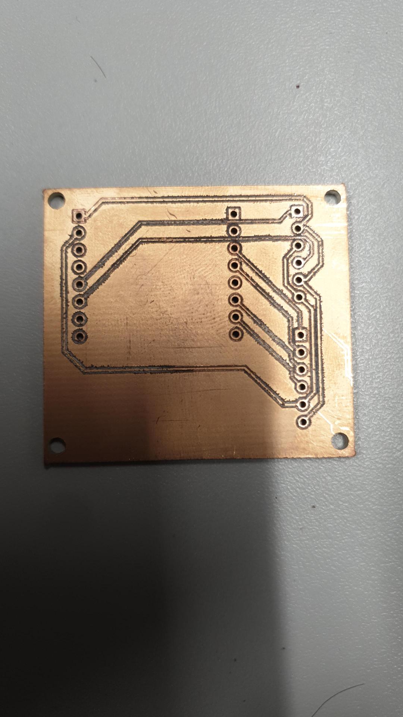
[picture p65: docs/assets/media/image71.png]


Figuur 64: ESP32-CAM Shield V2

## ESP32-CAM gefreesde PCB v3

Bij versie 3 was de top en bottom omgewisseld waardoor de camera pinnen
omgekeerd waren.

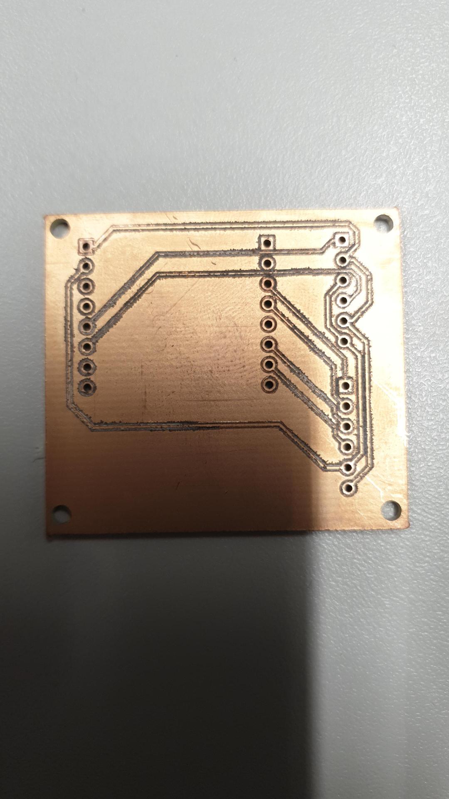
[picture p66: docs/assets/media/image72.png]
Afbeelding met tekst, kist Automatisch gegenereerde beschrijving


Figuur 65: ESP32-CAM Shield V3

## Stepper motor gefreesde PCB v1

Tijdens het frezen werden er aantal fouten gemaakt. De eerste fout was
dat er een dubbelzijdige plaat gekozen werd. Er moest enkel aan de
onderkant gefreesd worden maar omdat bovenaan ook koper was werden
sommige routes kort gesloten. Dit probleem werd opgelost door met een
slijpschijf de volledige koper weg te halen.

De volgende fout was dat er een verkeerde route aangesloten was. De
verkeerde route werd dan weggeschraapt en een nieuwe route gemaakt met
een draad.

Na deze problemen op te lossen werkte de PCB maar niet goed genoeg om
deze in het project te kunnen gebruiken. Hierdoor werd het beslist om de
PCB gewoon te bestellen op JLCPCB. De video is te vinden in de tests
deel van de documentatie.

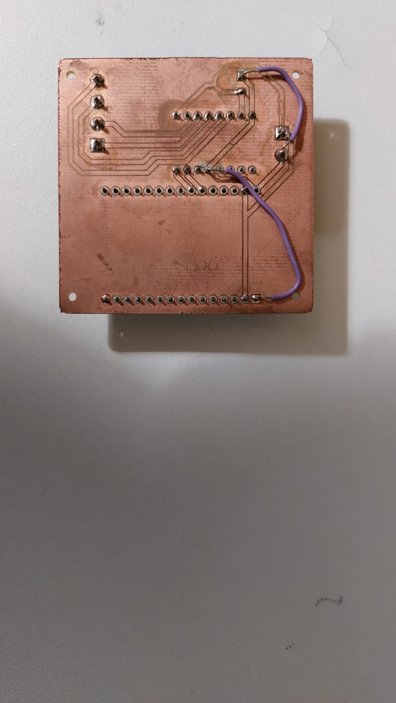
[picture p67: docs/assets/media/image73.jpeg]


Figuur : Gefreesde stepper motor PCB (voorkant)

# Schematische voorstelling

Onderstaand schema geeft een voorstelling weer van het hele systeem.

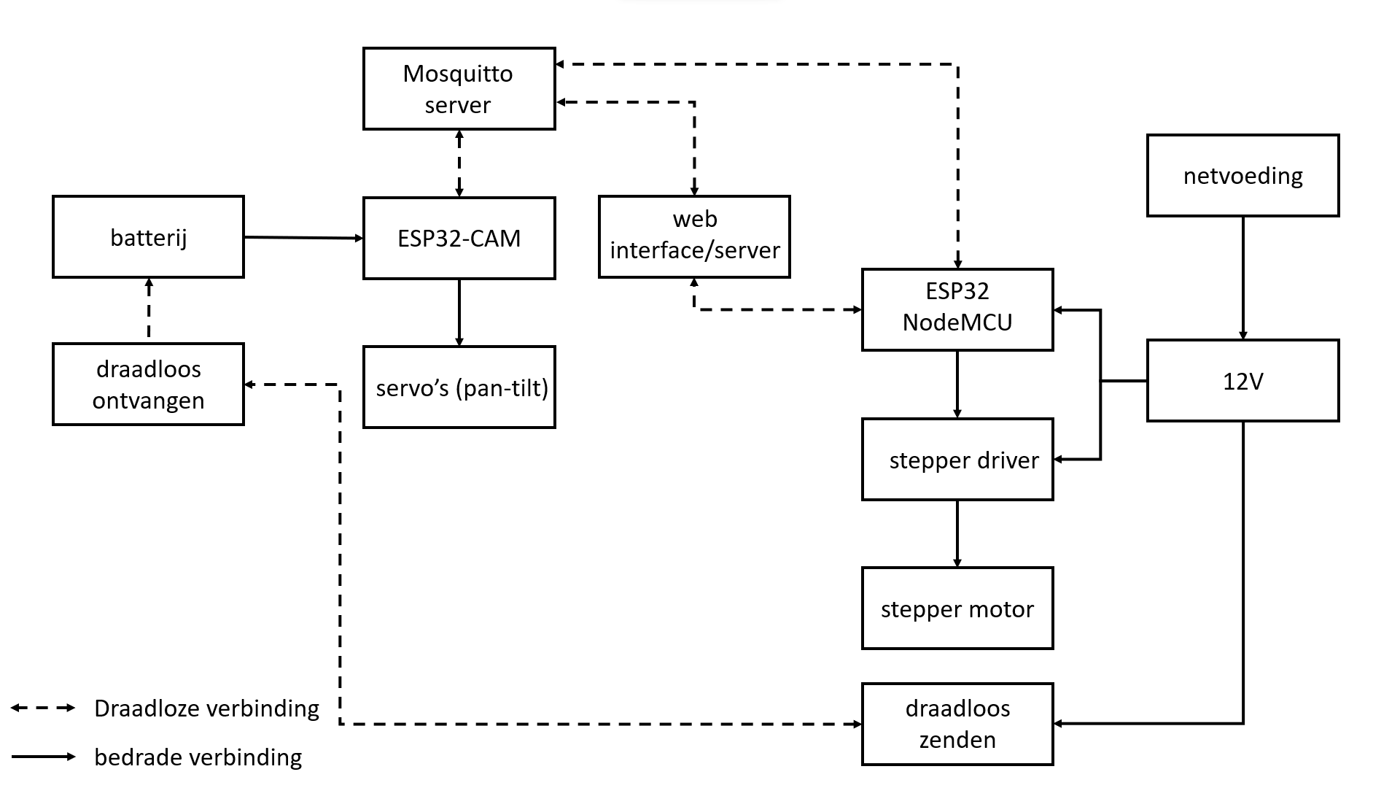
[picture p68: docs/assets/media/image75.png]


Figuur : Blokschema camera slider

Onderstaand blokdiagram toont de communicatie tussen de broker en de
clients.



Figuur : Blokschema MQTT communicatie

# Docker

Installeren van Docker via de site:
<https://docs.docker.com/desktop/install/windows-install/>. (“Install
Docker Desktop on Windows”, 2022) Zie dat er een linux kernel aanwezig
is op de Windows machine om de WSL 2 versie als default te zetten.
(“Manual installation steps for older versions of WSL”, 2022) Stappen 4
en 5 moet worden uitgevoerd. Anders krijgt men volgende error bij het
opstarten.

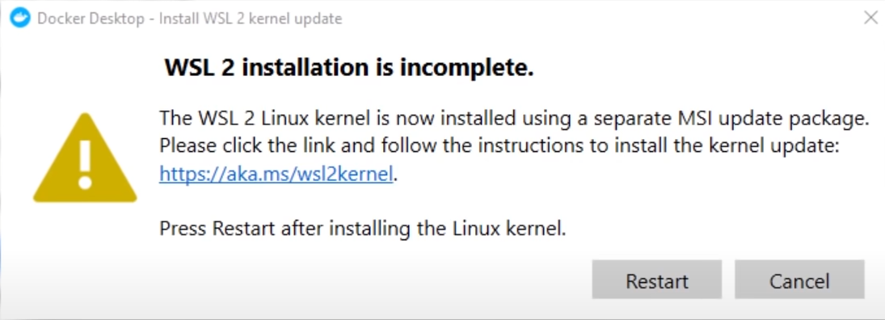
[picture p69: docs/assets/media/image77.png]


Figuur 70: Error bij opstarten Docker zonder gepaste Linux kernel.

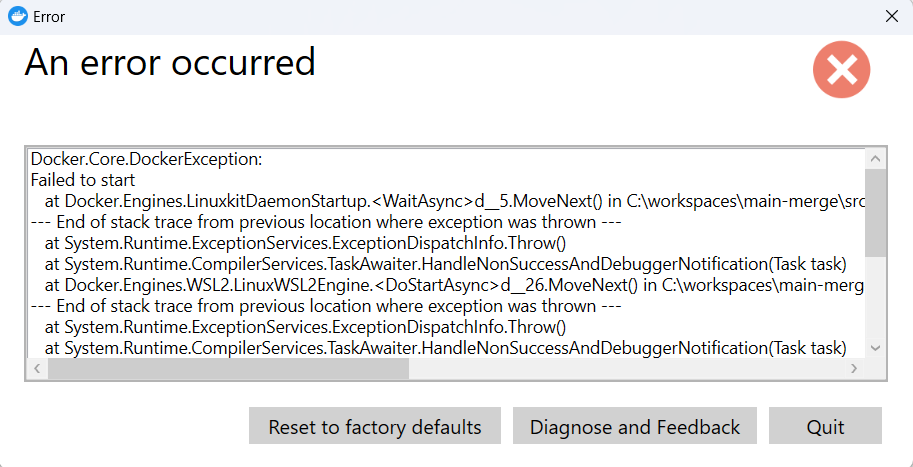
[picture p70: docs/assets/media/image78.png]
Graphical user interface, text, application Description automatically generated


Figuur 71: Error bij opstarten Docker zonder activeren juiste Linux
kernel versie.

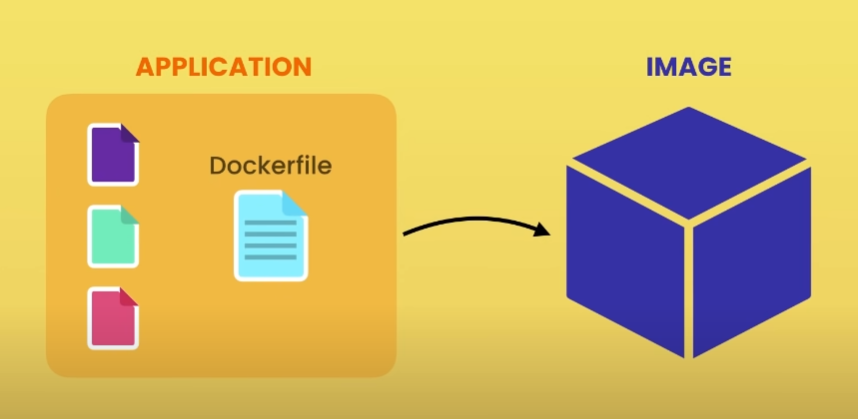
[picture p71: docs/assets/media/image79.png]


Figuur 72: Diagram over hoe een image in docker wordt gemaakt.
(Programming with Mosh, 2021)

Docker is een programma waarbij er gemakkelijk geschreven programma’s op
verschillende computers kunnen worden gedraaid zonder dat al de packages
en dergelijke afzonderlijk moeten worden geïnstalleerd. Docker maakt van
de code, de packages en alles er rond een image wat dan wordt opgeslagen
in de docker hub.

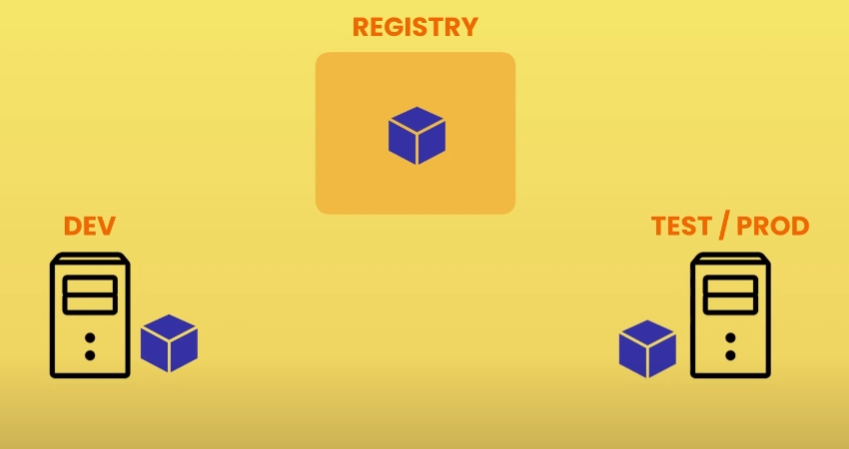
[picture p72: docs/assets/media/image80.png]
A picture containing text, first-aid kit, vector graphics, screenshot Description automatically generated


Figuur 73: Diagram van hoe een image op verschillende computers kan
draaien. (Programming with Mosh, 2021)

Wil men dit dan op een andere computer draaien dan hoeft men enkel de
image te downloaden met de bijhorende packages en dergelijke en kan men
het programma zonder problemen runnen.

Ondanks dat Docker een zeer handige tool is om het geschreven programma
op te zetten en te kunnen gebruiken op verschillende computers wordt er
in dit project geen gebruik gemaakt van docker omdat deze niet werkt op
de voorhanden gekregen Bletchley server.

# Tests 

## Test 1: Motor driver op klein profiel

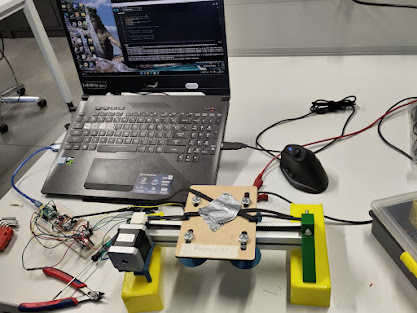
[picture p73: docs/assets/media/image81.jpeg]
A picture containing text, indoor, cluttered Description automatically generated


Figuur 74: Setup slider met profiel 30cm:

<https://photos.google.com/album/AF1QipNc2HlqLKLi-fJn4t2gWh2M19e81hADS3dtTNHV/photo/AF1QipNZe_BSFLD73aJ8lfxFqyDM48WOiNvx0hnSvb2D>

De eerste test is een test om te kijken of het hard programmeren van de
stepper motor werkt op een profiel van 30cm. Alles is nog verbonden met
computer en de labovoeding.

De test is succesvol uitgevoerd en de code werkt naar behoren.  
Test 1.1: Snelheid slider

<https://photos.app.goo.gl/mnk9MxC7bvREfgSE7>

<https://photos.app.goo.gl/yRQxuTXK1qLKk3848>

<https://photos.app.goo.gl/yRQxuTXK1qLKk3848>

In deze test is er gekeken op welke manier de slider het beste beweegt
over het profiel. Hierdoor komt men te weten hoe men de slider best
plaatst op het profiel met zo weinig mogelijk weerstand.

Na enkele tests op tijd kan er geconcludeerd worden dat het plaatsten
van de slider verticaal of langs onder op het profiel beter is dan langs
boven. Dit valt natuurlijk met een korreltje zout te nemen aangezien het
hier over een test gaat met de zwaartekracht en dat de wieltjes van de
slider op dezelfde hoogte moeten geplaatst worden om zo weinig mogelijk
schommelen van de slider te krijgen.

De snelheid waarmee de slider over het profiel beweegt is ook veel te
snel voor hoe het in het uiteindelijke model gaat zijn maar dit geeft
wel een goede representatie van of de slider in een foute richting
beweegt of ergens te veel wrijving veroorzaakt. Dit zou het stroom
verbruik kunnen verhogen.

## Test 2: Motor driver op 3m profile aangestuurd met Node-RED

<https://photos.app.goo.gl/ja1oeATHVVT5JXBd9>

<https://photos.app.goo.gl/M8mrGXpsKZv4E4em8>

Er wordt hier getest of de slider kan worden aangestuurd via de Node-Red
applicatie. Zoals in de filmpjes te zien werkt dit naar behoren en kan
de snelheid worden aangepast. Dit zal in het uiteindelijke model niet
het geval zijn maar op deze manier kan er een duidelijk beeld gecreëerd
worden over hoe snel de camera tussen de plantjes in kan bewegen.

## Test 3: Stepper motor test met gefreesde PCB

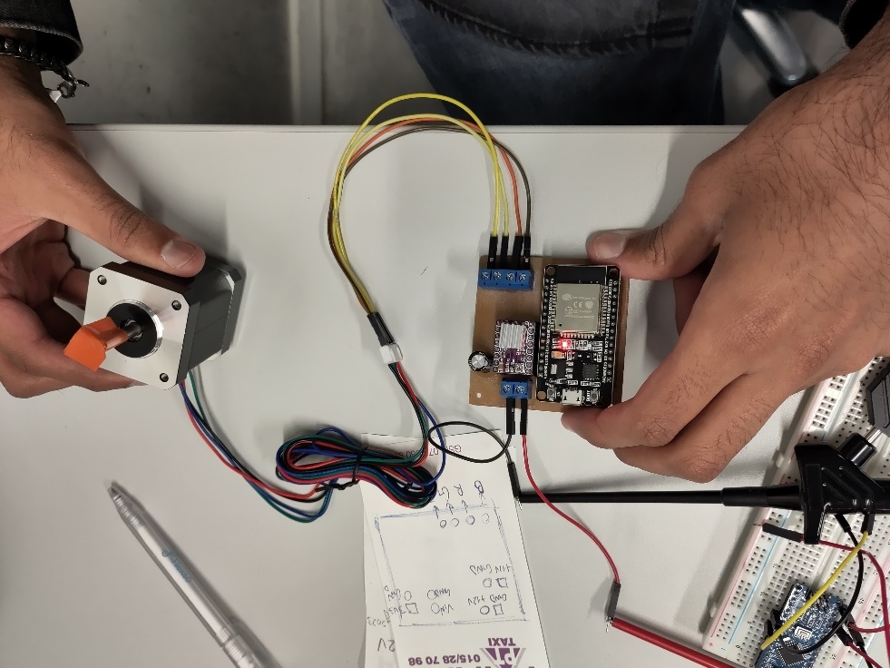
[picture p74: docs/assets/media/image82.jpeg]


Figuur 75: Test gefreesde PCB stepper motor

<https://photos.app.goo.gl/VeniHCkUg2wtQRb76>

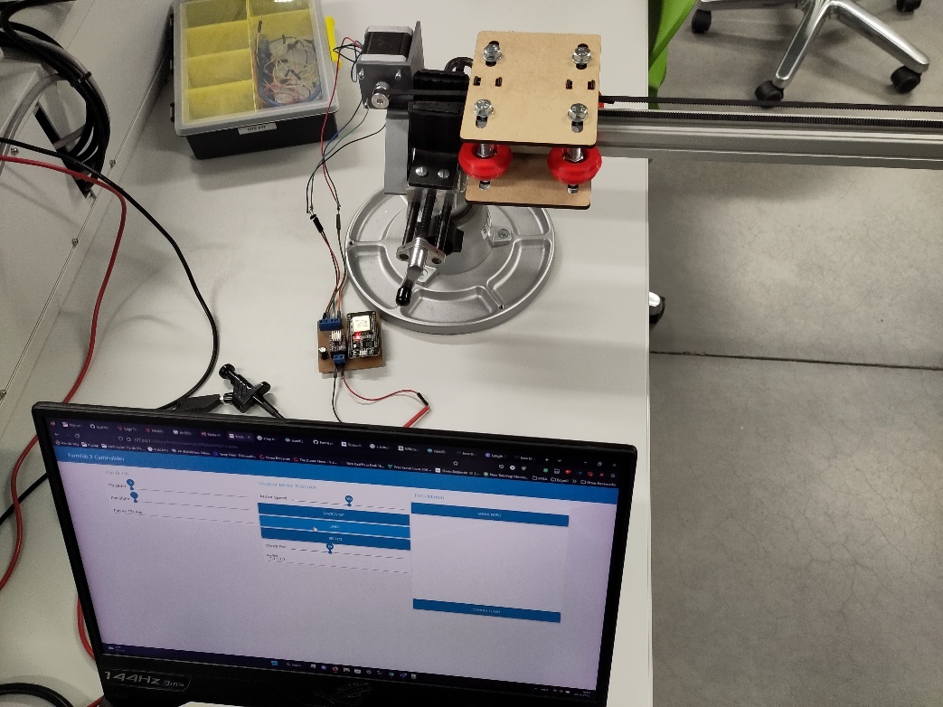
[picture p75: docs/assets/media/image83.jpeg]
A computer on a table Description automatically generated with low confidence


Figuur 76: Test gefreesde PCB stepper motor met slider

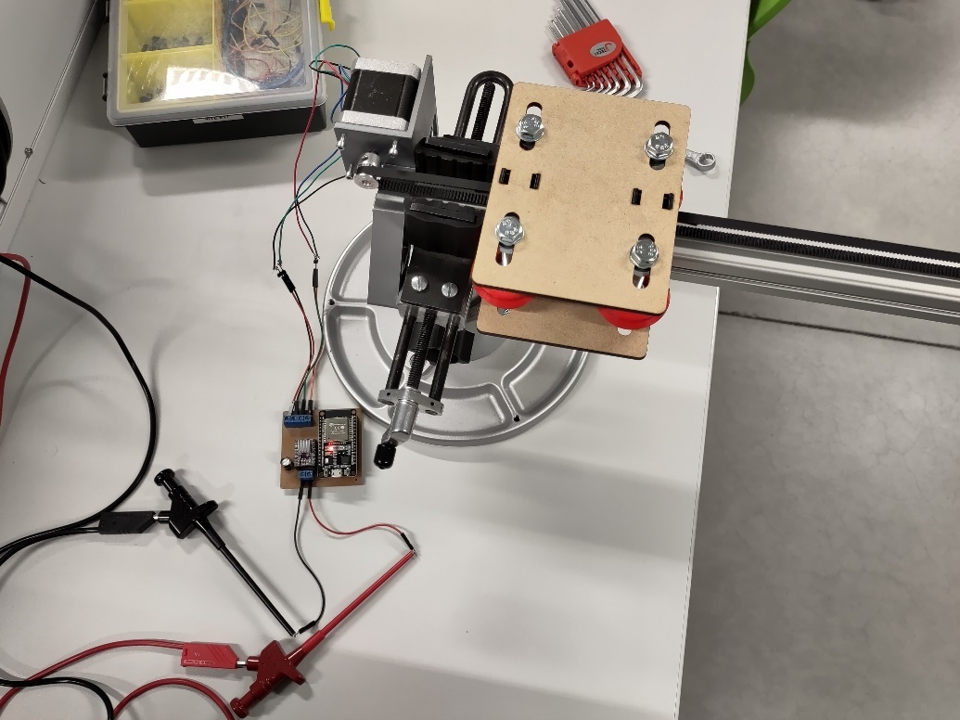
[picture p76: docs/assets/media/image84.jpeg]


Figuur 77: Test gefreesde PCB stepper motor met slider

<https://photos.app.goo.gl/pbeaiN2fKHeJNjBe6>

Na het maken van de gefreesde PCB gaan we deze testen. Eerst met de
stepper motor zelf zoals te zien is in de eerste foto en filmpje en
daarna met de slider. Zie volgende twee foto’s en filmpje.

Het werkt goed dus we weten dat de PCB correct is gemaakt.

## Test 4: Slider met camera op gefreesde PCB op statief

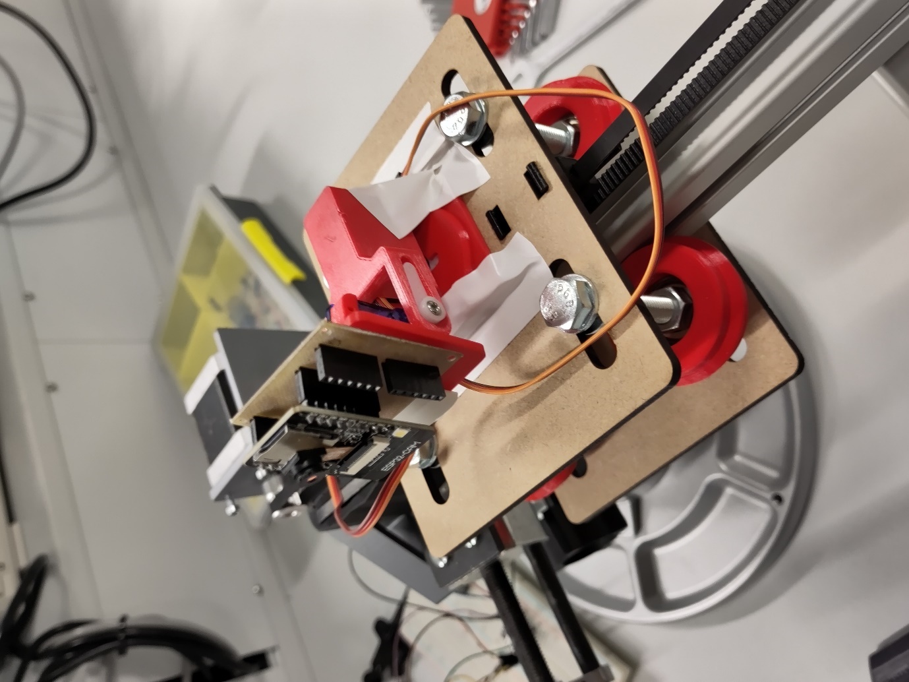
[picture p77: docs/assets/media/image85.jpeg]


Figuur 78: ESP32-cam op gefreesde PCB

<https://photos.app.goo.gl/LHdAPv8uz5sMvD2t9>

Er wordt getest of de ESP32-CAM stevig op de houder kan worden
gemonteerd als de ESP32-cam in de gefreesde houder zit.

## Test 5: Slider met automatisch nemen van foto’s

<https://photos.app.goo.gl/TGr6jPJ1vycB5qX99>

<https://photos.app.goo.gl/Z1j9QkFsgCPJeJFz9>

Bovenstaande video’s tonen het testen van de slider met de camera. Er
worden hier 6 getallen meegegeven. De getallen geven mee hoelang de
slider moet bewegen vooraleer er een foto wordt genomen. Het nemen van
de foto gebeurd automatisch nadat de slider de afstand heeft afgelegd.
Hierbij draait de camera houder ook van hoek om zo de drie verschillende
foto’s van een plant vanuit een verschillende hoek te representeren.
Nadat al de ingevoerde posities zijn afgegaan gaat de slider terug naar
de begin positie.

Het is te zien dat het nemen van de foto’s soms gebeurd tijdens dat de
slider al naar de volgende positie is aan het gaan.

Daarnaast moeten nu nog al de posities ingegeven worden. Dit wordt in de
toekomst ook nog aangepast om zo maar 2 posities in te geven en dat er
per positie 3 foto’s worden genomen.

## Test 6: Eindeloopschakelaar 

<https://photos.app.goo.gl/DYWfTXwDR6dwu6dx8>

Bovenstaand filmpje toont het testen van de eindeloopschakelaar
gemonteerd op de houder op de stand.

## Test 7: Afstand draadloos opladen

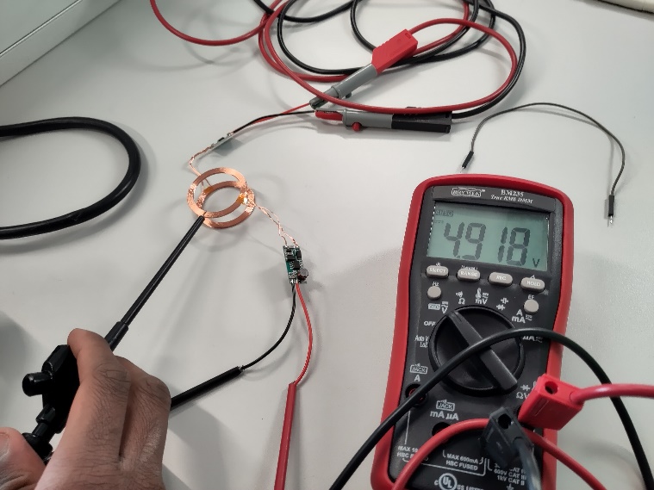
[picture p78: docs/assets/media/image86.jpeg]


Figuur 79: Testen afstand draadloos opladen

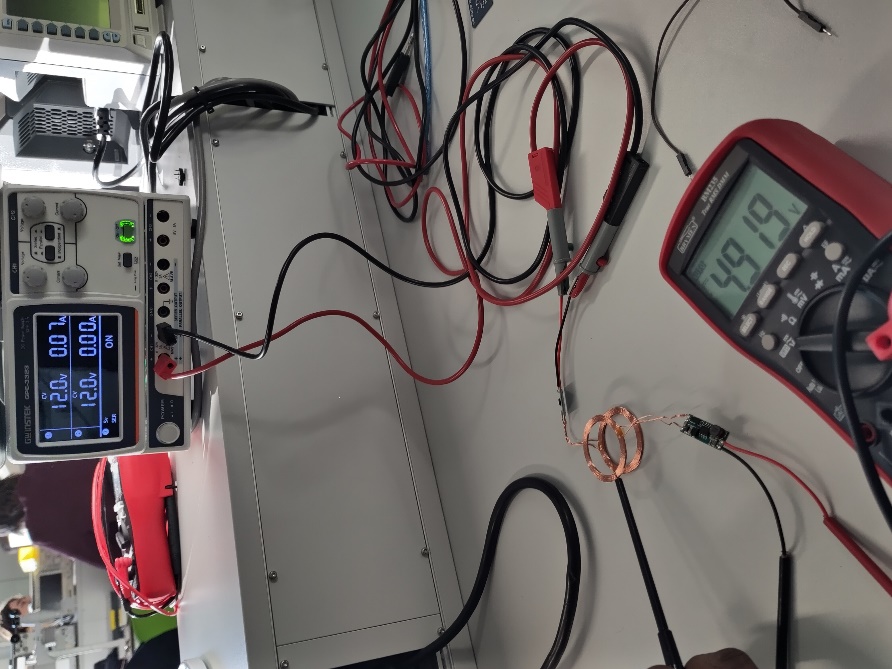
[picture p79: docs/assets/media/image87.jpeg]
A picture containing text, indoor Description automatically generated


Figuur 80: Testen afstand draadloos opladen

Er wordt getest hoe ver de twee cirkels van elkaar kunnen worden
geplaatst om toch nog voldoende spanning te krijgen.

## Test 8: Volledige schakeling

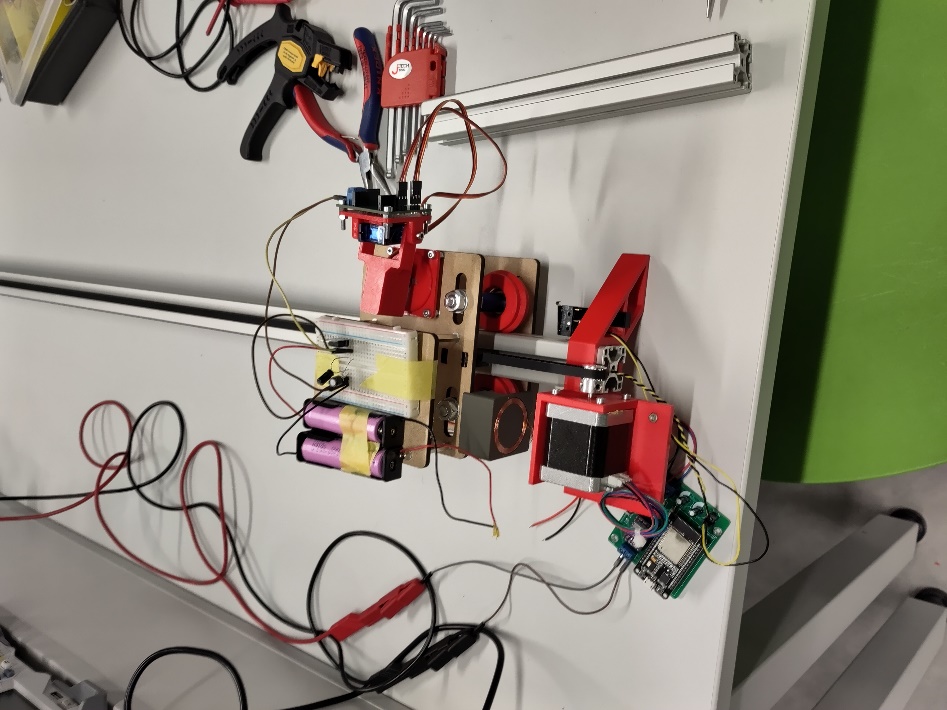
[picture p80: docs/assets/media/image88.jpeg]
A picture containing text, projector, automaton Description automatically generated


Figuur 81: Volledige schakeling

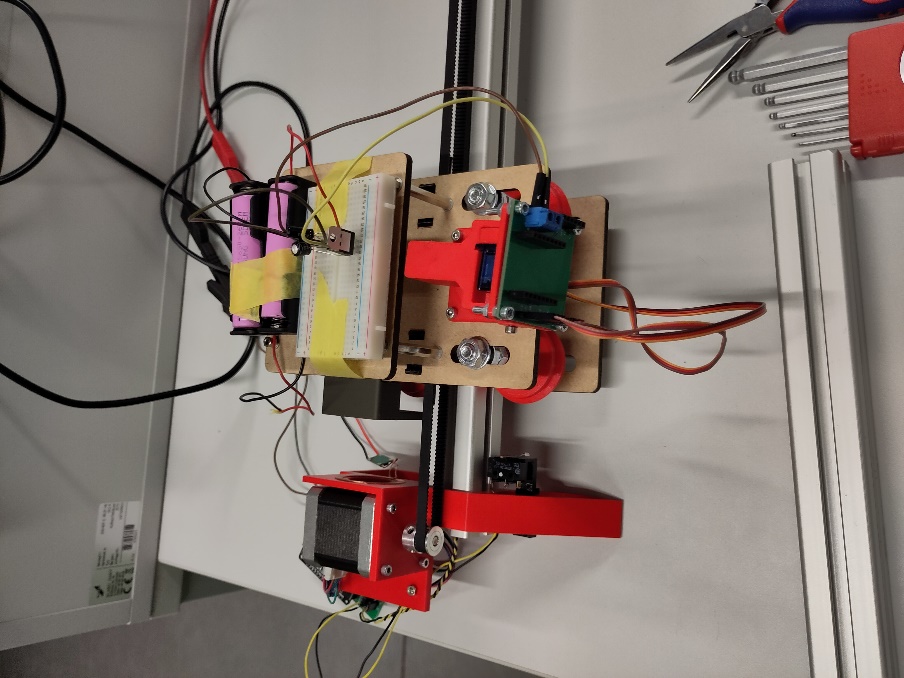
[picture p81: docs/assets/media/image89.jpeg]


Figuur 82: Volledige schakeling

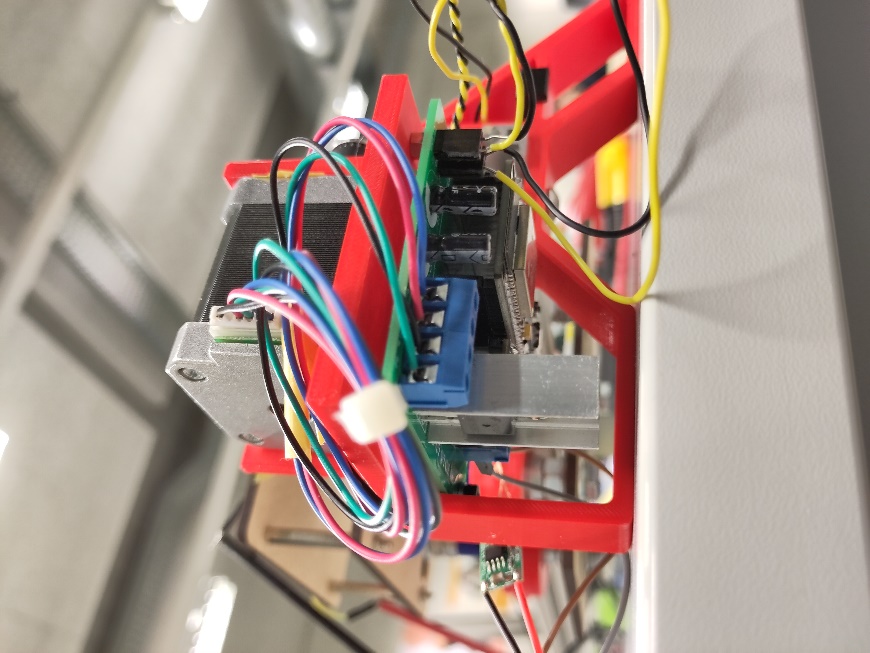
[picture p82: docs/assets/media/image90.jpeg]


Figuur 83: Bevestiging stepper motor PCB

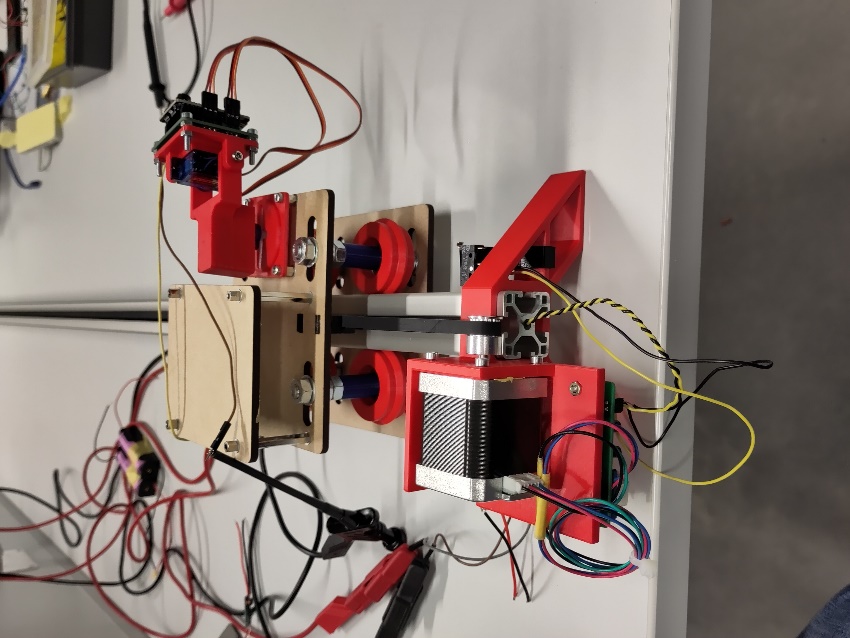
[picture p83: docs/assets/media/image91.jpeg]


Figuur 84: Volledige montatie stand 2

<https://photos.app.goo.gl/W4EuBgc2CXhcm9LG8>

De eerste twee foto’s tonen de volledige schakeling met alles erop en
eraan. Het breadboard wordt later nog aangepast. De derde foto toont hoe
de PCB wordt gemonteerd op de stand en de laatste foto toont de
schakeling van stand 2 nog eens.

In het filmpje is de volledige schakeling te zien en hoe deze werkt. Er
worden drie coördinaten ingegeven naar waar de slider moet bewegen. Op
deze coördinaten zal de camera drie foto’s nemen vanuit drie
verschillende hoeken. De foto’s worden direct doorgestuurd en kunnen
bekeken worden op de webpagina. Na het nemen van de foto’s op de voor
ingegeven coördinaten gaat de slider terug naar de begin positie.

## Test 9: Volledige schakeling V2.

De test 9 is hetzelfde test als de test 8, maar hier wordt de draadloos
oplader en een step up regulator toegevoegd op het bovenste verdiep.

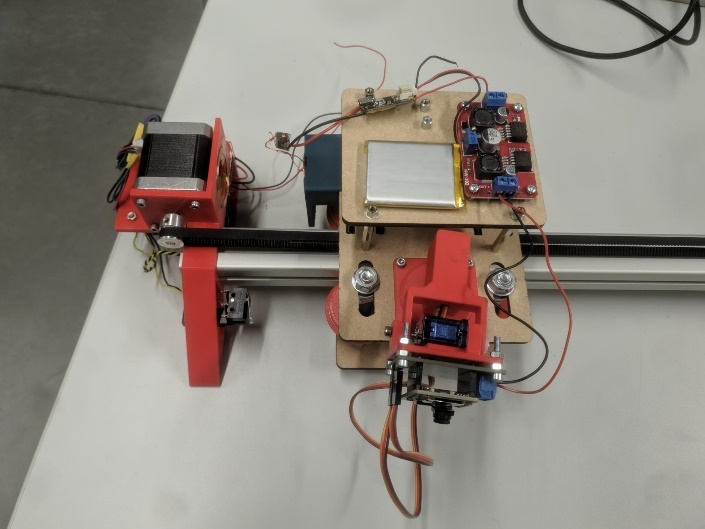
[picture p84: docs/assets/media/image92.jpeg]


Figuur 85: Volledige montatie stand met baterij en draadloos oplader

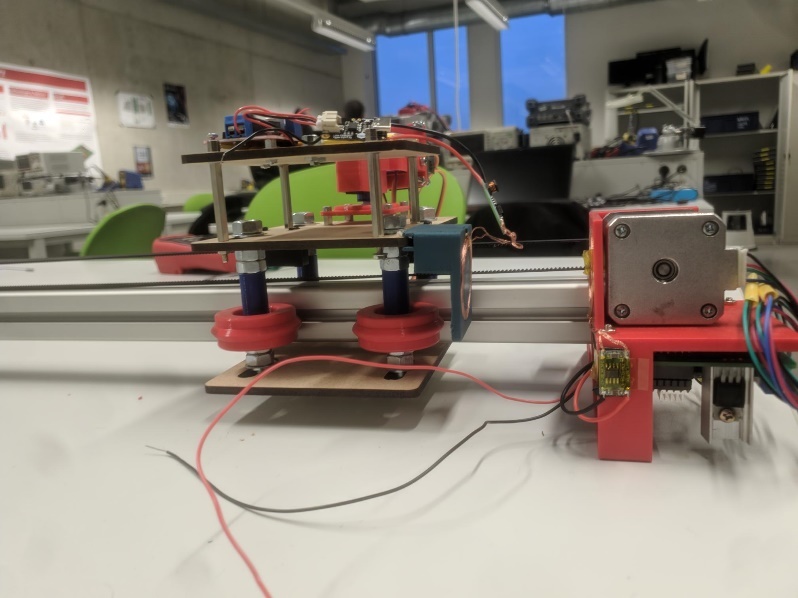
[picture p85: docs/assets/media/image93.jpeg]


Figuur 86: Achter aanzicht met draadloos oplader

#  Server configuratie en de implementatie van de camera slider op de server

Om de camera slider te instellen op een server is het noodzakelijk om
Node-RED en Mosquitto te installeren en configureren. Node-RED is een
visuele tool voor het bouwen van workflows voor IoT-applicaties waarmee
de gebruiker de ESP32-CAM, de servo's en de stepper motor kan
controleren en besturen. Mosquitto is een open-source MQTT-broker die
gebruikt wordt om communicatie tussen Node-RED en ESP32-CAM te
faciliteren.

De gebruiker moet eerst Node-RED en Mosquitto installeren op de server.
Daarna moet de gebruiker de software configureren zodat deze correct
communiceert met de ESP32-CAM, de servo's en de stepper motor. Dit kan
door de juiste instellingen te kiezen in de software bijvoorbeeld het
IP-adres en poortnummer van de ESP32-CAM.

## Installatie van Mosquitto

1\. Open een terminalvenster op uw Ubuntu-systeem.

2\. Voer de volgende opdracht uit om de Mosquitto-repository toe te
voegen aan uw systeem:

sudo apt-add-repository ppa:mosquitto-dev/mosquitto-ppa

3\. Voer de volgende opdracht uit om de package-index opnieuw in te
stellen:

sudo apt-get update

4\. Voer de volgende opdracht uit om Mosquitto te installeren:

sudo apt-get install mosquitto mosquitto-clients

5\. Voer de volgende opdracht uit om de Mosquitto-service te starten:

sudo service mosquitto start

6\. Voer de volgende opdracht uit om de Mosquitto-service automatisch te
starten bij het opstarten van uw systeem:

sudo systemctl enable mosquitto

7\. Voer de volgende opdracht uit om de status van de Mosquitto-service
te controleren:

sudo systemctl status mosquitto

8\. Voer de volgende opdracht uit om de configuratiebestanden van
Mosquitto te openen:

sudo nano /etc/mosquitto/mosquitto.conf

9\. Pas de configuratiebestanden aan. Je IP-adres vind je met commando
*hostname -I.*

allow_anonymous true

listener 1884 172.16.157.225

10\. Sla de configuratiebestanden op en voer deze commando uit en sluit
het terminalvenster.  
sudo service mosquitto restart

11\. Nu is Mosquitto geïnstalleerd en geconfigureerd op uw
Ubuntu-systeem.

Note: Je zult wellicht root of superuser rechten nodig hebben om
bovenstaande commando's uit te voeren.

## Instaleren van Node-RED

1\. Zorg ervoor dat Node.js geïnstalleerd is op uw Linux-systeem. Dit
kan worden gedaan door de volgende commando's in de terminal uit te
voeren:

curl -sL https://deb.nodesource.com/setup_14.x \| sudo -E bash -

sudo apt-get install -y nodejs

2\. Installeer Node-RED met behulp van npm, het
Node.js-pakketbeheerprogramma. Dit kan worden gedaan door het volgende
commando uit te voeren:

sudo npm install -g --unsafe-perm node-red

3\. Start Node-RED met het volgende commando:

node-red

4\. Open uw webbrowser en ga naar http://localhost:1884 om toegang te
krijgen tot de Node-RED-flow-editor.

Als alles goed loopt moet je het volgend beeld kunnen zien:

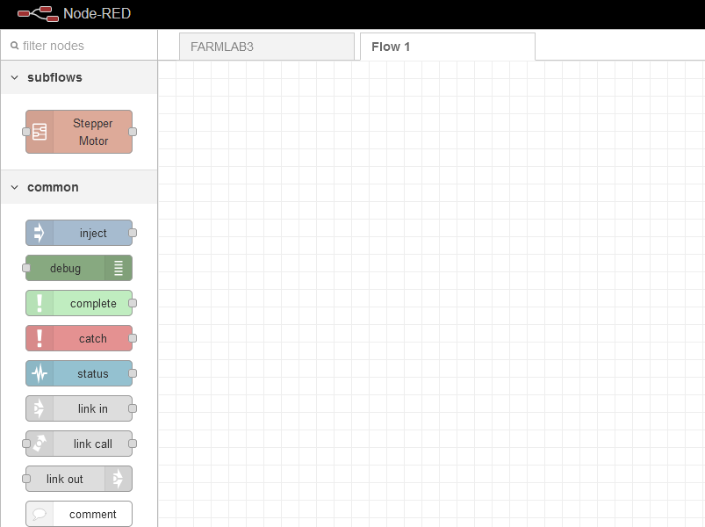
[picture p86: docs/assets/media/image94.png]
Table Description automatically generated


Figuur 87: Node-RED flow editor

## Importeren van node red flow

1.  Ga naar volgende GitHub link en kopieer de json file inhouden.

<https://github.com/NithujanSel/FarmLabCameraSlider/tree/main/software/infrastructure/node-red>

2.  Klik op 3 balk rechts boven en dan klik op import.

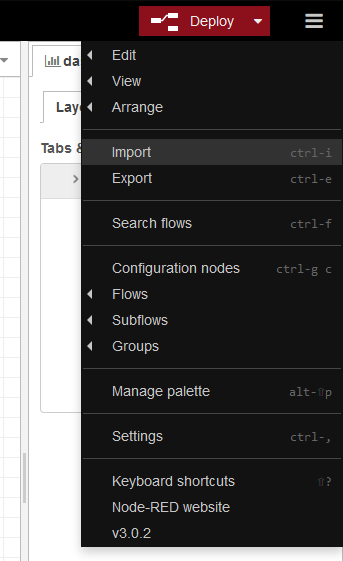
[picture p87: docs/assets/media/image95.png]


Figuur : Importeren bij Node-RED

3.  Plak de json tekst en klik op import.

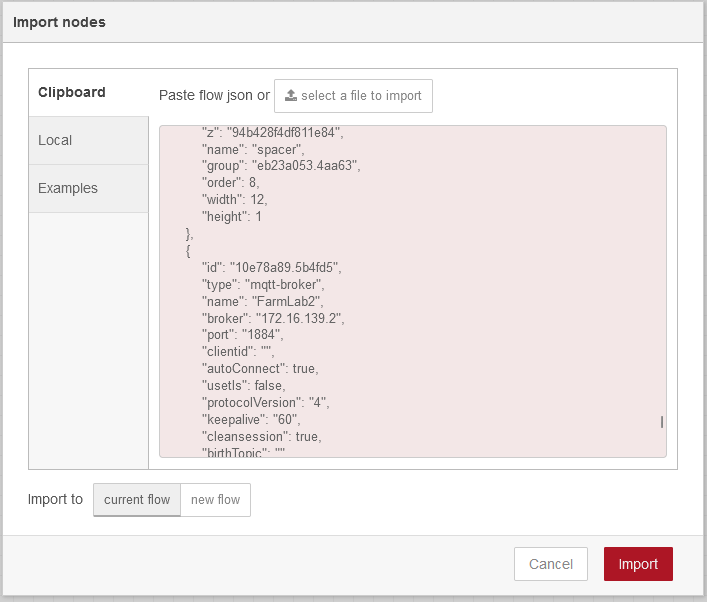
[picture p88: docs/assets/media/image96.png]


Figuur : Toevoegen van json tekst

4.  Klik op Farmlab2/slider/pan en de klik op de potlood symbool.

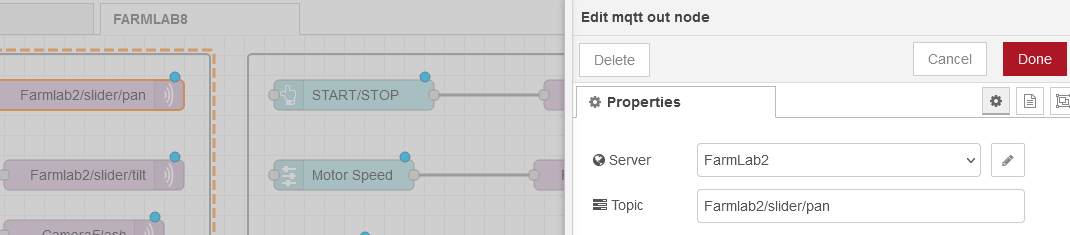
[picture p89: docs/assets/media/image97.png]


Figuur : Verbinden met server

5.  Nu heb je deze interface en verander de server IP naar je eigen
    server IP en de port naar 1884. Dan klik op update.

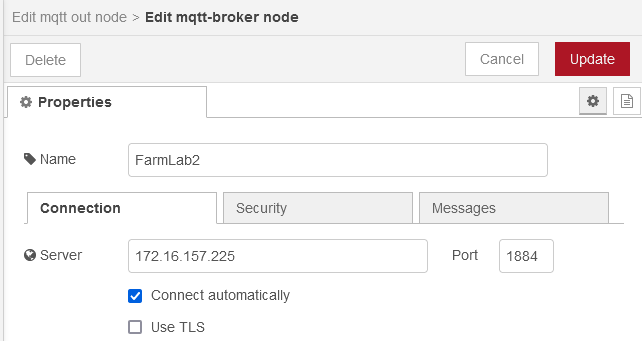
[picture p90: docs/assets/media/image98.png]


Figuur : Ingeven van IP-adres

6.  Ga naar de image path flow en klik daarop. Verander de URL bij var
    path variable waar je de foto wilt opslaan.

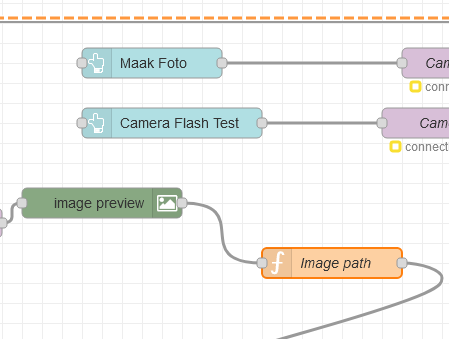
[picture p91: docs/assets/media/image99.png]


Figuur : Image path blok

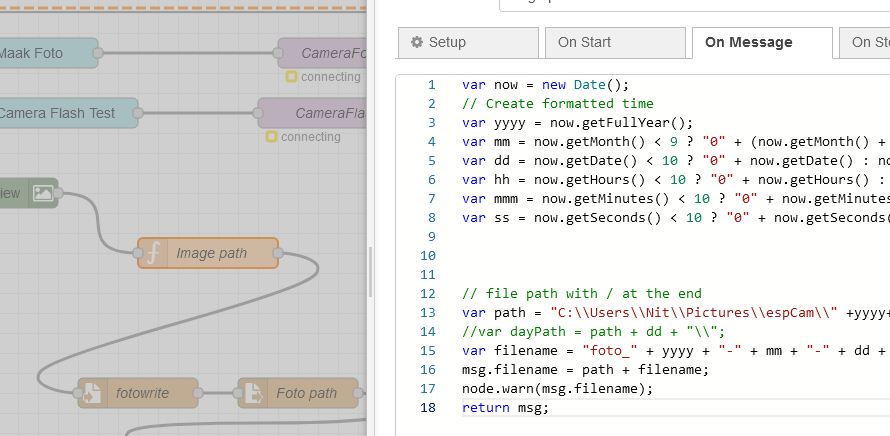
[picture p92: docs/assets/media/image100.png]
Graphical user interface, text, application, chat or text message Description automatically generated


Figuur : Aanpassen van URL

7.  Daarna klik op “Deploy” knop rechts boven. Nu ben je klaar met de je
    Node-RED en MQTT. Je kunt de grafische interface zien via deze link:
    http://localhost:1884/ui.

> Hierna moet je bij de ESP32-CAM en Dev Board code de server IP en de
> port aanpassen. Volg deze stappen.

1.  Ga naar deze link. Hier staat de code voor ESP32-cam en de ESP32 Dev
    Board.

<https://github.com/NithujanSel/FarmLabCameraSlider/tree/main/software/rail-controller>

2.  Pas daar je wifi naam, password, MQTT server IP en MQTT poort. Het
    moet zelfde wifi zijn waarmee je server verbonden is.

Text Description automatically generated

Figuur : Configureren van wifi en MQTT

3.  Dan kun je deze code opslaan en uploaden naar je ESP32-cam en ESP32
    Dev Board.

Om ESP32 te programmeren moet je eerst deze stappen volgen.

1.  Ga in je Arduino IDE naar Bestand Voorkeuren.

2.  Typ het volgende in het veld "Extra Board Manager-URL's" en klik op
    ok:

<https://raw.githubusercontent.com/espressif/arduino-esp32/gh-pages/package_esp32_index.json>

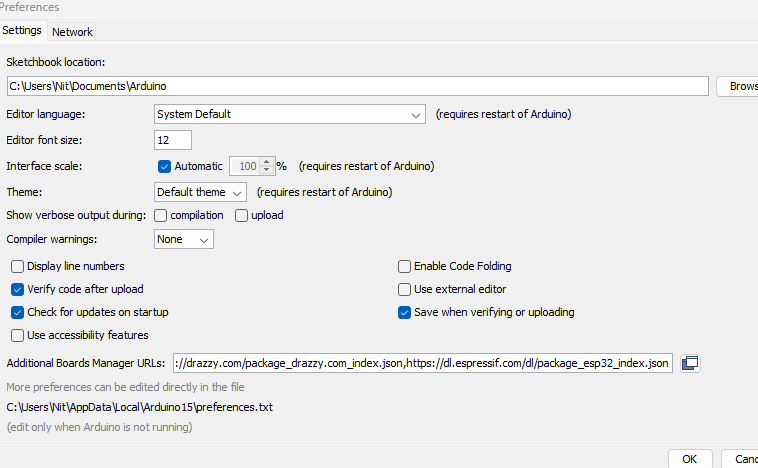
[picture p93: docs/assets/media/image103.png]


Figuur : Invoegen van URL

3.  Open de Boards Manager. Ga naar Extra Bord Bordbeheer.

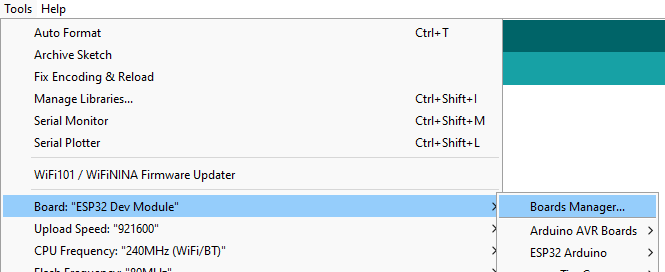
[picture p94: docs/assets/media/image104.png]


Figuur : Openen van Boards Manager

4.  Zoek naar ESP32 en druk op de installatieknop voor de "ESP32 by
    Espressif Systems":

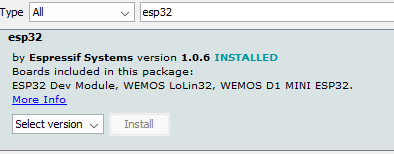
[picture p95: docs/assets/media/image105.png]


Figuur : Instaleren van ESP32 bibliotheek

5.  Selecteer je bord in Tools Board-menu (voor ESP32 Dev Board DOIT
    ESP32 DEVKIT V1 voor ESP32-CAM is ESP32 Dev Model)

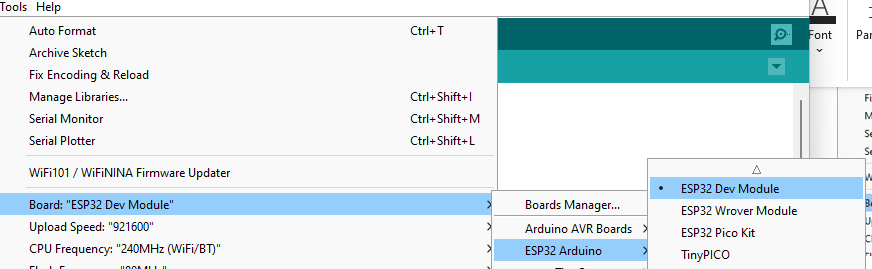
[picture p96: docs/assets/media/image106.png]
Graphical user interface Description automatically generated with medium confidence


Figuur : Kiezen van de ESP32-CAM

6.  Voor ESP32-CAM moet je deze schakeling maken.

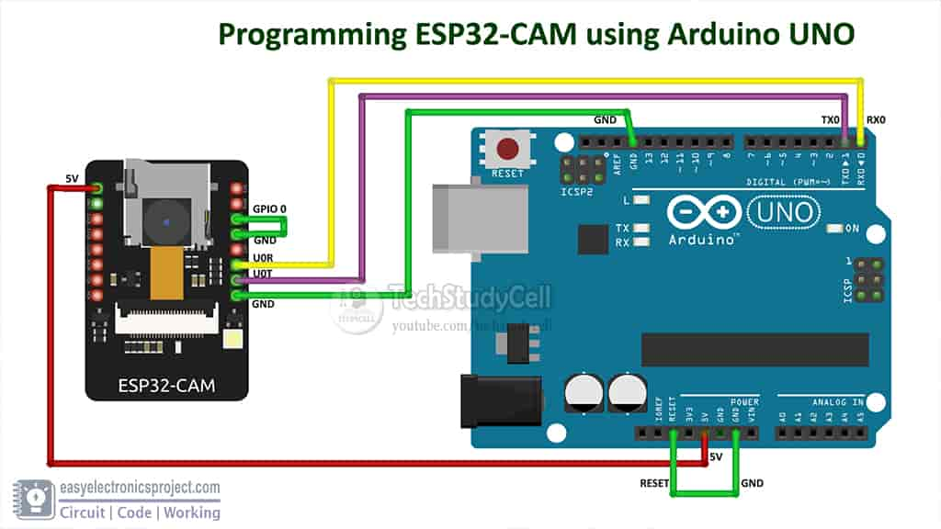
[picture p97: docs/assets/media/image107.jpeg]
Program ESP32-CAM using Arduino UNO - Electronics Projects


Figuur : Schakeling van ESP32-CAM

7.  Kies de juiste COM port en klik op uploaden.

Na dit moet je via Node-RED interface je stepper motor, ESP32-CAM en het
pan en tilt systeem instaleren. Volg deze stappen uit om de interface te
configureren.

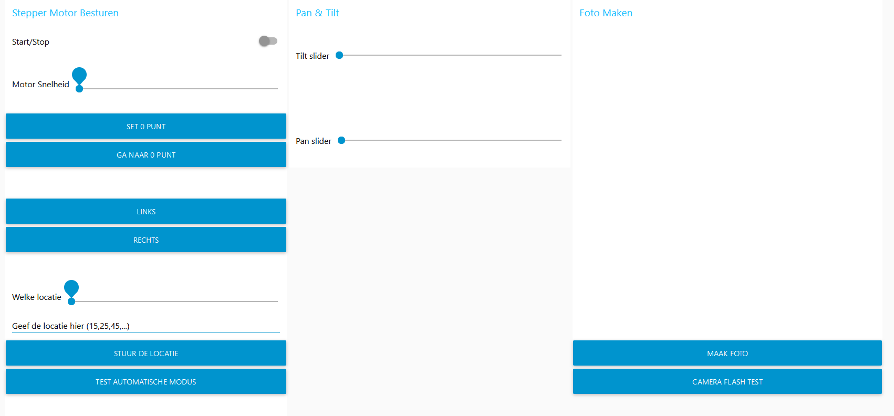
[picture p98: docs/assets/media/image108.png]
>  alt="Graphical user interface, application Description automatically generated" />

Figuur : Webpagina met Node-RED

> Klik op camera flash test om te kijken of het verbonden is met de MQTT
> server.

1.  In het pan- en tilt gedeelte selecteer je de juiste positie van de
    servo zodat de plant zichtbaar is op de camera. Nadat je dit hebt
    aangepast, controleer je of de juiste locatie is gekozen met behulp
    van de knop 'maak foto'. Indien nodig pas je de positie aan.

2.  In het gedeelte voor de stappenmotor zet je deze aan door op de
    start/stop knop te drukken.

3.  Je kiest de juiste snelheid voor de stappenmotor via de slider,
    bijvoorbeeld 650.

4.  Je kiest het nulpunt via de knop 'set 0 punt'. Als deze niet op de
    juiste positie staat kun je deze aanpassen door links en rechts te
    bewegen met de knop.

5.  Met de 'welke locatie' slider kun je de coördinaten van de plant
    vinden door een locatie te kiezen. Als je een locatie kiest zal de
    slider zich naar die locatie verplaatsen.

6.  Als je de juiste locatie hebt gevonden noteer je deze in het
    tekstveld "Geef de locatie hier (15,25,46)". Dit is een voorbeeld
    van een set coördinaten (plant1,plant2,plant3,…): (15,25,68,…).

7.  Je stuurt de coördinaten naar het ESP32-Dev Board via de knop "stuur
    de locatie".

8.  Je klikt op de knop "Test automatische modus" om te controleren of
    de automatische fotografie van alle planten correct uitgevoerd
    wordt. Hierbij worden drie foto's genomen van verschillende hoeken
    (120, 90 en 60 graden).

9.  Als alles goed functioneert kun je verdergaan met herhaling van
    stappen 2 tot en met 8 voor andere planten.

10. Wanneer alles is afgerond zal de Node-RED automatisch om 8:00, 12:00
    en 18:00 foto's nemen. Dit zal hetzelfde proces volgen als de knop
    "Test automatische modus"."

# Bronvermelding

Thingiverse.com. (2015, 4 maart). Mini Pan Tilt - Servo G9 by fbuenonet.
Geraadpleegd op 27 september 2022, van
<https://www.thingiverse.com/thing:708819>

Programming with Mosh. (2021, 30 maart). *Docker Tutorial for Beginners*
\[Video\]. Geraadpleegd op 28 oktober 2022, van
https://www.youtube.com/watch?v=pTFZFxd4hOI

Education, I. C. (2022, 17 juni). *Docker*. Geraadpleegd op 28 oktober
2022, van https://www.ibm.com/cloud/learn/docker

*Overview*. (2022, 28 oktober). Geraadpleegd op 28 oktober 2022, van
<https://docs.docker.com/desktop/use-desktop/>

*Manual installation steps for older versions of WSL*. (2022, 27 juni).
Geraadpleegd op 28 oktober 2022, van
https://learn.microsoft.com/en-gb/windows/wsl/install-manual

*Install Docker Desktop on Windows*. (2022, 28 oktober). Geraadpleegd op
28 oktober 2022, van
<https://docs.docker.com/desktop/install/windows-install/>

https:\\\\randomnerdtutorials.com\\author\\rui-santos\\#author. (2019b,
juli 5). Installing ESP32 in Arduino IDE (Windows, Mac OS X, Linux).
Random Nerd Tutorials. Geraadpleegd op 9 januari 2023, van
https://randomnerdtutorials.com/installing-the-esp32-board-in-arduino-ide-windows-instructions/

techstudycell. (2020b, oktober 27). Program ESP32-CAM using Arduino UNO.
Electronics Projects. Geraadpleegd op 11 januari 2023, van
https://easyelectronicsproject.com/esp32-projects/program-esp32cam-arduino/
