NithujanSel/CameraSliderFarmLabAI/docs/assets/media/image51.png

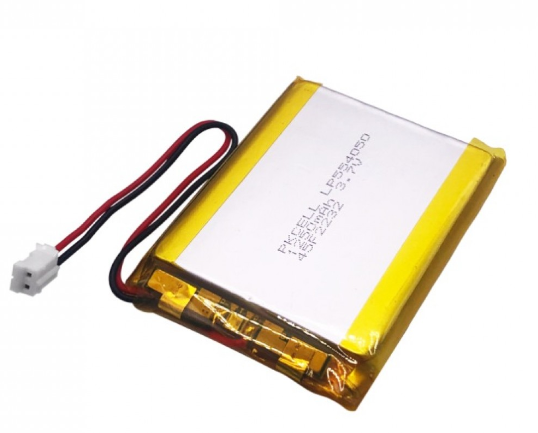
docs/assets/media/image51.png
