NithujanSel/CameraSliderFarmLabAI/docs/assets/media/image74.jpeg

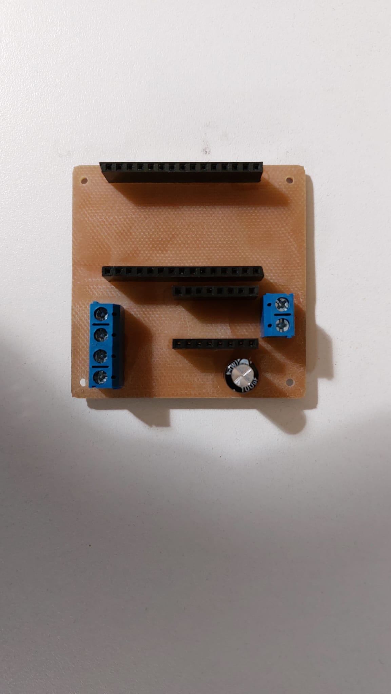
docs/assets/media/image74.jpeg
