NithujanSel/CameraSliderFarmLabAI/hardware/pcb/ESP32Cam/ESPcamPCBV2.kicad_pcb

## KiCad design hardware/pcb/ESP32Cam/ESPcamPCBV2.kicad_pcb (2023-01-19)

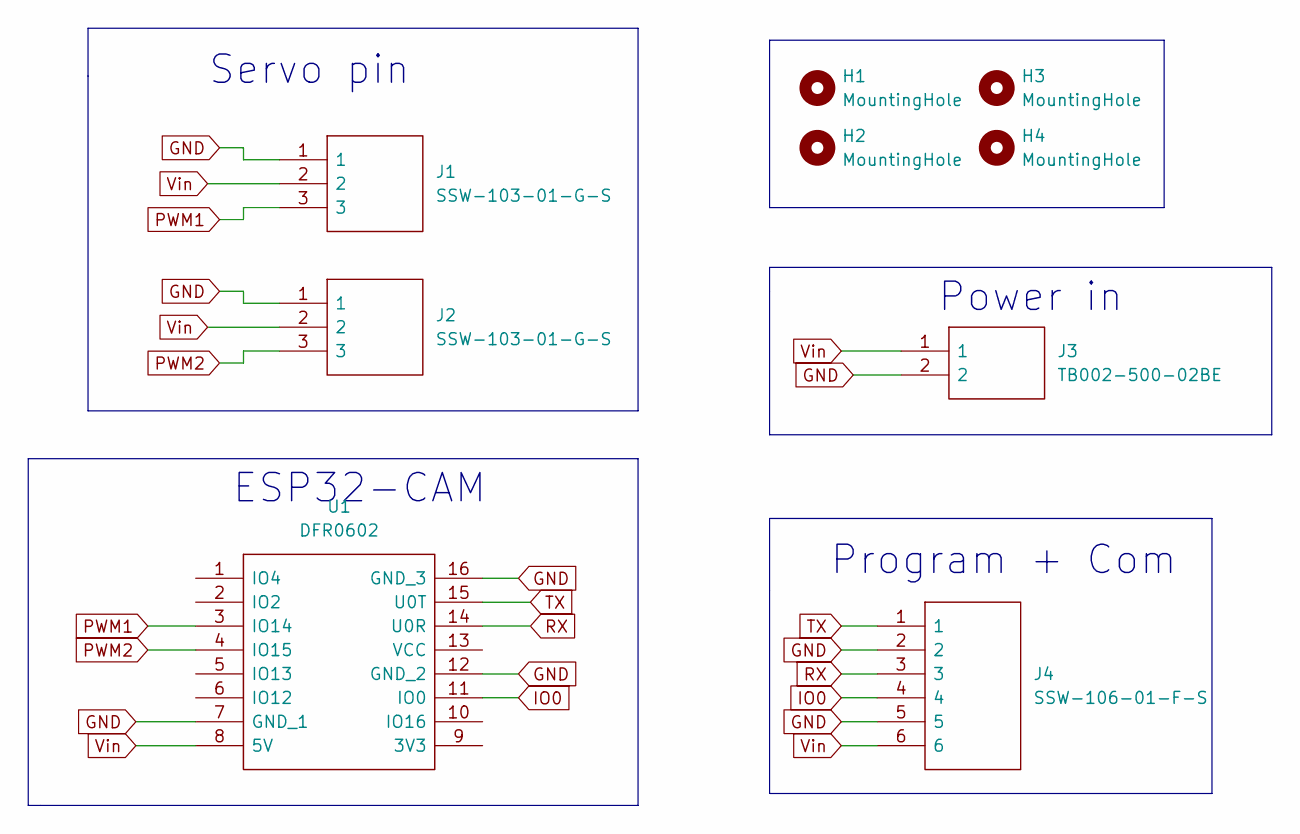
[picture p101: schematic ESPcamPCBV2.kicad_sch]

Parts:
H1, H2, H3, H4: MountingHole; MountingHole_3.2mm_M3
J1, J2: SSW-103-01-G-S; RHDR3W64P0X254_1X3_813X241X851P; Manufacturer_Part_Number SSW-103-01-G-S; Mouser Part Number 200-SSW10301GS
J3: TB002-500-02BE; TB00250002BE; Manufacturer_Part_Number TB002-500-02BE; Mouser Part Number 490-TB002-500-02BE
J4: SSW-106-01-F-S; RHDR6W79P0X254_1X6_1575X241X851P; Manufacturer_Part_Number SSW-106-01-F-S; Mouser Part Number 200-SSW10601FS
U1: DFR0602; Manufacturer_Part_Number DFR0602; Mouser Part Number 426-DFR0602

Connections:
GND: J1.1, J2.1, J3.2, J4.2, J4.5, U1.7 (GND_1), U1.12 (GND_2), U1.16 (GND_3)
IO0: J4.4, U1.11 (IO0)
PWM1: J1.3, U1.3 (IO14)
PWM2: J2.3, U1.4 (IO15)
RX: J4.3, U1.14 (U0R)
TX: J4.1, U1.15 (U0T)
Vin: J1.2, J2.2, J3.1, J4.6, U1.8 (5V)

Notes on the sheet:
Servo pin
ESP32-CAM
Power in
Program + Com

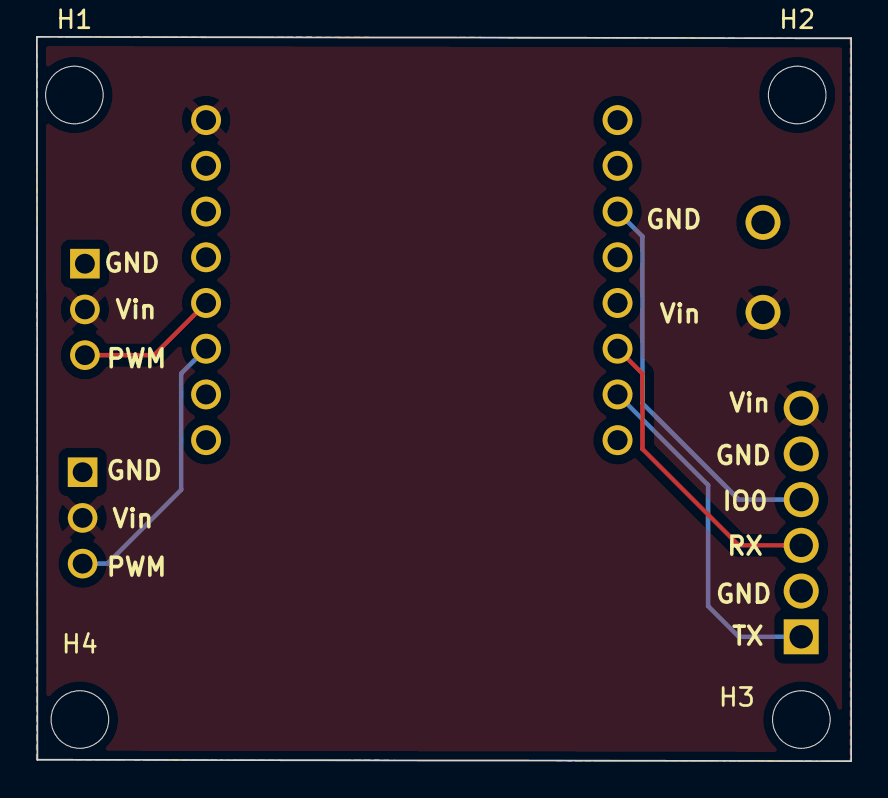
[picture p102: board ESPcamPCBV2.kicad_pcb from above]

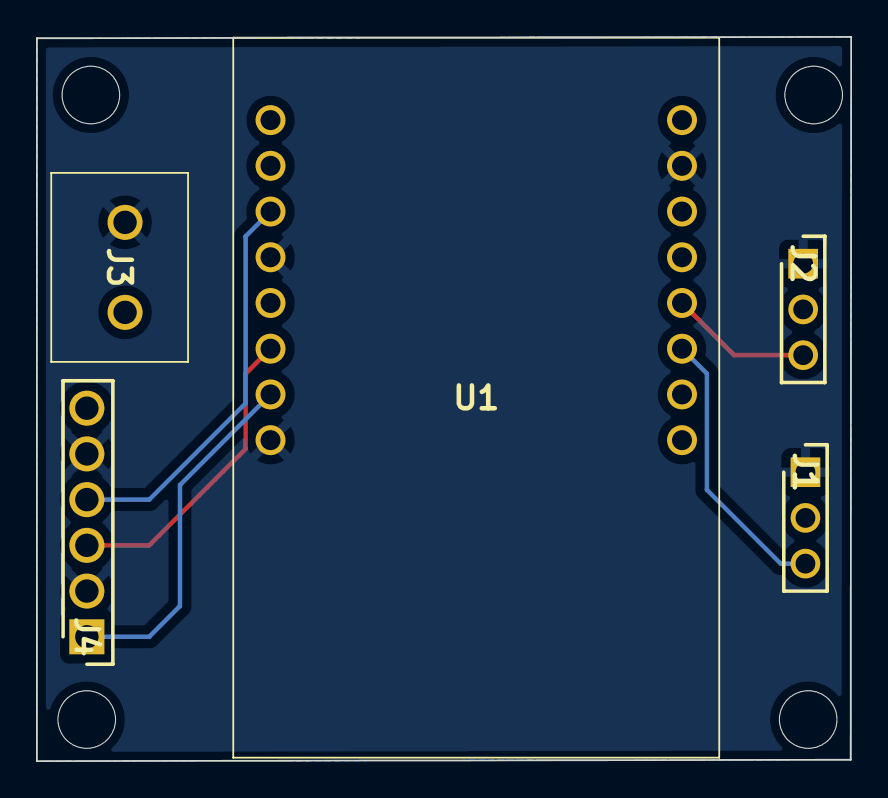
[picture p103: board ESPcamPCBV2.kicad_pcb from below]

Board: 2 copper layers, 45.2 x 40.2 mm, 9 parts (5 on the bottom side), 7 nets.
