NithujanSel/CameraSliderFarmLabAI/hardware/pcb/StepperMotor/stepper motor pcb V3.0.kicad_pcb

## KiCad design hardware/pcb/StepperMotor/stepper motor pcb V3.0.kicad_pcb (2023-01-19)

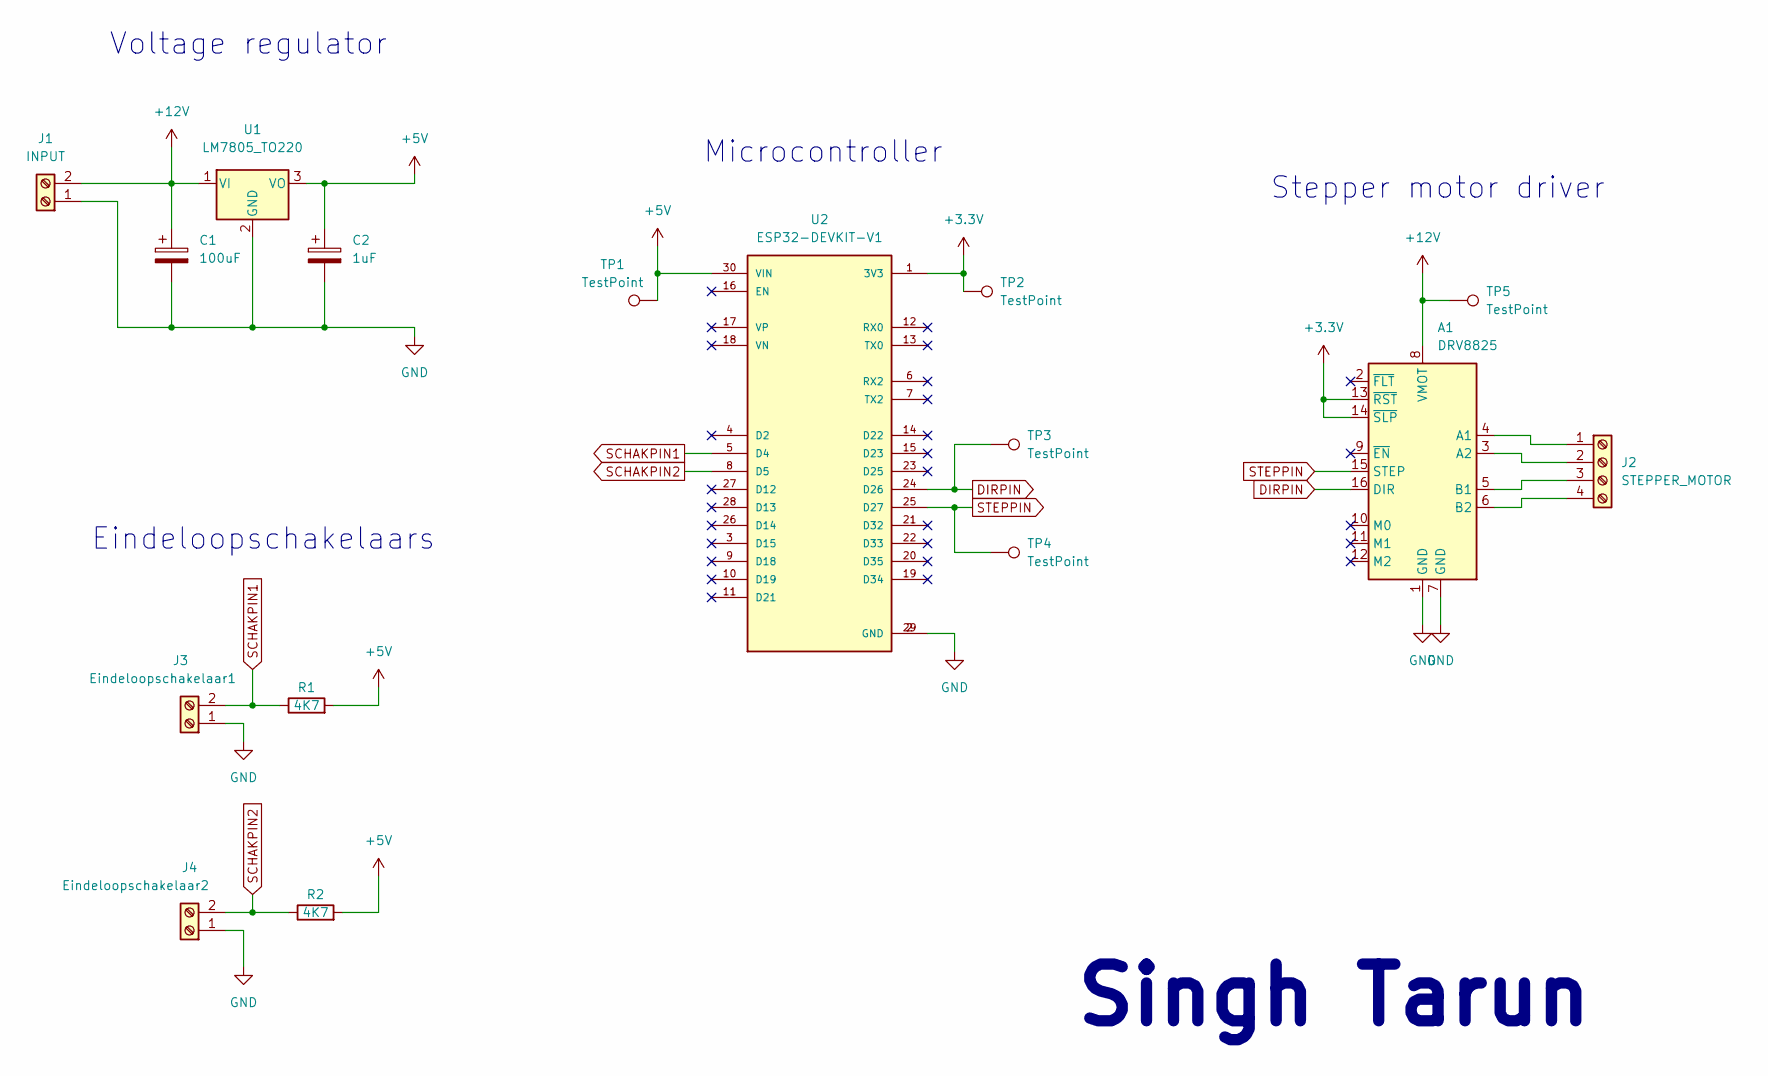
[picture p104: schematic stepper motor pcb V3.0.kicad_sch]

Parts:
A1: DRV8825; Pololu_Breakout-16_15.2x20.3mm
C1: 100uF; CP_Radial_D10.0mm_P3.80mm
C2: 1uF; CP_Radial_D10.0mm_P3.80mm
J1: INPUT; TerminalBlock_bornier-2_P5.08mm
J2: STEPPER_MOTOR; TerminalBlock_bornier-4_P5.08mm
J3: Eindeloopschakelaar1; PinHeader_1x02_P2.54mm_Vertical
J4: Eindeloopschakelaar2; PinHeader_1x02_P2.54mm_Vertical
R1, R2: 4K7; R_Axial_DIN0309_L9.0mm_D3.2mm_P15.24mm_Horizontal
TP1, TP2, TP3, TP4, TP5: TestPoint; TestPoint_Pad_D2.0mm
U1: LM7805_TO220; TO-220-3_Vertical
U2: ESP32-DEVKIT-V1; ESP32_DEVKIT_V1; PARTREV N/A

Connections:
+3.3V: A1.13 (~RST), A1.14 (~SLP), TP2.1, U2.1 (3V3)
+5V: C2.1, R1.2, R2.2, TP1.1, U1.3 (VO), U2.30 (VIN)
+12V: A1.8 (VMOT), C1.1, J1.2, TP5.1, U1.1 (VI)
DIRPIN: A1.16 (DIR), TP3.1, U2.24 (D26)
GND: A1.1 (GND), A1.7 (GND), C1.2, C2.2, J1.1, J3.1, J4.1, U1.2 (GND), U2.2 (GND), U2.29 (GND)
unnamed: A1.4 (A1), J2.1
unnamed: A1.3 (A2), J2.2
unnamed: A1.5 (B1), J2.3
unnamed: A1.6 (B2), J2.4
SCHAKPIN1: J3.2, R1.1, U2.5 (D4)
SCHAKPIN2: J4.2, R2.1, U2.8 (D5)
STEPPIN: A1.15 (STEP), TP4.1, U2.25 (D27)

Notes on the sheet:
Microcontroller
Stepper motor driver
Voltage regulator
Eindeloopschakelaars
Singh Tarun

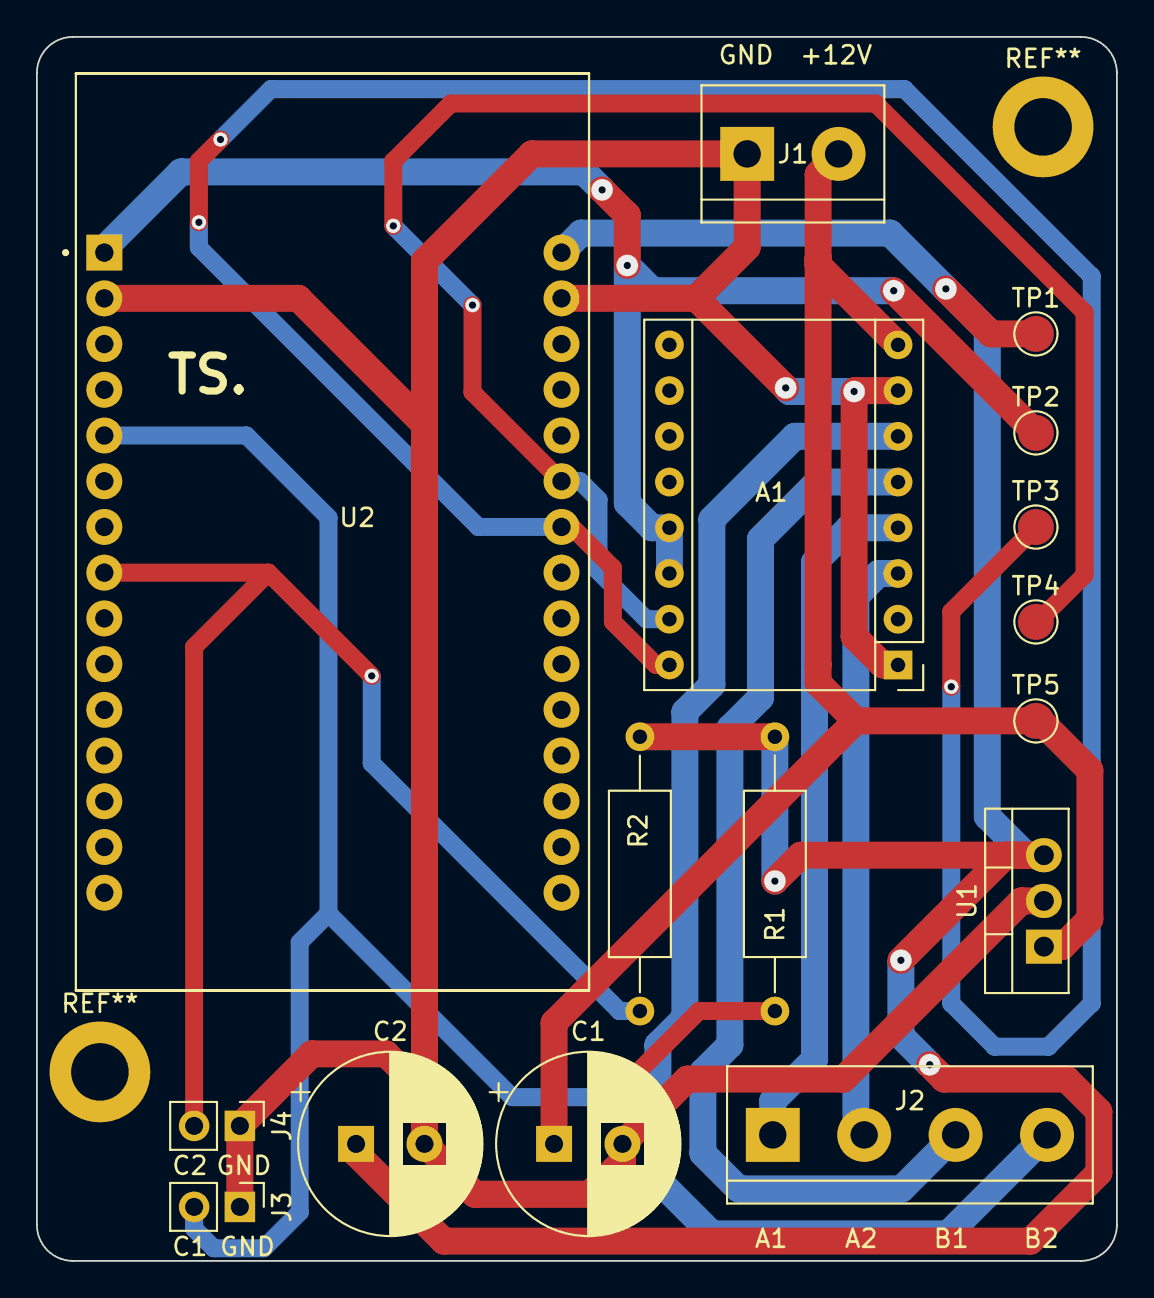
[picture p105: board stepper motor pcb V3.0.kicad_pcb from above]

Board: 2 copper layers, 60.0 x 68.0 mm, 16 parts (0 on the bottom side), 12 nets.
