NithujanSel/CameraSliderFarmLabAI/(commit log)

2023-01-19 Versie 1
    [ESPCamPCB.kicad_pcb]
2023-01-19 Laaster Versie v2
    [ESPCamPCB.kicad_pcb, ESPcamPCBV2.kicad_pcb, ESPcamPCBV2.kicad_sch, stepper motor pcb V3.0.kicad_pcb, stepper motor pcb V3.0.kicad_sch]
